Darklirah/One-of-a-Kind-Mars-Rover/Fertigung/README.md

# Fertigungsdaten

> [!CAUTION]
> ## Diese Daten sind **nicht voll funktionsfähig** — bitte nicht bestellen
>
> Die erste Platine ist gebaut und **enthält Fehler**. Am Muster gefunden:
>
> * der **Akkuanschluss J2 ist verpolt**
> * die Stiftleisten für **MPU-6050 (U6)** und **VL53L0X (U7)** sitzen
>   **180° verdreht**; bei U7 sind zusätzlich **SCK und SDA vertauscht**
> * **U2** und **U5** passen nicht zur Pinbelegung der tatsächlich
>   gekauften Module
> * der Schalter **S1** braucht ein anderes Footprint
>
> Die vollständige Liste steht im
> [Projekt-Log](../00_Projekt-Log.md#nächste-platinenrevision--befundliste-nutzer-21102026).
>
> **Diese Fehler sind in den Gerbern dieses Ordners noch enthalten.**
> Sie werden in einer neuen, nummerierten Revision behoben; bis dahin
> taugen die Daten zum Ansehen und Nachvollziehen, nicht zum Fertigen.
>
> Dass das DRC sauber durchläuft, heißt nur, dass das Layout **in sich**
> stimmig ist — nicht, dass die Anschlüsse zu den Modulen passen. Genau
> deshalb steht in der Befundliste: Layout 1:1 ausdrucken und mit den
> echten Modulen gegenprüfen.
>
> **Die Firmware ist davon nicht betroffen** und läuft auf einem nackten
> ESP32-DevKit.

**Alles in diesem Ordner ist erzeugt.** Die Quelle ist `pcb/MarsRover.kicad_pcb`.
Nach jeder Änderung an der Platine neu erzeugen:

```bash
bash Fertigung/erzeuge_fertigungsdaten.sh
```

Sonst liegen hier Gerber, die nicht mehr zur Platine passen — das ist der
klassische Weg, eine falsche Platine zu bestellen.

**Stand: 21.10.2026 — in Bearbeitung.** Das Layout läuft mit 0 DRC-Fehlern
und 0 unverbundenen Elementen durch, hat aber die oben genannten
Anschlussfehler. Eine korrigierte Revision ist in Arbeit.

---

## 1 · Was wohin gehört

| Datei | Wofür |
|---|---|
| `MarsRover-gerber.zip` | **Das lädst du beim Leiterplattenhersteller hoch.** Enthält alle Gerber, beide Bohrdateien und die Bohrpläne |
| `MarsRover-pastenschablone.zip` | Für den Schablonenhersteller: `F_Paste` + `Edge_Cuts` als Gerber, dazu DXF und SVG |
| `MarsRover-stueckliste.csv` | Einkaufsliste, nach Wert und Bauform gruppiert |
| `MarsRover-bestueckung.csv` | Bestückungsdaten (Referenz, Wert, Bauform, X, Y, Drehung, Seite) — nur nötig, wenn du maschinell bestücken lässt |
| `MarsRover-platine.step` | 3D-Modell der **nackten** Platine für den Entwurf des Basismoduls |
| `gerber/`, `pastenschablone/` | derselbe Inhalt unverpackt, zum Nachsehen |

Das vollständige 3D-Modell **mit** Bauteilen liegt unter
`local_Step Files/MarsRover-komplett.step` und bleibt lokal: es enthält
Fremdmodelle aus den KiCad- und Espressif-Bibliotheken, die nicht unsere zum
Weitergeben sind.

---

## 2 · Bestellparameter

| | |
|---|---|
| Lagen | **2** |
| Maße | **70 × 52 mm** |
| Dicke | **1,0 mm** — nicht 1,6 mm, das spart gut 4 g, und Masse ist auf diesem Gerät das Hauptproblem |
| Kupfer | 35 µm (1 oz) |
| Dünnste Leiterbahn | **0,40 mm** |
| Kleinster Abstand | **0,20 mm** |
| Durchkontaktierungen | 91 Stück: 0,8/0,4 mm (88×), 0,7/0,4 (2×), 0,6/0,4 (1×) |
| Kleinste Bohrung | **0,40 mm** (Durchkontaktierungen), 0,75 mm bei Bauteilen |
| Nicht durchkontaktierte Löcher | 6 (Mechanik von OS1/OS2 und S1) |
| Oberfläche | **noch nicht entschieden** — siehe unten |
| Lötstopp / Siebdruck | freie Wahl, elektrisch egal |
| Masseanbindung | **Wärmefallen**, Spalt 0,4 mm, vier Stege à 0,5 mm |

Diese Werte liegen alle im **Standardprozess** der günstigen Fertiger; nichts
davon löst einen Aufpreis aus.

> **Eine Entscheidung steht noch aus: die Oberfläche.** HASL ist am billigsten,
> ENIG kostet wenige Euro mehr und hat eine ebene Oberfläche. Auf dieser
> Platine sitzen 21 SMD-Bauteile, die über eine Pastenschablone bestückt
> werden — dafür ist eine ebene Fläche besser, weil HASL eine unregelmäßig
> dicke Lotbeule auf jedem Pad hinterlässt und die Schablone darauf kippelt.
> Bei 0805 und SOT-23 geht beides; bei ENIG geht es sicherer.

---

## 3 · Pastenschablone

Nur für die **Oberseite**. Auf der Unterseite sitzen nur die beiden TCRT5000
und der Akkustecker, und die sind bedrahtet — `B_Paste` ist deshalb leer.

- **44 Öffnungen**, verteilt auf 21 Bauteile: 9 Kondensatoren und 10
  Widerstände in 0805, 2 MOSFET in SOT-23.
- Rahmenlos bestellen (Framework/Frameless), Dicke **0,12 mm**. Das ist für
  0805 und SOT-23 der übliche Wert; dünner braucht man erst ab 0,5-mm-Raster.

---

## 3a · Wärmefallen an der Massefläche

Die Massefläche auf B.Cu hängt **nicht fest** an den Pads, sondern über
Wärmefallen: sie hält 0,4 mm Abstand zum Pad und greift mit vier Stegen von
0,5 mm Breite darauf zu.

**Warum:** eine 70 × 52 mm große Kupferfläche zieht beim Handlöten die Wärme
schneller ab, als ein Lötkolben sie nachliefert. Das Ergebnis sind kalte
Lötstellen, die beim Messen oft noch leitend wirken und erst bei Vibration
ausfallen — auf diesem Gerät also garantiert.

**Elektrisch kostet das nichts:** vier Stege à 0,5 mm auf 35 µm tragen
zusammen rund 6 A. Der größte Verbraucher auf dieser Masse ist der Step-Up
mit knapp 0,8 A Eingangsstrom, und der hat zwei Pads. Faktor fünfzehn Reserve.

Betroffen sind die **20 bedrahteten** Masse-Pads, die die Fläche direkt
berühren: C1, C11, C12, J2, LED1–LED4, OS1, OS2, U1 (Pins 14/32/38),
U2 (3×), U5 (2×), U6, U7.

Die **16 SMD-Masse-Pads** auf der Oberseite (C2–C10, Q1, Q2, R3, R4, R7, R8,
R17) berühren die Fläche gar nicht — sie hängen über eine kurze Leitung und
eine Durchkontaktierung daran. Dort gibt es nichts zu entlasten, und die
dünne Via-Hülse leitet ohnehin kaum Wärme ab.

---

## 4 · Nullpunkt

Gerber, Bohrdaten und Bestückungsliste benutzen **denselben, absoluten
Nullpunkt** (die Blattkoordinaten von KiCad). Das ist die Bedingung dafür,
dass der Fertiger die drei übereinanderlegen kann. Wenn ein Hersteller einen
Hilfsnullpunkt in einer Platinenecke verlangt, muss er für **alle drei**
Ausgaben umgestellt werden, nicht nur für eine.

---

## 5 · Was das DRC noch meldet, und warum es so bleibt

| Meldung | Anzahl | Warum das in Ordnung ist |
|---|---|---|
| `courtyards_overlap` | 21 | Alle unter U1. Das DevKit steckt auf Buchsenleisten gut 8,5 mm über der Platine; darunter liegt absichtlich alles Flache |
| `pth_inside_courtyard` | 4 | Die Pads von D1/D2, gleicher Grund |
| `lib_footprint_mismatch` | 4 | **Gewollte Abweichungen:** U1 trägt ein 3D-Modell, das die Bibliothek nicht hat, M1/M2 ein Feld „Hinweis" mit der Lötaugen-Begründung. Ohne Auswirkung auf die Fertigung — die Gerber kommen aus der Platinendatei, nicht aus der Bibliothek |

---

## 6 · Vor dem Bestellen prüfen

- [ ] **Reihenabstand des DevKits mit dem Messschieber nachmessen.** Soll:
      **25,4 mm**. Die 30-polige Version hat ein anderes Rastermaß, dann passt
      die Platine nicht. Siehe [Doku/09](../Doku/09_Boardwahl-DevKitC-V4.md)
- [ ] Oberfläche entscheiden (Abschnitt 2)
- [ ] Gerber in einem Betrachter gegenlesen — der Fertiger prüft nicht mit
- [ ] **MT3608 umbauen, bevor er eingelötet wird:** Poti raus, 110 kΩ / 15 kΩ
      rein. Siehe [Doku/07 Schritt 1a](../Doku/07_Inbetriebnahme-und-Tuning.md)
