Darklirah/One-of-a-Kind-Mars-Rover/Doku/Ich_baue_meinen_Marsrover.md

# Ich baue meinen Marsrover

Eine Anleitung Schritt für Schritt: erst die Platine löten, dann das Gehäuse
zusammensetzen, zum Schluss alles verkabeln.

> **Bitte vorher lesen:** Diese Anleitung ist am 3D-Modell entstanden. Der
> Rover ist in dieser Form **noch nicht real gebaut worden** — es kann also
> sein, dass an einer Stelle etwas klemmt oder nachgearbeitet werden muss.
> Die Bilder kommen direkt aus dem Modell. **Orange** ist immer das, was in
> diesem Schritt neu dazukommt.

> [!CAUTION]
> **Die Leiterplatte der Revision 1 ist nicht voll funktionsfähig.** Am
> gebauten Muster sind Anschlussfehler aufgefallen: der Akkuanschluss ist
> verpolt, zwei Stiftleisten sitzen 180° verdreht, bei einer sind zusätzlich
> SCK und SDA vertauscht, und die Leisten für Lademodul und DC/DC-Wandler
> passen nicht zu den gekauften Modulen. **Nach dieser Platine bitte noch
> nichts bestellen und nichts verlöten** — eine korrigierte Revision ist in
> Arbeit. Befundliste:
> [Projekt-Log](../00_Projekt-Log.md#nächste-platinenrevision--befundliste-nutzer-21102026),
> Einzelheiten in [`pcb/README.md`](../pcb/README.md).

---

## Was du brauchst

**Werkzeug**

- Lötkolben mit feiner Spitze, Lötzinn
- Seitenschneider, kleine Zange, Pinzette
- Multimeter
- doppelseitiges Schaumklebeband, ein Tropfen Sekundenkleber

**Teile**

- die Platine — die kleinen SMD-Bauteile sind schon drauf
- die bedrahteten Bauteile aus der [Stückliste](03_Stueckliste-BOM.md)
- ESP32 DevKitC V4, die Module MPU-6050, VL53L0X, TP4056 und MT3608
- 2 Vibrationsmotoren, 2 Zahnbürstenköpfe, Akku 503035
- Holz-Schaschlikspieß Ø 3 mm, auf 70 mm abgelängt
- 4 dünne Litzen, je etwa 9 cm (für den Sensor im Mast)
- die Druckteile aus [Gehaeuse_CAD](../Gehaeuse_CAD/README.md): 1 Bodenschale,
  2 Bürstenträger, 1 Mastkopf, 4 Tüllen aus TPU

**Drei Regeln fürs Löten**

1. **Erst die flachen Teile, dann die hohen.** Sonst liegt die Platine beim
   Löten nicht mehr flach.
2. **Auf die Richtung achten.** Dioden, LEDs und Elkos funktionieren nur
   richtig herum. Der Aufdruck auf der Platine zeigt, wie.
3. **Drähte nach dem Löten kurz abschneiden** — höchstens 2 mm stehen lassen.

---

# Teil 1 · Die Platine bestücken

## Schritt 1 — Die Platine ansehen

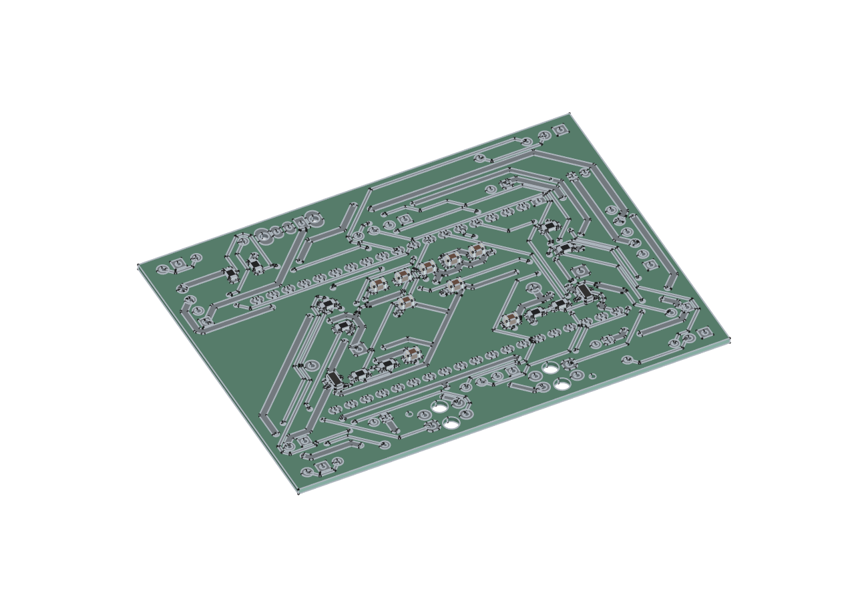
[picture p8: Doku/bilder/bauanleitung/pcb_01_start.png]
Platine nur mit SMD-Bauteilen


So sieht die Platine am Anfang aus. Die winzigen Bauteile sind schon
aufgelötet. Lege dir die Platine so hin, dass du den Aufdruck lesen kannst,
und suche die Namen der Bauteile: `R9`, `D1`, `LED1` und so weiter.

## Schritt 2 — Widerstände und Dioden

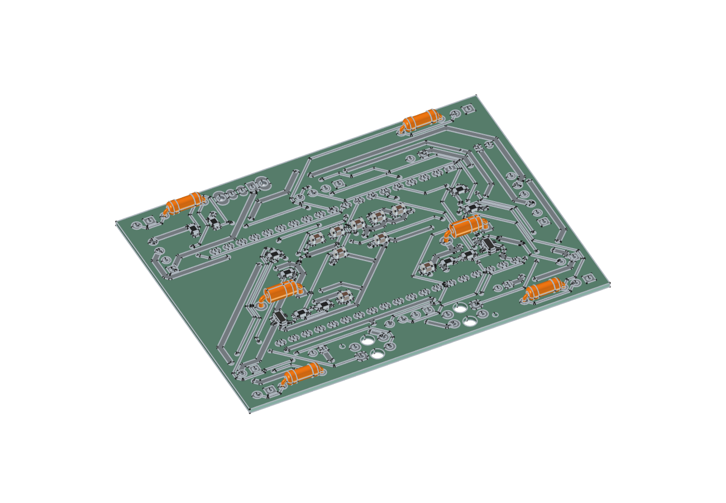
[picture p9: Doku/bilder/bauanleitung/pcb_02_widerstaende_dioden.png]
Vier Widerstände und zwei Dioden


| Bauteil | Platz | Achte auf |
|---|---|---|
| 4 Widerstände 220 Ω | `R9`, `R10`, `R11`, `R12` | Richtung ist egal |
| 2 Dioden 1N5819 | `D1`, `D2` | **Der Ring auf der Diode muss zum Strich im Aufdruck zeigen** |

Beine umbiegen, durchstecken, Platine umdrehen, löten, Drähte abschneiden.

## Schritt 3 — Die Unterseite: Liniensensoren und Akkustecker

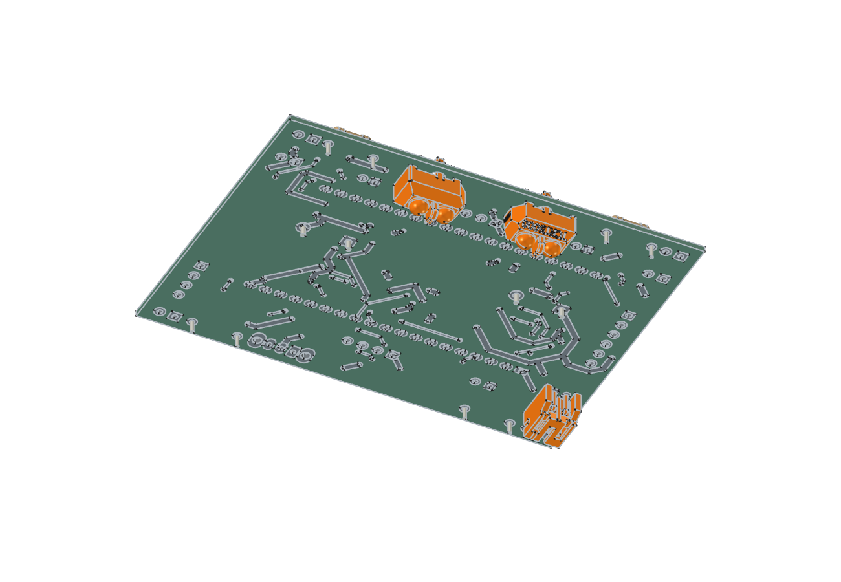
[picture p10: Doku/bilder/bauanleitung/pcb_03_unterseite.png]
Unterseite mit zwei Sensoren und Stecker


Jetzt die Platine **umdrehen**. Diese drei Teile sitzen auf der Unterseite
und werden von der Oberseite her gelötet.

| Bauteil | Platz | Achte auf |
|---|---|---|
| 2 Liniensensoren TCRT5000 | `OS1`, `OS2` | Die abgeschrägte Ecke gehört dorthin, wo sie der Aufdruck zeigt. **Die beiden Sensoren sitzen gegeneinander verdreht** |
| 1 Akkustecker JST-PH, liegend | `J2` | So herum, wie der Aufdruck es zeigt |

Die Sensoren müssen ganz flach aufliegen und beide gleich hoch sein. Sonst
sieht der eine die Linie besser als der andere.

## Schritt 4 — Stiftleisten und Buchsenleisten

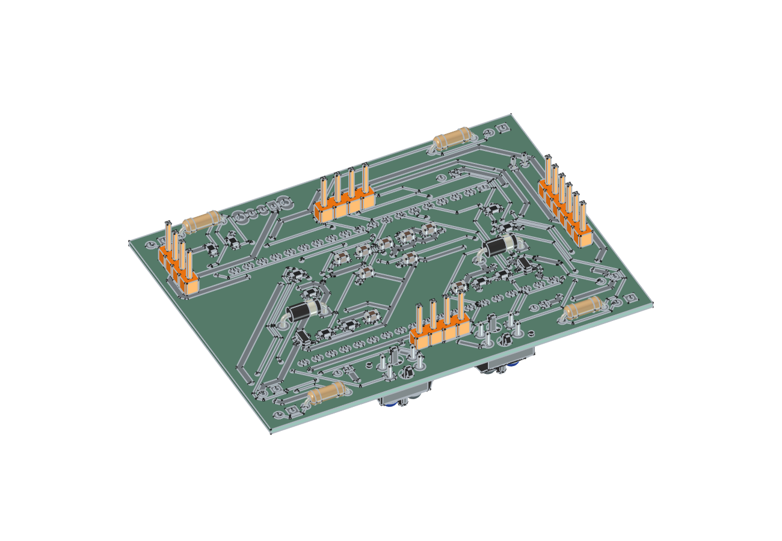
[picture p11: Doku/bilder/bauanleitung/pcb_04_stiftleisten.png]
Vier Stiftleisten


| Bauteil | Platz | Wofür |
|---|---|---|
| Stiftleiste 6-polig | `U2` | Laderegler |
| Stiftleiste 4-polig | `U5` | Step-Up-Wandler |
| Stiftleiste 4-polig | `U6` | Lagesensor |
| Stiftleiste 4-polig | `U7` | Kabel zum Sensor im Mast |
| 2 Buchsenleisten 19-polig | `U1` | Hier wird später der ESP32 eingesteckt |

**Tipp für gerade Leisten:** erst nur einen Stift anlöten, prüfen, ob die
Leiste senkrecht steht, dann den Rest.

Die beiden Plätze `M1` und `M2` bleiben frei. Dort kommen später die Litzen
der Motoren hinein.

## Schritt 5 — Schalter und LEDs

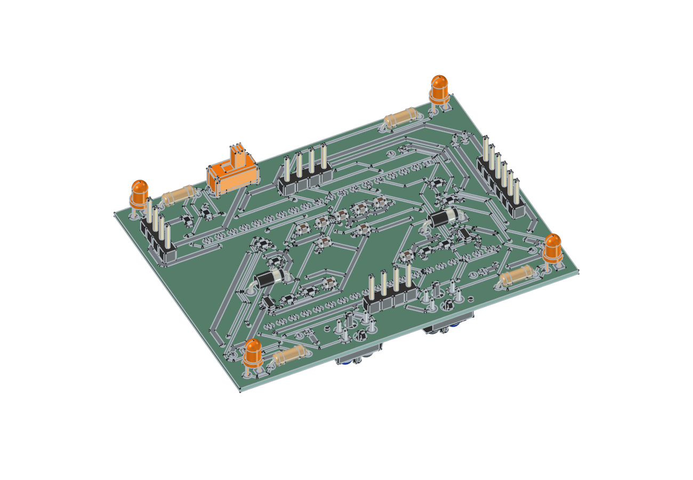
[picture p12: Doku/bilder/bauanleitung/pcb_05_schalter_leds.png]
Schalter und vier LEDs


| Bauteil | Platz | Achte auf |
|---|---|---|
| Schiebeschalter | `S1` | Richtung ist egal |
| 2 LEDs gelb | `LED1`, `LED2` (vorn) | **Das lange Bein ist Plus.** Die flache Seite am Gehäuse der LED zeigt zur flachen Seite im Aufdruck |
| 2 LEDs rot | `LED3`, `LED4` (hinten) | wie oben |

## Schritt 6 — Die Elkos

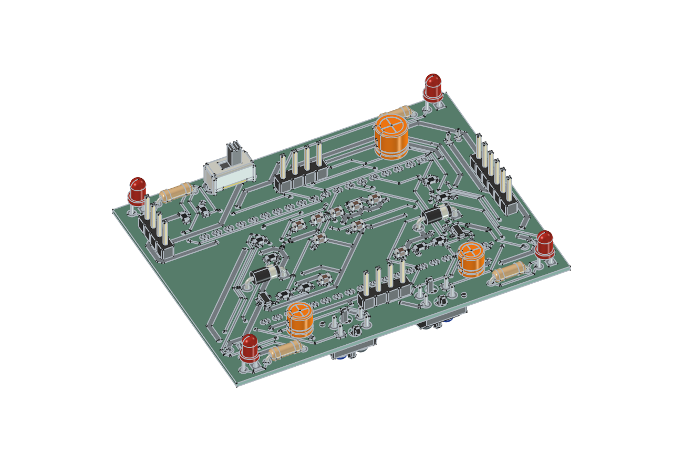
[picture p13: Doku/bilder/bauanleitung/pcb_06_elkos.png]
Drei Elkos


| Bauteil | Platz | Achte auf |
|---|---|---|
| 2 Elkos 47 µF | `C11`, `C12` | **Der helle Streifen auf dem Elko ist Minus.** Plus ist im Aufdruck mit `+` markiert |
| 1 Elko 100 µF | `C1` | wie oben |

Ein falsch herum eingelöteter Elko geht kaputt, sobald Strom fließt. Lieber
zweimal hinsehen.

## Schritt 7 — Die Module vorbereiten

Bevor die Module auf die Platine kommen, müssen zwei von ihnen umgebaut
werden. Das geht nur, solange sie noch lose auf dem Tisch liegen.

- **MT3608 (Step-Up-Wandler):** Das kleine Drehpoti auslöten und durch zwei
  feste Widerstände ersetzen (110 kΩ und 15 kΩ). Danach im Leerlauf
  nachmessen: am Ausgang müssen **5,0 V** anliegen. Die genaue Beschreibung
  steht in [Inbetriebnahme, Schritt 1a](07_Inbetriebnahme-und-Tuning.md).
- **TP4056 (Laderegler):** Den Widerstand für den Ladestrom gegen 4,7 kΩ
  tauschen, sonst wird der kleine Akku zu schnell geladen.

> **Achtung beim Laderegler:** Es gibt ihn mit und ohne Schutzschaltung. Die
> Platine ist für ein Modul **mit** Schutzschaltung und sechs Anschlüssen
> gedacht. Hat dein Modul nur vier Anschlüsse (`IN+`, `IN−`, `BAT+`,
> `BAT−`), dann gilt:
>
> - `BAT+` kommt an Pin 3 von `U2`, `BAT−` an Pin 4.
> - **Pin 3 und Pin 5 von `U2` mit einem Drahtstück verbinden.** Ohne diese
>   Brücke bekommt der Rover keinen Strom.
> - Der Akku muss dann eine **eigene Schutzplatine** haben (meist unter dem
>   gelben Klebeband am Kabelende). Sonst kann er tiefentladen werden.
>
> Die ganze Belegung steht in der
> [Pinbelegung](05_Pinbelegung.md#modulanschlüsse-auf-der-platine).

## Schritt 8 — ESP32 einstecken

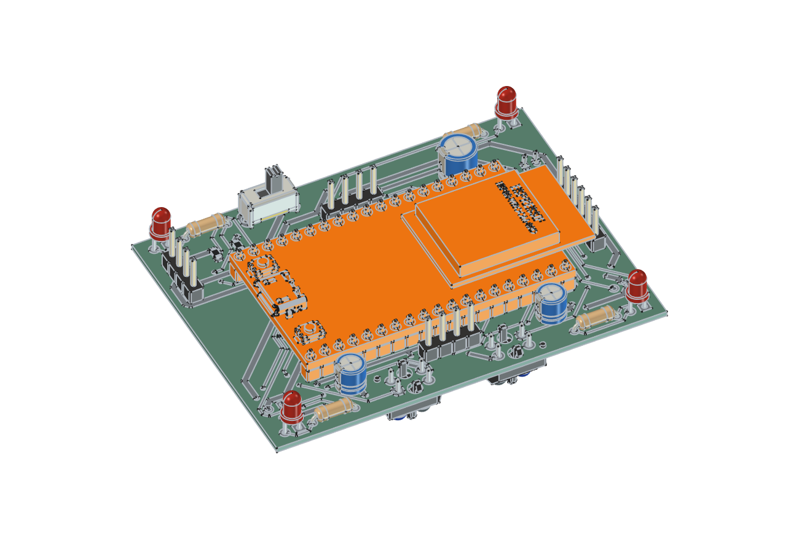
[picture p14: Doku/bilder/bauanleitung/pcb_07_devkit.png]
ESP32 DevKit auf der Platine


Den ESP32 in die beiden Buchsenleisten stecken. Die Antenne (das Ende mit
dem Metalldeckel) zeigt zu der Seite, an der `U2` sitzt, der USB-Anschluss
zur anderen. Gleichmäßig drücken, nicht verkanten.

## Schritt 9 — Die Module aufsetzen

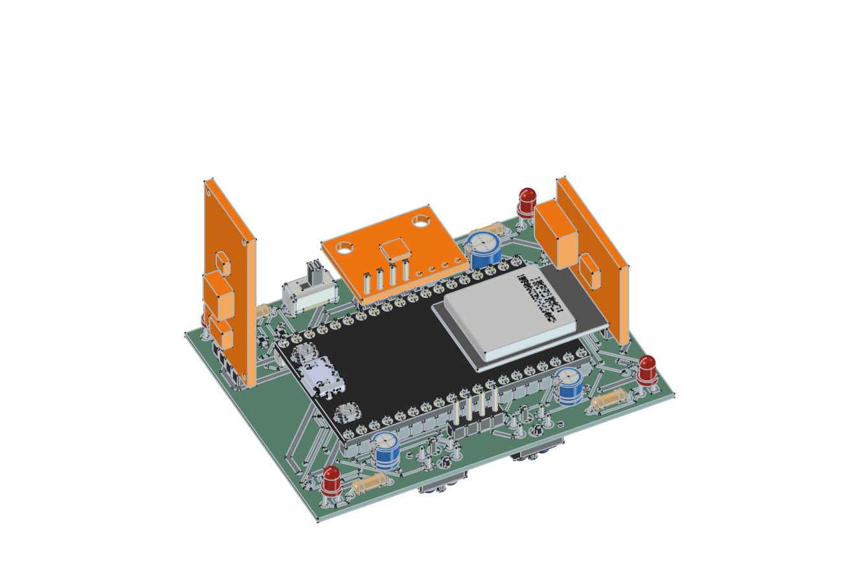
[picture p15: Doku/bilder/bauanleitung/pcb_08_module.png]
Laderegler, Step-Up-Wandler und Lagesensor


| Modul | Platz | So sitzt es |
|---|---|---|
| TP4056 | `U2` | steht senkrecht am Rand |
| MT3608 | `U5` | steht senkrecht am Rand, **darf den USB-Anschluss des ESP32 nicht verdecken**. Seine vier Lötaugen sitzen an den Ecken — zwei davon mit kurzen Drahtstücken zur Leiste führen |
| MPU-6050 | `U6` | liegt flach, ragt nach hinten über den Platinenrand |

Die Module werden auf die Stiftleisten gesetzt und verlötet. Der Lagesensor
soll fest sitzen und nicht wackeln — genau dieses Wackeln würde er sonst
messen.

**Die Platine ist jetzt fertig.** Bevor sie ins Gehäuse kommt: einmal mit dem
Multimeter prüfen, ob zwischen Plus und Minus kein Kurzschluss ist.

---

# Teil 2 · Das Gehäuse zusammensetzen

## Schritt 10 — Die Bodenschale

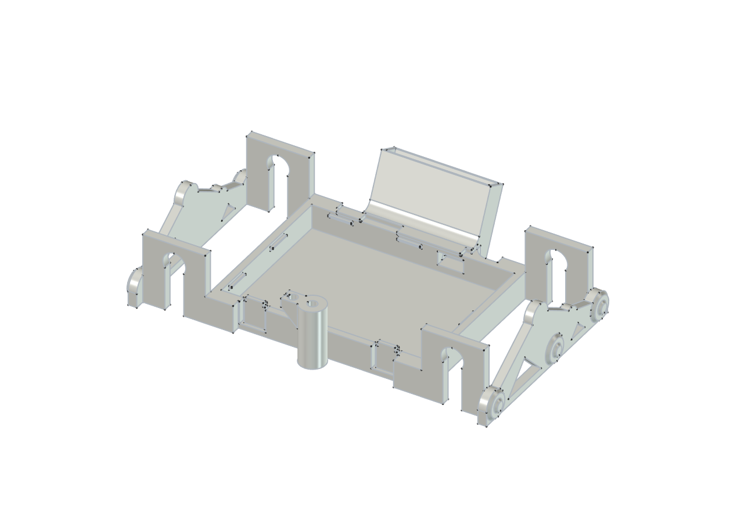
[picture p16: Doku/bilder/bauanleitung/geh_01_bodenschale.png]
Die Bodenschale


Das ist das Hauptteil. Sieh dir an, was wo ist:

- **vorn** der runde Mastfuß mit der kleinen Kabelöse daneben
- **hinten** die schräge Tasche mit den Rippen — dort kommt der Akku hinein
- **links und rechts** das Fahrwerk mit je zwei Gabeln, die nach unten offen sind
- **innen vorn** zwei Rasthaken, **innen hinten** eine Nut

Reste vom Druck entfernen. Die beiden Rasthaken vorsichtig mit dem Finger
nach außen drücken: sie müssen federn.

## Schritt 11 — Zwei Antriebe bauen

Bürstenträger mit Motor, Bürste und Tüllen

Das machst du zweimal, einmal für links und einmal für rechts.

1. **Bürstenkopf ankleben.** Ein Stück Schaumklebeband auf die glatte Seite
   des Bürstenkopfs, dann mittig unter den Bürstenträger drücken. Die Borsten
   zeigen nach unten.
2. **Motor einklipsen.** Den Motor von oben in die beiden Schellen drücken.
   Das kleine Gewicht an der Welle (die Unwucht) zeigt nach **vorn** und
   sitzt genau über der Mitte der Bürste. Es muss sich frei drehen können.
3. **Tüllen aufstecken.** Auf jeden der beiden Zapfen eine schwarze Tülle
   schieben, bis sie hinter dem Kopf des Zapfens sitzt.

**Wichtig:** Beide Motoren gleich herum einsetzen — bei beiden zeigt die
Unwucht nach vorn.

## Schritt 12 — Die Antriebe einklipsen

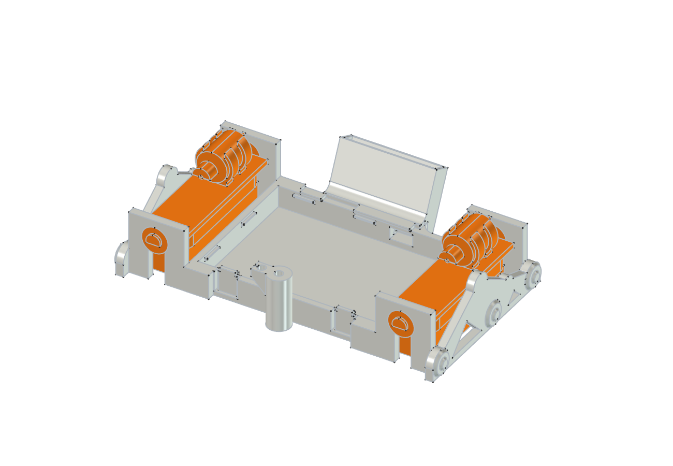
[picture p17: Doku/bilder/bauanleitung/geh_03_antrieb_einbau.png]
Beide Antriebe in der Bodenschale


Die Bodenschale umdrehen. Einen Antrieb von unten so ansetzen, dass beide
Tüllen vor den Gabeln liegen, und dann hineindrücken, bis die Tüllen
einrasten. Dasselbe auf der anderen Seite.

Probe: Der Antrieb darf das Gehäuse nirgends berühren. Er hängt nur in den
beiden weichen Tüllen und lässt sich leicht hin und her bewegen.

---

# Teil 3 · Einbauen und verkabeln

## Schritt 13 — Motoren anlöten

Solange die Platine noch draußen ist, die Litzen der beiden Motoren in die
Löcher bei `M1` (links) und `M2` (rechts) löten. Die Litzen so lang lassen,
dass sie in einem lockeren Bogen zum Motor laufen — ein straffes Kabel würde
die Vibration aufs Gehäuse übertragen.

**Bei einem der beiden Motoren die zwei Litzen vertauschen.** Dann drehen
die Motoren gegenläufig, und der Rover läuft geradeaus statt zur Seite.

## Schritt 14 — Die Platine lose einlegen

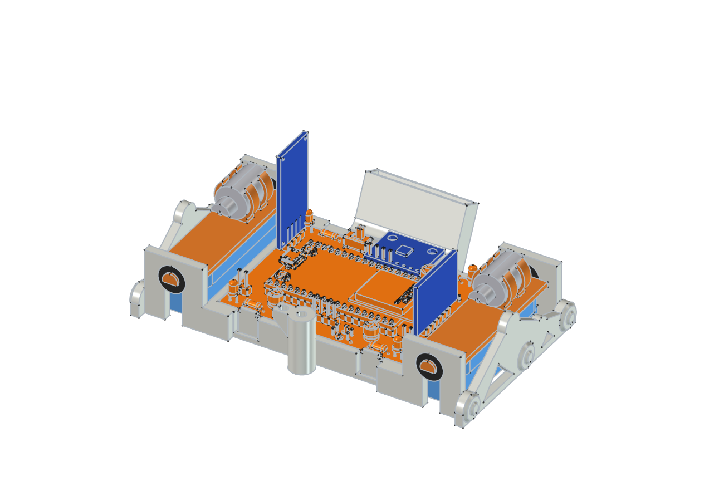
[picture p18: Doku/bilder/bauanleitung/geh_04_platine.png]
Platine in der Bodenschale


Die Platine schräg halten und mit der **hinteren** langen Kante unter die
Nut schieben. Vorn nur auflegen, **noch nicht einrasten** — sie muss gleich
noch einmal angehoben werden.

Der Akku ist noch nicht angeschlossen. Das bleibt so, bis alles gelötet ist.

## Schritt 15 — Mast und Abstandssensor

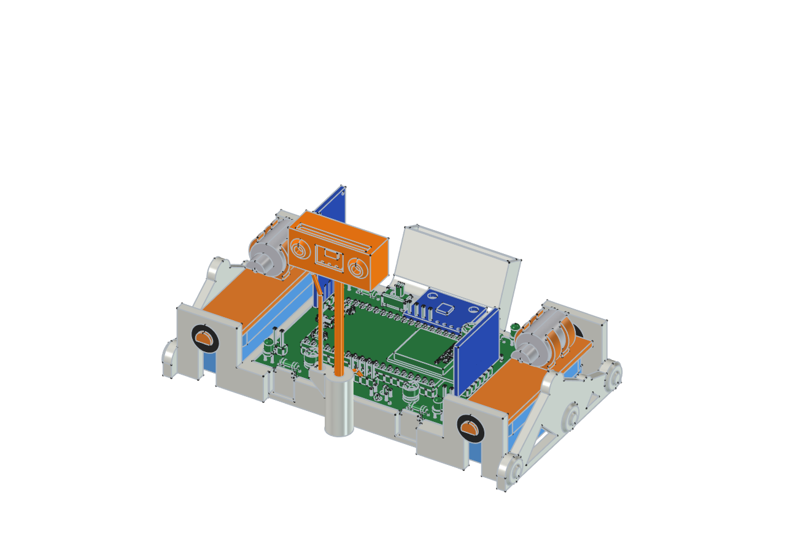
[picture p19: Doku/bilder/bauanleitung/geh_05_mast.png]
Mast mit Kopf, Sensor und Kabel


Der Sensor VL53L0X braucht vier Leitungen: `VIN`, `GND`, `SCL` und `SDA`.

1. **Litzen an den Sensor löten.** Vier Litzen von etwa 9 cm in die Lötaugen
   `VIN`, `GND`, `SCL` und `SDA` des Moduls löten. Am besten vier
   verschiedene Farben nehmen und aufschreiben, welche wohin gehört. Die
   Lötaugen `XSHUT` und `GPIO1` bleiben frei.
2. **Sensor in den Mastkopf.** Das Modul von oben in den Schlitz schieben —
   die Lötaugen nach unten, der kleine schwarze Sensor schaut nach vorn
   durch das Fenster. Die Litzen kommen unten aus dem Kabelauslass.
3. **Mast einstecken.** Den Holzspieß mit einem Tropfen Kleber in den Mastfuß
   stecken, dann den Mastkopf oben aufsetzen. Der Kopf schaut geradeaus nach
   vorn, **nicht nach unten** — sonst misst er die Tischplatte.
4. **Kabel führen.** Die vier Litzen leicht verdrillen und am Mast entlang
   nach unten führen. Unten seitlich in die geschlitzte **Kabelöse** drücken.
5. **Schlaufe lassen.** Zwischen Öse und Platine einen kleinen Bogen lassen.
   Der Mast schwingt beim Fahren; ohne Schlaufe bricht das Kabel an der
   Lötstelle.
6. **An `U7` anschließen.** Die vier Litzen an die Stiftleiste `U7` löten.
   Pin 1 ist das **eckige** Lötauge:

   | Pin an `U7` | Litze vom Sensor |
   |---|---|
   | 1 | `VIN` |
   | 2 | `GND` |
   | 3 | `SCL` |
   | 4 | `SDA` |

## Schritt 16 — Akku einsetzen, anstecken, Platine einrasten

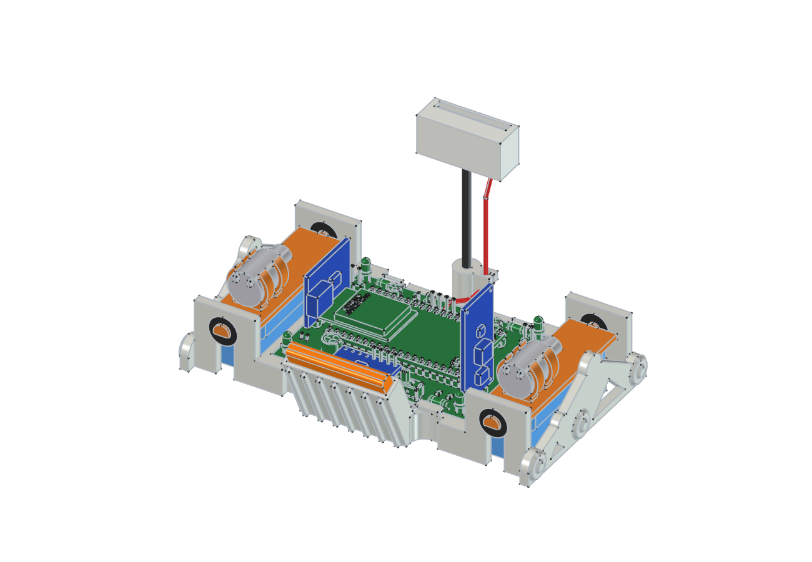
[picture p20: Doku/bilder/bauanleitung/geh_06_akku.png]
Akku in der Tasche am Heck


Ab jetzt wird nicht mehr gelötet. Den Schalter `S1` auf **Aus** stellen.

> **Die Reihenfolge ist wichtig.** Der Akkustecker sitzt **unter** der
> Platine. Ist die Platine erst eingerastet, kommst du nicht mehr heran.
> Also: erst der Akku in die Tasche, dann das Kabel nach innen, dann
> anstecken — und **ganz zum Schluss** die Platine einrasten.

1. **Akku in die Tasche schieben.** Den Akku von oben in die schräge Tasche
   am Heck schieben, das Kabel nach unten. Er steht etwa 5 mm über — daran
   kannst du ihn wieder herausziehen.
2. **Kabel nach innen fädeln.** Den Stecker durch das kleine Fenster unten
   links an der Akkutasche in die Bodenschale führen. Geht es mit
   eingeschobenem Akku zu eng, den Akku ein Stück anheben, den Stecker
   durchfädeln und den Akku wieder ganz hineinschieben.
3. **Polung prüfen.** Plus am Akkustecker muss zu Plus im Aufdruck bei `J2`
   passen. Die Stecker sind nicht genormt. **Falsch herum geht der
   Laderegler sofort kaputt.**
4. **An die Platine stecken.** Die Platine vorn anheben und den Stecker in
   `J2` auf der Unterseite stecken.
5. **Erst jetzt einrasten.** Die vordere Kante der Platine nach unten
   drücken, bis beide Haken hörbar einrasten.

Die Platine liegt jetzt ringsum auf kleinen Auflagen. Kein Kabel darf
darunter eingeklemmt sein.

Sitzt der Akku zu locker, ein kleines Stück Schaumklebeband in die Tasche
kleben.

**Wieder herausnehmen:** beide Haken vorn leicht nach außen drücken, die
Platine vorn anheben und den Akkustecker abziehen. Erst danach lässt sich
der Akku ganz herausnehmen.

## Fertig!

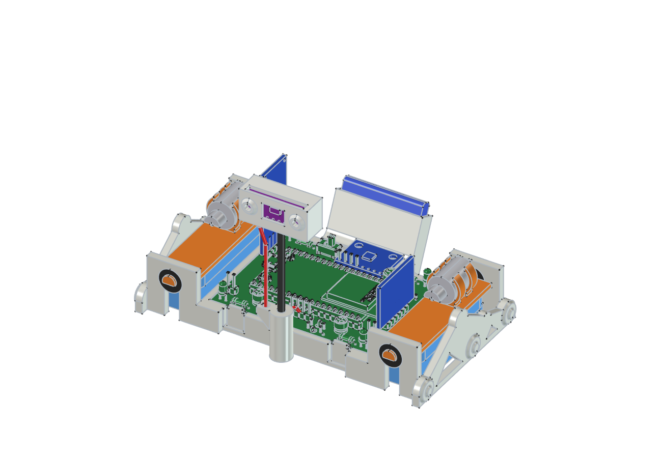
[picture p21: Doku/bilder/bauanleitung/geh_07_fertig.png]
Der fertige Rover


Zum Schluss noch einmal prüfen:

- [ ] Beide Antriebe hängen frei und berühren das Gehäuse nicht
- [ ] Die beiden Unwuchten können sich frei drehen
- [ ] Die Liniensensoren unten sind frei und sauber
- [ ] Kein Kabel liegt auf einer Unwucht oder unter der Platine
- [ ] Der Mastkopf schaut waagerecht nach vorn

Jetzt den Schalter `S1` einschalten. Wie es weitergeht — Firmware
aufspielen, mit dem Handy verbinden, Sensoren einstellen — steht in
[Inbetriebnahme und Tuning](07_Inbetriebnahme-und-Tuning.md).
