Darklirah/One-of-a-Kind-Mars-Rover/Doku/03_Stueckliste-BOM.md

# Stückliste (BOM)

Für **Variante A**: ESP32 DevKitC V4 (38-Pin) gesteckt, 2× TCRT5000,
WLAN-Fernsteuerung. Preise sind Richtwerte in Euro für Einzelstück,
europäische Distributoren, Stand Oktober 2026, ohne Versand.

> Stand 11.10.2026 (gekaufte Teile nachgetragen). Maßgeblich ist der Schaltplan `pcb/MarsRover.kicad_sch`;
> im Zweifel gilt dessen Netzliste, nicht diese Tabelle.

> [!CAUTION]
> **Leiterplatte Revision 1 ist nicht voll funktionsfähig und wird
> überarbeitet.** Am gebauten Muster sind Anschlussfehler aufgefallen —
> verpolter Akkuanschluss, zwei verdrehte Stiftleisten, vertauschte
> I²C-Leitungen, nicht passende Modulanschlüsse. Nichts davon bestellen
> oder nachbauen, bis die korrigierte Revision vorliegt. Befundliste:
> [Projekt-Log](../00_Projekt-Log.md#nächste-platinenrevision--befundliste-nutzer-21102026).
> Die **Firmware ist nicht betroffen.**

Bauteilkürzel (`U1`, `R5` …) entsprechen der
[Netzliste](../Hardware/Netzliste.md) und der [Pinbelegung](05_Pinbelegung.md).

---

## 1 · Rechenkern

| Pos | Bauteil | Menge | Bauform | € | Bemerkung |
|---|---|---|---|---|---|
| U1 | **ESP32 DevKitC V4, 38-Pin** (AZ-Delivery) | 1 | THT, gesteckt | 5,50 | Reihenabstand **25,4 mm**, Platinenlänge 54,4 mm. Begründung in [09](09_Boardwahl-DevKitC-V4.md) |
| — | Buchsenleiste 19-pol, RM 2,54, gerade | 2 | THT | 0,80 | U1 steckbar halten, nicht einlöten |

> Das DevKit bringt USB-Buchse, CP2102/CH340 und den 3,3-V-Regler AMS1117 selbst
> mit. Deshalb fehlen in dieser Stückliste USB-UART-Brücke und Boot-Taster.

---

## 2 · Laden und Spannungsversorgung

### 2a · Variante „diskret auf eigenem PCB"

| Pos | Bauteil | Menge | Bauform | € | Bemerkung |
|---|---|---|---|---|---|
| U2 | TP4056 Lade-IC | 1 | SOP-8 | 0,45 | 1-zelliger LiPo-Lader, 4,2 V |
| U3 | DW01A Schutz-IC | 1 | SOT-23-6 | 0,35 | Tiefentladung, Überladung, Kurzschluss |
| U4 | FS8205A Doppel-MOSFET | 1 | SOT-23-6 | 0,45 | **Schaltelement für U3 — ohne das schützt U3 nichts** |
| J1 | USB-C-Buchse, 16-pol, nur Power | 1 | SMD | 0,45 | Mit Durchsteck-Haltelaschen wählen |
| R13, R14 | 5,1 kΩ, 1 % | 2 | 0805 | 0,02 | **Je einer von CC1 und CC2 nach GND. Pflicht, sonst keine 5 V** |
| R15 | **4,7 kΩ** (R_prog) | 1 | 0805 | 0,01 | Setzt 255 mA Ladestrom für eine 500-mAh-Zelle. Tabelle: [Review B9](01_Schaltplan-Review.md) |
| — | 10 µF + 100 nF an U2 | je 1 | 0805 | 0,05 | Ein- und Ausgangsentkopplung des Laders |
| — | LED 0805 rot + grün, je 1 kΩ | 2 | 0805 | 0,10 | Ladezustandsanzeige CHRG / STDBY, optional |

### 2b · Variante „Fertigmodul" — empfohlen für den Erstaufbau

| Pos | Bauteil | Menge | € | Bemerkung |
|---|---|---|---|---|
| U2–U4 | **TP4056-Ladeplatine mit USB-C und Schutzschaltung** | 1 | 1,50 | Enthält TP4056, DW01A, FS8205A, USB-C-Buchse und die CC-Widerstände |

> ### Tatsächlich gekauft: TP4056 mit Mini-USB, **ohne** Schutzschaltung
>
> Das beschaffte Modul (roboter-bausatz.de, RBS10084) hat nur **vier**
> Anschlüsse — `IN+`, `IN−`, `BAT+`, `BAT−` — und laut Händler keine
> Schutzfunktionen. Die Platine erwartet an `U2` sechs Anschlüsse, darunter
> einen eigenen Schutzausgang `OUT+`.
>
> **So passt es trotzdem:** `BAT+` des Moduls an Pin 3 von `U2`, `BAT−` an
> Masse (Pin 4), und **Pin 3 mit Pin 5 brücken** — sonst bekommt der
> Schalter keinen Strom. Die vollständige Belegung steht in der
> [Pinbelegung](05_Pinbelegung.md#modulanschlüsse-auf-der-platine).
>
> **Was dann fehlt:** der Schutz gegen Tiefentladung, Überstrom und
> Kurzschluss. Das ist nur vertretbar, wenn der **Akku selbst** eine
> Schutzplatine hat (bei Zellen mit angelötetem Kabel meist unter dem gelben
> Klebeband am Kabelende — nachsehen). Hat er keine, ein Modul **mit**
> Schutzschaltung und sechs Anschlüssen nehmen.

> Beim Fertigmodul musst du trotzdem **R_prog tauschen**: die Module laden mit
> 1 A (1,2 kΩ, oft als `R3` bedruckt). Den 1,2-kΩ-Widerstand ablöten und 4,7 kΩ
> einsetzen. Sonst lädst du eine 500-mAh-Zelle mit 2 C.

### 2c · Schiene und Schalter

| Pos | Bauteil | Menge | Bauform | € | Bemerkung |
|---|---|---|---|---|---|
| U5 | **MT3608 Step-Up-Modul**, einstellbar, 36 × 17 × 14 mm | 1 | THT-Modul | 1,20 | Gekauft: roboter-bausatz.de „MT3608 DC-DC Step-Up 2A". Vier Lötaugen an den Ecken (`VIN+`, `VIN−`, `VOUT+`, `VOUT−`). **Wird umgebaut:** Poti raus, Festteiler rein — siehe Zeile darunter und [Inbetriebnahme Schritt 1a](07_Inbetriebnahme-und-Tuning.md) |
| — | Metallschicht **110 kΩ** und **15 kΩ**, 1 % | je 1 | 0805 oder 0207 | 0,04 | **Modulumbau U5.** Ersetzen das Trimmpoti: 110 kΩ von VOUT nach FB, 15 kΩ von FB nach GND → $0{,}6 \times (1+110/15) = 5{,}00$ V. Gehören aufs Modul, nicht auf die Platine — deshalb ohne Referenz |
| S1 | Schiebeschalter SPDT, THT | 1 | THT | 0,45 | Zwischen Akku-Schutzausgang und Eingang von U5 — nicht direkt an die Zelle |
| C1 | 100 µF / **10 V** Elektrolyt | 1 | THT, Ø 6,3 mm | 0,18 | Am Ausgang von U5. 10 V reichen bei 5 V Schiene, zweifache Reserve ist bei Alu-Elkos üblich |
| C2 | 10 µF Keramik / **25 V** | 1 | 0805 | 0,12 | **Nicht 10 V nehmen.** Ein X5R/X7R verliert unter Gleichspannung Kapazität; bei 5 V bleibt von einem 10-V-Typ oft nur die Hälfte übrig |
| C5 | 100 nF Keramik | 1 | 0805 | 0,02 | Parallel zu C1/C2. Der Alu-Elko ist oberhalb ~100 kHz wirkungslos, U5 taktet mit 1,2 MHz |
| D3 | Zenerdiode BZX55C5V6 | 1 | THT | 0,08 | *Optional, aber empfohlen:* Notbremse gegen einen falsch eingestellten U5 |
| BT1 | LiPo 3,7 V, **500 mAh**, JST-PH 2.0 | 1 | — | 7,50 | Bauform 503035. 150 mAh ist zu klein, siehe [Review B8](01_Schaltplan-Review.md) |
| J2 | JST-PH-2.0-Buchse, 2-pol, THT | 1 | THT | 0,25 | Polung zweimal prüfen — die Zellen sind nicht genormt belegt |

---

## 3 · Motortreiber

| Pos | Bauteil | Menge | Bauform | € | Bemerkung |
|---|---|---|---|---|---|
| M1, M2 | **Vibrationsmotor Zylinder, Ø 12 × 22,5 mm**, 1,5–3 V (sourcing map) | 2 | **abgesetzt** | — | Gekauft im 5er-Pack. Nennstrom laut Händler **140 mA** — bei welcher Spannung, ist nicht angegeben; am Motor nachmessen. Unwucht Ø 7 × 5 mm. Ersetzt den ursprünglich geplanten Münzmotor Ø 10 mm (≈ 80 mA): kräftiger, aber schwerer. **Masse nicht gewogen**, im Gehäuseentwurf mit 6 g je Stück angesetzt |
| — | **Lötaugen für M1/M2** | 2× 2 | THT, Ø 1,0 mm | — | Fußabdruck `PinHeader_1x02_P2.54mm_Vertical`. Die Motoren sitzen **nicht** auf der Platine; Litze direkt in die durchkontaktierten Löcher löten |
| Q1, Q2 | **AO3400A** Logik-MOSFET | 2 | SOT-23 | 0,20 | Low-Side-Schalter, 28 mΩ bei 4,5 V Gate, 5,7 A. **Muss ein Logic-Level-Typ sein** — 2N7000, BS170 und IRF540 sind bei 3,3 V Gate praktisch zu |
| R1, R2 | 100 Ω | 2 | 0805 | 0,02 | Gate-Widerstand, dämpft die Schaltflanke |
| R3, R4 | **100 kΩ** | 2 | 0805 | 0,02 | **Gate-Pulldown nach GND — verhindert Motorzucken beim Booten** |
| D1, D2 | **1N5819** Schottky | 2 | THT DO-41 | 0,16 | Freilauf, antiparallel zum Motor. 1N4148 wäre zulässig, aber schlechter |
| C3, C4 | 100 nF Keramik | 2 | 0805 | 0,04 | Direkt am Drain jedes MOSFETs nach GND. Das ist die Funkentstörung an der Motorklemme |
| C11, C12 | **47 µF / 10 V Elektrolyt** | 2 | THT, Ø 5 mm | 0,24 | Je Motorstufe, **von +5 V nach GND** — siehe Kasten unten |

> ### Warum die 47 µF nicht über die Motorklemmen gehören
>
> Über den Klemmen läge der Elko parallel zum MOSFET. Bei jedem Einschalten
> entlädt er sich über den FET, begrenzt nur durch ESR und Bahnwiderstand —
> das sind Ampere, und zwar **20 000-mal je Sekunde** bei 20 kHz PWM. Ein
> 47-µF-Radialelko verträgt etwa 100–200 mA Rippelstrom; er wäre in Wochen
> trocken, und der AO3400A bekäme die Stöße umsonst ab.
>
> Von **+5 V nach Masse**, direkt an der Stufe, erfüllt er denselben Zweck:
> Er liefert den Stromimpuls der Motoren örtlich und hält ihn aus dem Rest
> der Platine heraus, wo das ADC-Frontend der Liniensensoren sitzt.

---

## 4 · Liniensensorik

| Pos | Bauteil | Menge | Bauform | € | Bemerkung |
|---|---|---|---|---|---|
| OS1, OS2 | **TCRT5000** Reflexkoppler | 2 | THT, 4-pol | 0,90 | **Nackter Sensor, nicht das Modul mit LM393.** Der Regler braucht den Analogwert |
| R5, R6 | **150 Ω** | 2 | THT 1/4 W | 0,04 | Vorwiderstand der IR-LED: (3,3 − 1,25) / 150 = 13,7 mA |
| R7, R8 | 10 kΩ | 2 | THT 1/4 W | 0,04 | Emitter-Pulldown des Fototransistors. **Pflicht** — GPIO 34/35 haben keine internen Pull-Widerstände |

> **Arbeitspunkt einstellen:** Steht der Messwert über hellem Untergrund dauernd
> bei ~4095 (gesättigt), R7/R8 auf 4,7 kΩ verkleinern. Bleibt der Hub zwischen
> Linie und Untergrund unter ~150 Zählern, auf 22 kΩ vergrößern. Der Istwert ist
> in der Web-App als Balken live sichtbar.

---

## 5 · Signal-LEDs

| Pos | Bauteil | Menge | Bauform | € | Bemerkung |
|---|---|---|---|---|---|
| LED1, LED2 | LED gelb, 3 mm | 2 | THT | 0,20 | Vorne links/rechts, zeigen die Lenkbewegung. **3 mm statt 5 mm spart 0,8 g** |
| LED3, LED4 | LED rot, 3 mm | 2 | THT | 0,20 | Rücklichter, im Fahrbetrieb dauerhaft an |
| R9–R12 | 220 Ω | 4 | THT 1/4 W | 0,08 | ≈ 5 mA pro LED |

> **Kein MOSFET nötig.** ESP32-WROOM-32-Datenblatt v3.8, Tabelle 14: I_OH
> typisch **40 mA** je Pin in der Domäne VDD3P3_RTC, bei mehreren gleichzeitig
> treibenden Pins laut Fußnote 2 noch rund **29 mA**. Alle vier LED-Pins —
> GPIO 14, 25, 26, 27 — liegen in dieser Domäne. Die 40 mA gelten allerdings
> nur bei maximaler Treiberstärke; die Voreinstellung von Arduino und ESP-IDF
> ist Stufe 2 mit etwa 20 mA. Auch das reicht hier um ein Mehrfaches.

---

## 5a · Entkopplung der Spannungsversorgung

| Pos | Bauteil | Menge | Bauform | € | Bemerkung |
|---|---|---|---|---|---|
| C6 | 10 µF / 25 V Keramik | 1 | 0805 | 0,12 | Am ESP32, **VIN gegen GND**. Die Motoren hängen auf derselben 5-V-Schiene und ziehen Stromimpulse |
| C7 | 100 nF Keramik | 1 | 0805 | 0,02 | dito, HF-Anteil |
| C8 | 100 nF Keramik | 1 | 0805 | 0,02 | Am ESP32, **3V3 gegen GND**. Bulk bringt der AMS1117 des DevKits selbst mit, hier fehlt nur der schnelle Anteil |
| C9, C10 | 100 nF Keramik | 2 | 0805 | 0,04 | Je einer an OS1 und OS2 |

> **Was Kondensatoren hier nicht können:** Der dominierende Störpfad ist die
> **Masse**, nicht die Versorgung — Motorrückstrom durch die Masse, auf die
> sich der ADC bezieht. Der ADC des ESP32 misst gegen eine interne
> 1,1-V-Bandgap-Referenz, nicht gegen 3,3 V; ein verschobenes Massepotential
> verschiebt den Messwert also direkt. Dagegen hilft nur der **Sternpunkt**
> aus [04 §2](04_PCB-Layout-Empfehlung.md).
>
> Bewusst **weggelassen**: 1 µF an den Sensoren (die TCRT5000 schalten nichts,
> sie ziehen 8 mA Gleichstrom) und 10 µF an 3,3 V (doppelt gemoppelt).

---

## 6 · Platine und Mechanik

| Pos | Bauteil | Menge | € | Bemerkung |
|---|---|---|---|---|
| PCB1 | Leiterplatte 2-lagig, **70 × 52 mm**, **1,0 mm FR4** | 1 | 1,40 | JLCPCB 5er-Charge ≈ 7 € gesamt. 1,0 mm statt 1,6 mm spart 2,2 g bei gleichem Preis |
| — | Zahnbürstenkopf, **50 × 15 × 18 mm** (gemessen) | 2 | 3,00 | **Zwei getrennte Felder.** Sitzen im Gehäuseentwurf **seitlich neben** der Platine, weil 18 mm nicht darunter passen — siehe [11](11_Gehaeuse-und-Fahrwerk.md). Begründung für zwei Felder in [02 §4](02_SMD-vs-THT-Wirtschaftlichkeit.md) |
| — | **Druckteile Gehäuse**: Bodenschale, 2 Bürstenträger, Mastkopf (PETG), 4 Tüllen (TPU) | 1 Satz | — | Daten und Druckeinstellungen in [Gehaeuse_CAD](../Gehaeuse_CAD/README.md). Massiv gerechnet bis 46 g |
| — | Doppelseitiges Schaumklebeband | 1 | 0,50 | Bürstenköpfe unter die Bürstenträger kleben, Akku in der Tasche gegen Klappern sichern |

---

## 7 · Optionale Erweiterungen

| Pos | Bauteil | Menge | € | Aktivierung |
|---|---|---|---|---|
| R16, R17 | 100 kΩ, 1 % | 2 | 0,02 | Spannungsteiler VBAT → GPIO 39. `FEATURE_BATTERY_MONITOR 1` in `Config.h` |
| — | Zusätzlich 100 nF an GPIO 39 nach GND | 1 | 0,02 | Glättet den Teiler gegen Motorstörungen |
| SW2 | Taster, THT | 1 | 0,15 | Betriebsart-Umschalter an GPIO 4. `FEATURE_MODE_BUTTON 1` |

---

## Kostenübersicht

| | Einzelstück |
|---|---|
| Rechenkern | 6,30 € |
| Versorgung mit **Fertigmodul** (2b) + Schiene | 11,10 € |
| Motortreiber (inkl. C11/C12) | 3,16 € |
| Sensorik | 0,98 € |
| LEDs | 0,48 € |
| Entkopplung (5a) | 0,20 € |
| PCB + Mechanik | 4,90 € |
| **Summe** | **≈ 27,10 €** |
| davon Akku | 7,50 € |

Mit der I²C-Sensorik aus §8 kommen 7,10 € dazu: **≈ 34,20 €**.

Mit der diskreten Ladeschaltung (2a) statt des Fertigmoduls wird es etwa 0,40 €
teurer, dafür flacher und 1 g leichter — aber es kommen vier SMD-Bauteile
und eine USB-C-Buchse dazu, die gelötet werden müssen.

Bei 10 Stück liegt der Materialpreis bei etwa **21 € pro Einheit**, bei 100 Stück
bei etwa **17 €** — in beiden Fällen dominiert der Akku den Preis.

---

## Einkaufsfallen, kurz zusammengefasst

1. **TCRT5000 nackt kaufen**, nicht als Modul mit Komparator.
2. **ESP32 DevKitC V4 mit 38 Pins.** Die 30-Pin-Version hat ein anderes
   Rastermaß und eine andere Pinreihenfolge — der Schaltplan passt dann nicht.
   Vor der Platinenbestellung den Reihenabstand mit dem Messschieber
   nachmessen: Soll ist **25,4 mm**.
3. **MT3608 umbauen**, bevor er eingebaut wird: Poti auslöten, 110 kΩ / 15 kΩ
   als Festteiler einsetzen, dann im Leerlauf 5,0 V nachmessen. Ein Poti auf
   einem Vibrationsfahrzeug verstellt sich, und zwar irgendwann nach oben.
4. **R_prog am TP4056 tauschen** — Werkszustand 1 A ist für diese Zelle zu viel.
5. **USB-C braucht 2× 5,1 kΩ** an CC1 und CC2 nach GND.
6. **JST-PH-Polung prüfen.** LiPo-Konfektionierungen sind nicht genormt; falsch
   gesteckt zerstört es den Lader sofort.

---

## 8 · Sensorik am I²C-Bus (Nachtrag)

Beide Sensoren hängen am selben Bus (GPIO 21/22), die Adressen kollidieren
nicht: MPU-6050 auf `0x68`, VL53L0X auf `0x29`.

| Pos | Bauteil | Menge | € | Bemerkung |
|---|---|---|---|---|
| U6 | **GY-521** (MPU-6050) Breakout | 1 | 2,50 | Lagesensor. Pull-ups sind auf dem Modul. **Flach aufs Chassis**, nahe der Drehachse, möglichst weit weg von den Motoren |
| U7 | **VL53L0X-Modul**, 25 × 10,67 mm, Lochabstand 19,3 mm | 1 | 3,50 | Gekauft: roboter-bausatz.de RBS17700. Abstandssensor, Laufzeitmessung. Kommt in den Mastkopf |
| — | Mast: **Holz-Schaschlikspieß Ø 3 mm**, auf **70 mm** abgelängt | 1 | 0,05 | 60 mm über der Platine plus 10 mm im Mastfuß. Aus der Küche, eine Packung kostet gut einen Euro. Weicher als der früher vorgesehene CFK-Stab — für den Abstandssensor unkritisch (siehe [04](04_PCB-Layout-Empfehlung.md)), dafür leichter und nicht leitend |
| — | Litze **AWG 28–30** (0,05–0,08 mm², Silikon), 4 Stück je ca. 90 mm | 1 | 0,30 | Dünner als ursprünglich geplant, damit sie am schwingenden Mast nicht bricht und in die Kabelöse passt. Zum Sensor hinauf. **Verdrillt** und mit Schlaufe am Fuß, siehe unten |
| — | Schaumklebeband für U6 | 1 | — | aus dem Restbestand der Akkubefestigung |

**Zusammen ≈ 6,35 €**, Materialpreis steigt damit von 26,50 € auf **≈ 32,85 €**.

### Massezuwachs

| Position | Masse |
|---|---|
| GY-521 (Stiftleisten abgeknipst, flach verlötet) | 1,8 g |
| GY-530 auf dem Mast | 1,3 g |
| Mast Holzspieß Ø 3 mm × 60 mm | 0,3 g |
| Litze und Klebstoff | 0,8 g |
| **Summe** | **≈ 4,2 g** |

Damit steigt die Gesamtmasse von ~40 g auf **~44 g** — und davon sitzen gut
1,5 g oben auf dem Mast. Das verschärft das in
[02 §4](02_SMD-vs-THT-Wirtschaftlichkeit.md) beschriebene Hauptrisiko.
Gegenrechnung: die dort genannte Abspeckliste (1,0-mm-PCB, 3-mm-LEDs,
300-mAh-Zelle) holt ~6,5 g zurück.

### Einkaufsfallen

1. **GY-521 mit abgeknipsten Stiftleisten verbauen.** Gesteckt wackelt das
   Modul im Vibrationsbetrieb, und genau dieses Wackeln misst der Sensor dann.
2. **VL53L0X, nicht VL53L1X.** Der L1X hat eine andere Bibliothek und eine
   andere Registerkarte. Module werden oft verwechselt.
3. **Beide Module vertragen 3,3 V.** Die üblichen Breakouts haben einen
   eigenen Regler und laufen auch an 5 V — am 3V3-Pin des DevKits sind sie
   aber sparsamer und störungsärmer.
