Darklirah/One-of-a-Kind-Mars-Rover/pcb/MarsRover.csv

Reference | Qty | Value | DNP | Exclude from BOM | Exclude from Board | Footprint | Datasheet
BT1 | 1 | LiPo 3,7V 500mAh |  |  | Von Platine ausgeschlossen
C1 | 1 | 100u/10V |  |  |  | Capacitor_THT:CP_Radial_D6.3mm_P2.50mm
C2,C6 | 2 | 10u/25V |  |  |  | Capacitor_SMD:C_0805_2012Metric
C3,C4,C5,C7,C8,C9,C10 | 7 | 100n |  |  |  | Capacitor_SMD:C_0805_2012Metric
C11,C12 | 2 | 47u/10V |  |  |  | Capacitor_THT:CP_Radial_D5.0mm_P2.00mm
D1,D2 | 2 | 1N5819 |  |  |  | Diode_THT:D_DO-41_SOD81_P7.62mm_Horizontal
J2 | 1 | JST-PH 2,0 |  |  |  | Connector_JST:JST_PH_S2B-PH-K_1x02_P2.00mm_Horizontal
LED1 | 1 | gelb - vorne links |  |  |  | LED_THT:LED_D3.0mm
LED2 | 1 | gelb - vorne rechts |  |  |  | LED_THT:LED_D3.0mm
LED3 | 1 | rot - hinten links |  |  |  | LED_THT:LED_D3.0mm
LED4 | 1 | rot - hinten rechts |  |  |  | LED_THT:LED_D3.0mm
M1 | 1 | Vibrationsmotor links |  |  |  | Connector_PinHeader_2.54mm:PinHeader_1x02_P2.54mm_Vertical
M2 | 1 | Vibrationsmotor rechts |  |  |  | Connector_PinHeader_2.54mm:PinHeader_1x02_P2.54mm_Vertical
OS1 | 1 | TCRT5000 links |  |  |  | OptoDevice:Vishay_TCRT5000
OS2 | 1 | TCRT5000 rechts |  |  |  | OptoDevice:Vishay_TCRT5000
Q1,Q2 | 2 | AO3400A |  |  |  | Package_TO_SOT_SMD:SOT-23
R1,R2 | 2 | 100R |  |  |  | Resistor_SMD:R_0805_2012Metric_Pad1.20x1.40mm_HandSolder
R3,R4,R16,R17 | 4 | 100k |  |  |  | Resistor_SMD:R_0805_2012Metric_Pad1.20x1.40mm_HandSolder
R5,R6 | 2 | 150R |  |  |  | Resistor_SMD:R_0805_2012Metric_Pad1.20x1.40mm_HandSolder
R7,R8 | 2 | 10k |  |  |  | Resistor_SMD:R_0805_2012Metric_Pad1.20x1.40mm_HandSolder
R9,R10,R11,R12 | 4 | 220R |  |  |  | Resistor_THT:R_Axial_DIN0207_L6.3mm_D2.5mm_P7.62mm_Horizontal
S1 | 1 | Schiebeschalter |  |  |  | Button_Switch_THT:SW_Slide_SPDT_Straight_CK_OS102011MS2Q
U1 | 1 | ESP32-DevKitC V4 |  |  |  | PCM_Espressif:ESP32-DevKitC
U2 | 1 | TP4056-Modul |  |  |  | Connector_PinHeader_2.54mm:PinHeader_1x06_P2.54mm_Vertical
U5 | 1 | MT3608 auf 5,00V |  |  |  | Connector_PinHeader_2.54mm:PinHeader_1x04_P2.54mm_Vertical
U6 | 1 | GY-521 MPU-6050 |  |  |  | Connector_PinHeader_2.54mm:PinHeader_1x04_P2.54mm_Vertical
U7 | 1 | GY-530 VL53L0X |  |  |  | Connector_PinHeader_2.54mm:PinHeader_1x04_P2.54mm_Vertical
