Darklirah/One-of-a-Kind-Mars-Rover/Fertigung/MarsRover-platine.step

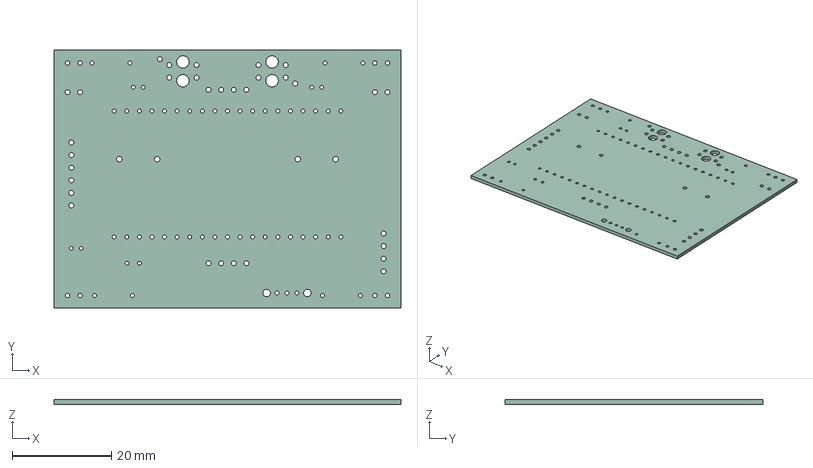
[picture p29: CAD file, 2026-10-21]
Fertigung/MarsRover-platine.step
70.0 x 52.0 x 0.91 mm
