Darklirah/One-of-a-Kind-Mars-Rover/Gehaeuse_CAD/Bauteile/LiPo_503035.step

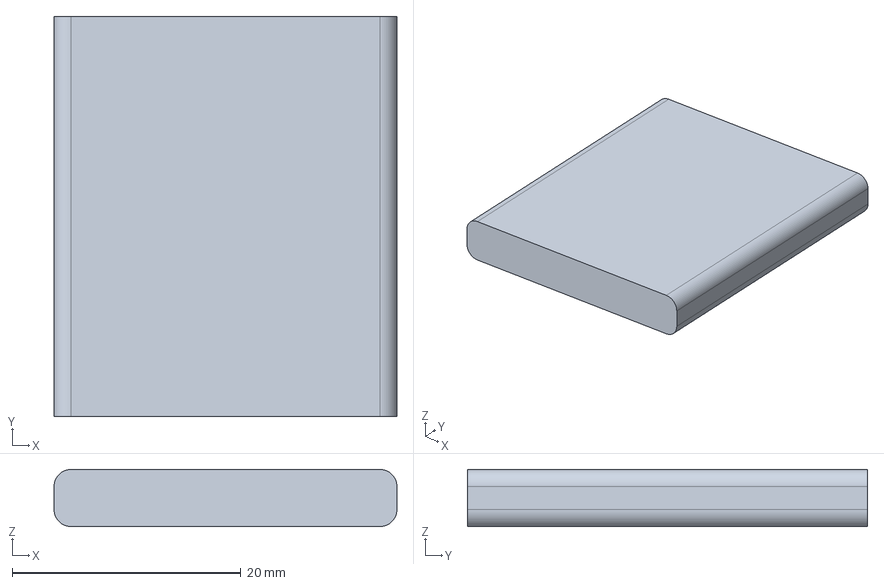
[picture p30: CAD file, 2026-10-25]
Gehaeuse_CAD/Bauteile/LiPo_503035.step
30.0 x 35.0 x 5.00 mm
