Darklirah/One-of-a-Kind-Mars-Rover/Gehaeuse_CAD/Druckteile/Biegelehre_Borsten.step

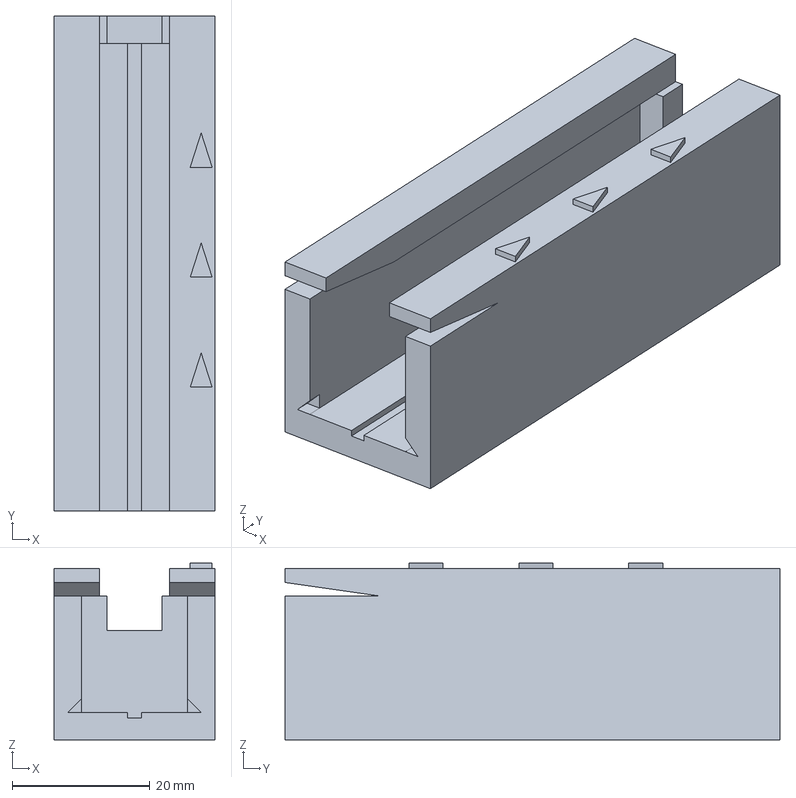
[picture p31: CAD file, 2026-10-31]
Gehaeuse_CAD/Druckteile/Biegelehre_Borsten.step
23.4 x 72.0 x 25.7 mm
