Darklirah/One-of-a-Kind-Mars-Rover/Gehaeuse_CAD/MarsRover_Biegelehre.FCStd

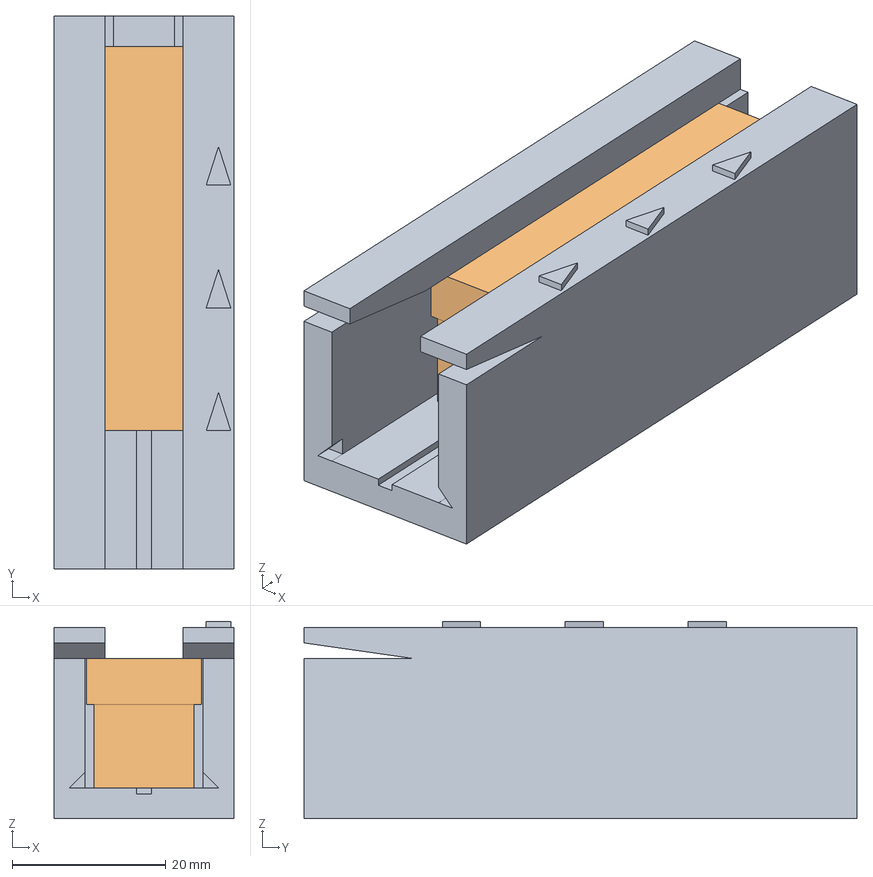
[picture p32: CAD file, 2026-10-31]
Gehaeuse_CAD/MarsRover_Biegelehre.FCStd
23.4 x 72.0 x 25.7 mm
Biegelehre
Buerstenkopf_Ref
