Darklirah/One-of-a-Kind-Mars-Rover/Gehaeuse_CAD/V1/Druckteile/Buerstentraeger_R.step

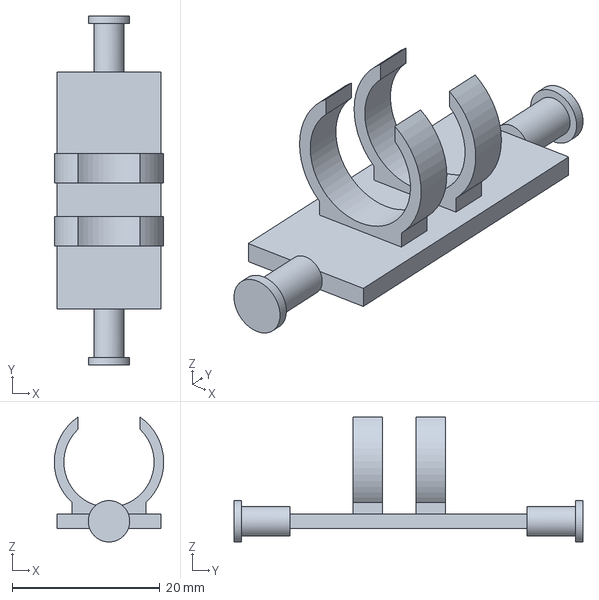
[picture p33: CAD file, 2026-10-11]
Gehaeuse_CAD/V1/Druckteile/Buerstentraeger_R.step
14.8 x 47.2 x 16.9 mm
