Darklirah/One-of-a-Kind-Mars-Rover/Gehaeuse_CAD/Bauteile/MPU-6050_GY-521.step

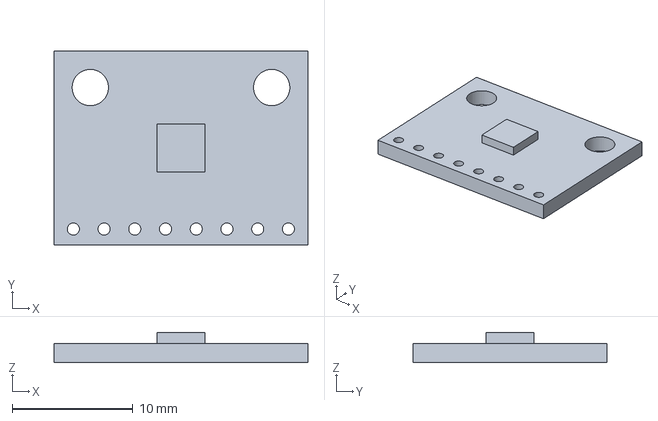
[picture p34: CAD file, 2026-10-25]
Gehaeuse_CAD/Bauteile/MPU-6050_GY-521.step
21.0 x 16.0 x 2.50 mm
