Darklirah/One-of-a-Kind-Mars-Rover/Gehaeuse_CAD/Druckteile/Bodenschale.step

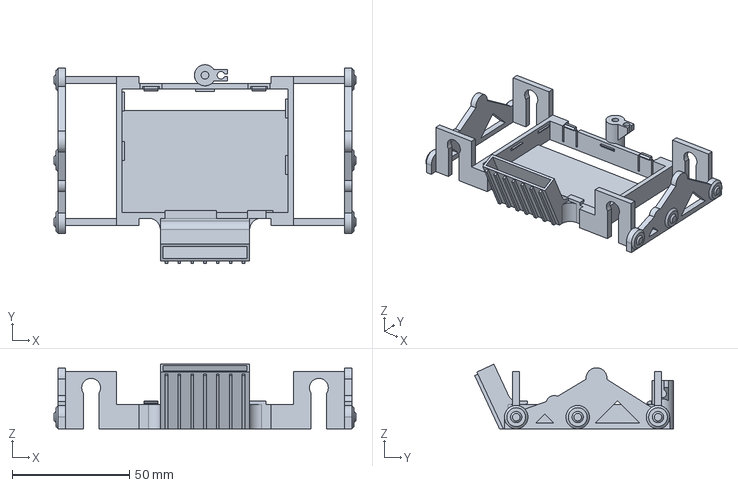
[picture p35: CAD file, 2026-10-25]
Gehaeuse_CAD/Druckteile/Bodenschale.step
128.6 x 84.6 x 27.6 mm
