Darklirah/One-of-a-Kind-Mars-Rover/Gehaeuse_CAD/MarsRover_Gehaeuse_V2_ohne_Bauteile.FCStd

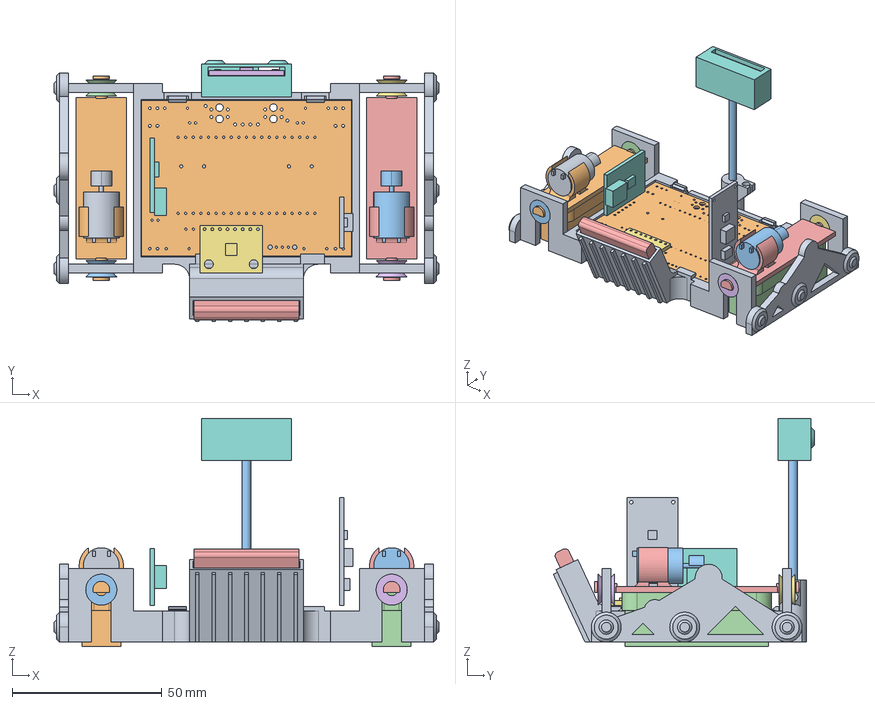
[picture p36: CAD file, 2026-10-25]
Gehaeuse_CAD/MarsRover_Gehaeuse_V2_ohne_Bauteile.FCStd
128.6 x 87.3 x 76.2 mm
Bodenschale
Buerstentraeger_L
Tuelle_TPU_L1
Tuelle_TPU_L2
Buerstentraeger_R
Tuelle_TPU_R1
Tuelle_TPU_R2
Mastkopf
Motor_L
Buerstenkopf_L
Motor_R
Buerstenkopf_R
Akku_503035
VL53L0X
MPU6050
TP4056
MT3608
Leiterplatte_nackt
Mast_Holz
