Darklirah/One-of-a-Kind-Mars-Rover/Gehaeuse_CAD/V1/Druckteile/Bodenschale.step

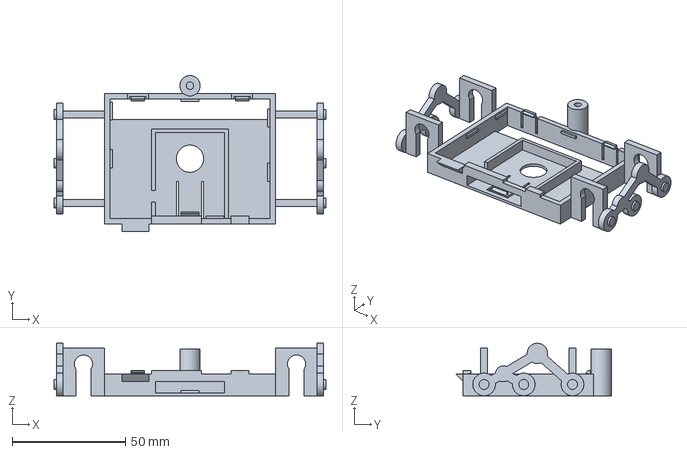
[picture p37: CAD file, 2026-10-11]
Gehaeuse_CAD/V1/Druckteile/Bodenschale.step
120.0 x 68.8 x 23.2 mm
