Darklirah/One-of-a-Kind-Mars-Rover/Gehaeuse_CAD/Bauteile/Zahnbuerstenkopf.step

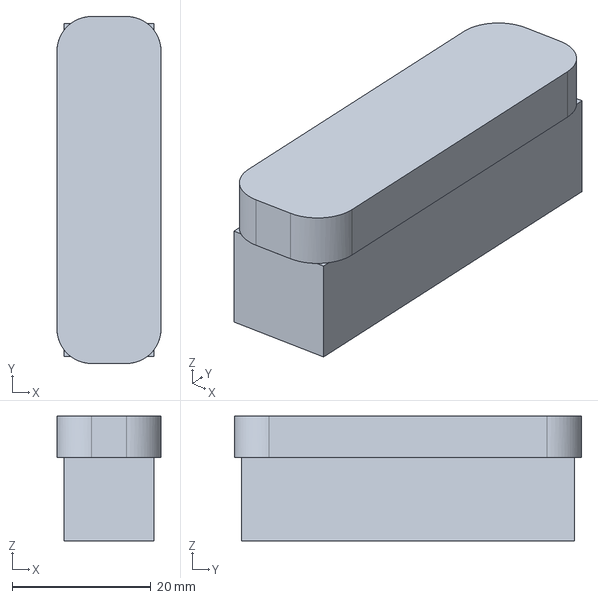
[picture p38: CAD file, 2026-10-25]
Gehaeuse_CAD/Bauteile/Zahnbuerstenkopf.step
15.0 x 50.0 x 18.0 mm
