Darklirah/One-of-a-Kind-Mars-Rover/Gehaeuse_CAD/Druckteile/Buerstentraeger_L.step

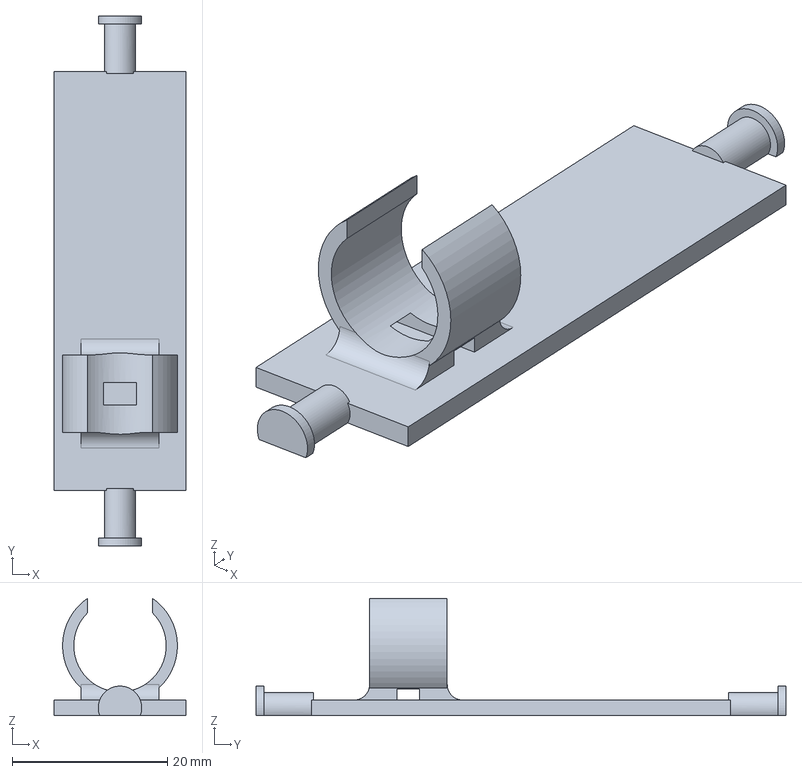
[picture p39: CAD file, 2026-10-25]
Gehaeuse_CAD/Druckteile/Buerstentraeger_L.step
17.0 x 68.2 x 15.1 mm
