Darklirah/One-of-a-Kind-Mars-Rover/Gehaeuse_CAD/V1/Druckteile/RTG_Deko.step

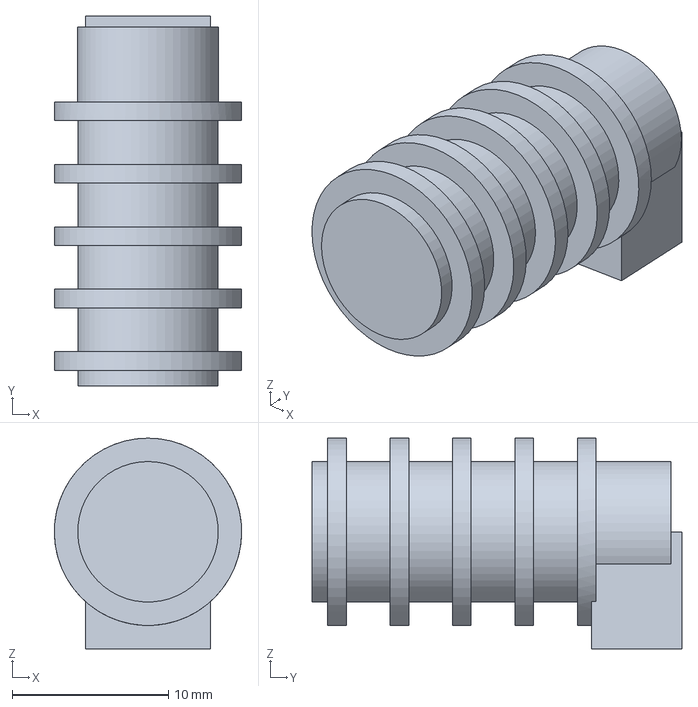
[picture p40: CAD file, 2026-10-11]
Gehaeuse_CAD/V1/Druckteile/RTG_Deko.step
12.0 x 23.7 x 13.5 mm
