Darklirah/One-of-a-Kind-Mars-Rover/Gehaeuse_CAD/Bauteile/VL53L0X_Modul.step

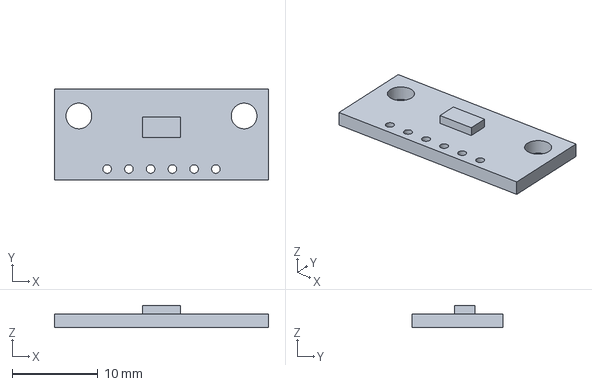
[picture p41: CAD file, 2026-10-25]
Gehaeuse_CAD/Bauteile/VL53L0X_Modul.step
25.0 x 10.7 x 2.60 mm
