Darklirah/One-of-a-Kind-Mars-Rover/Gehaeuse_CAD/V1/Druckteile/Mastkopf.step

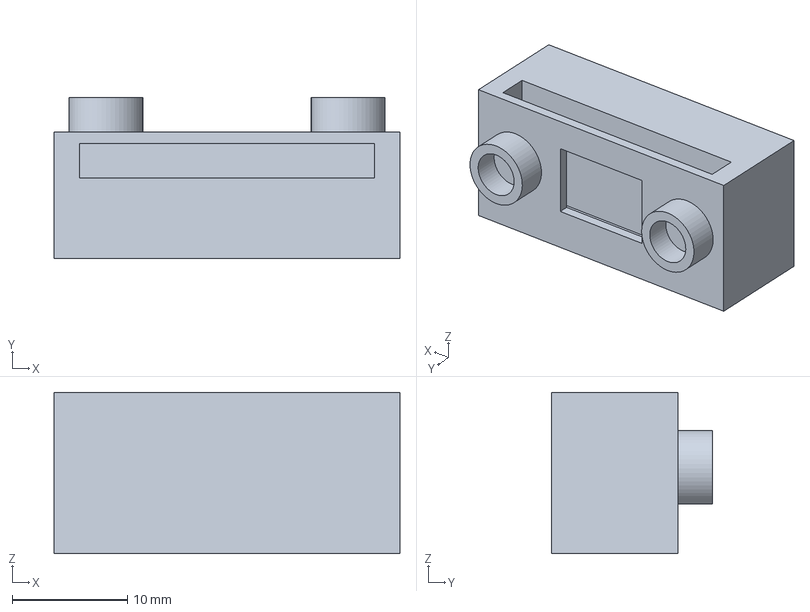
[picture p42: CAD file, 2026-10-11]
Gehaeuse_CAD/V1/Druckteile/Mastkopf.step
30.0 x 14.0 x 14.0 mm
