Darklirah/One-of-a-Kind-Mars-Rover/Gehaeuse_CAD/Bauteile/TP4056_MiniUSB.step

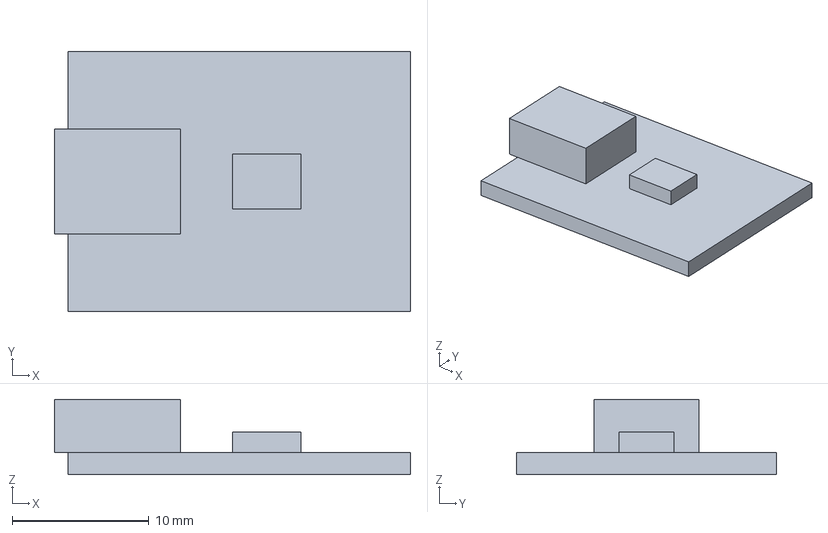
[picture p43: CAD file, 2026-10-25]
Gehaeuse_CAD/Bauteile/TP4056_MiniUSB.step
26.0 x 19.0 x 5.50 mm
