Darklirah/One-of-a-Kind-Mars-Rover/Gehaeuse_CAD/Druckteile/Mastkopf.step

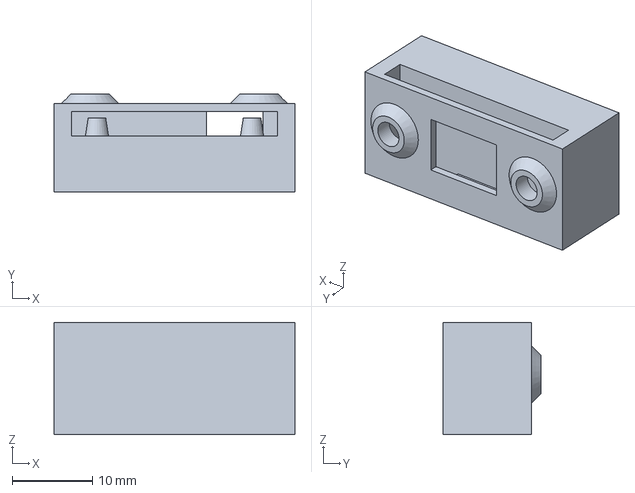
[picture p44: CAD file, 2026-10-25]
Gehaeuse_CAD/Druckteile/Mastkopf.step
30.0 x 12.2 x 14.0 mm
