Darklirah/One-of-a-Kind-Mars-Rover/Gehaeuse_CAD/Bauteile/MT3608_StepUp.step

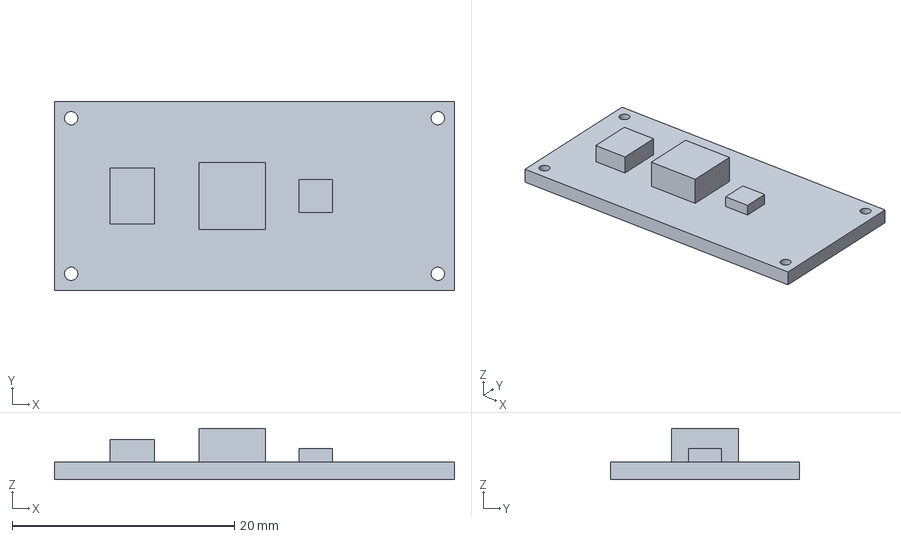
[picture p45: CAD file, 2026-10-25]
Gehaeuse_CAD/Bauteile/MT3608_StepUp.step
36.0 x 17.0 x 4.60 mm
