Darklirah/One-of-a-Kind-Mars-Rover/Gehaeuse_CAD/Druckteile/Platte1_PETG.3mf

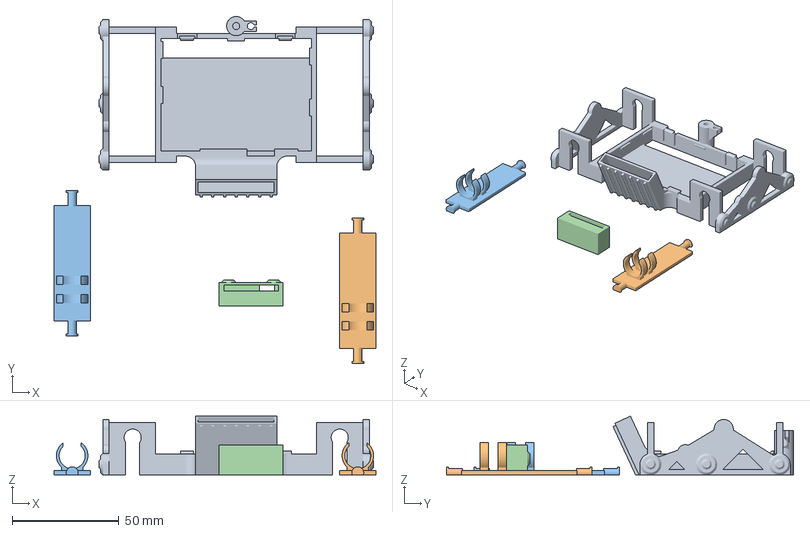
[picture p46: CAD file, 2026-10-21]
Gehaeuse_CAD/Druckteile/Platte1_PETG.3mf
150.8 x 162.6 x 27.6 mm
Bodenschale.stl
Buerstentraeger_L.stl
Buerstentraeger_R.stl
Mastkopf.stl
