Darklirah/One-of-a-Kind-Mars-Rover/Gehaeuse_CAD/V1/Druckteile/Tuelle_TPU_L1.step

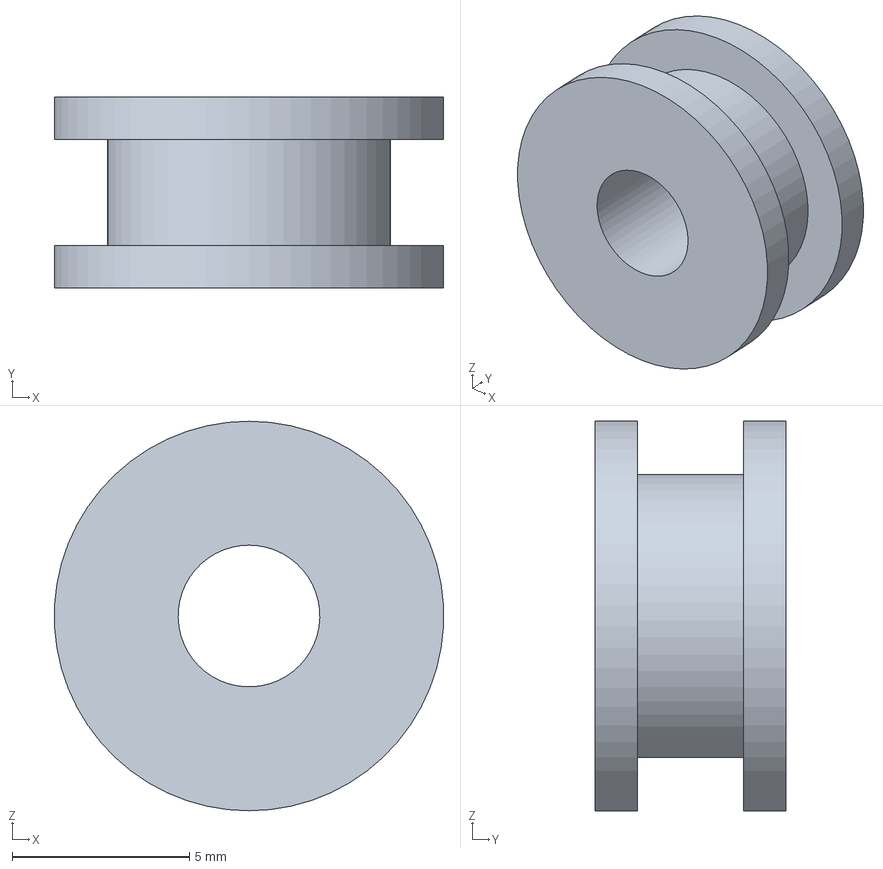
[picture p47: CAD file, 2026-10-11]
Gehaeuse_CAD/V1/Druckteile/Tuelle_TPU_L1.step
11.0 x 5.40 x 11.0 mm
