Darklirah/One-of-a-Kind-Mars-Rover/Gehaeuse_CAD/Bauteile/Holzspiess_3x70.step

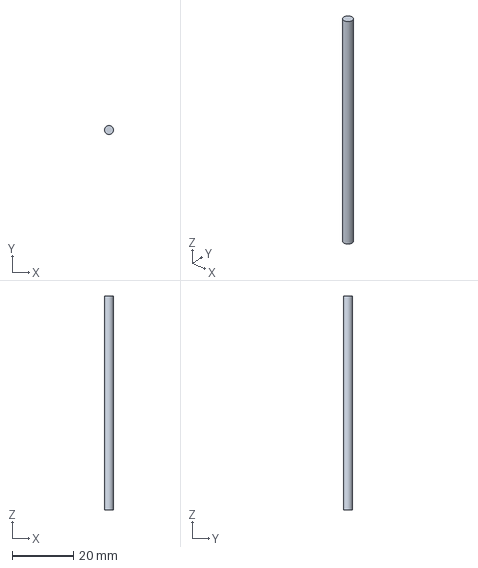
[picture p48: CAD file, 2026-10-25]
Gehaeuse_CAD/Bauteile/Holzspiess_3x70.step
3.00 x 3.00 x 70.0 mm
