Darklirah/One-of-a-Kind-Mars-Rover/Gehaeuse_CAD/Druckteile/Platte1_TPU.3mf

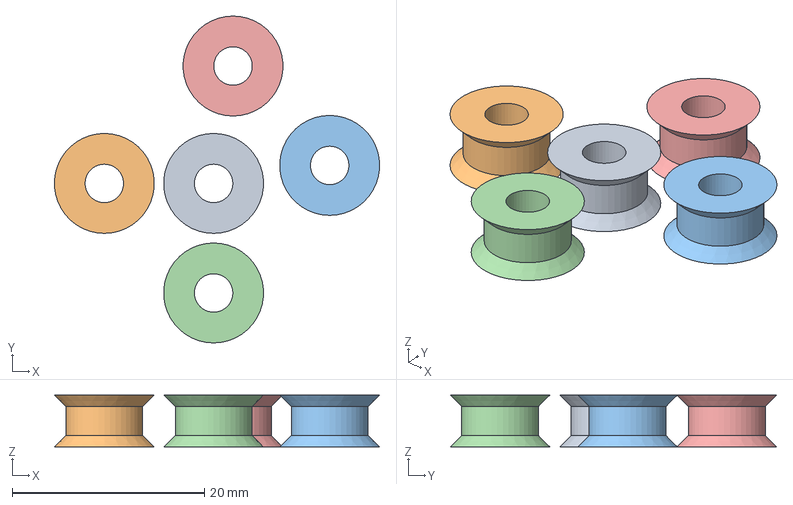
[picture p49: CAD file, 2026-10-21]
Gehaeuse_CAD/Druckteile/Platte1_TPU.3mf
33.8 x 34.0 x 5.40 mm
Tuelle_TPU_L1.stl x 5
