Darklirah/One-of-a-Kind-Mars-Rover/Gehaeuse_CAD/Bauteile/Vibrationsmotor_12x22.5.step

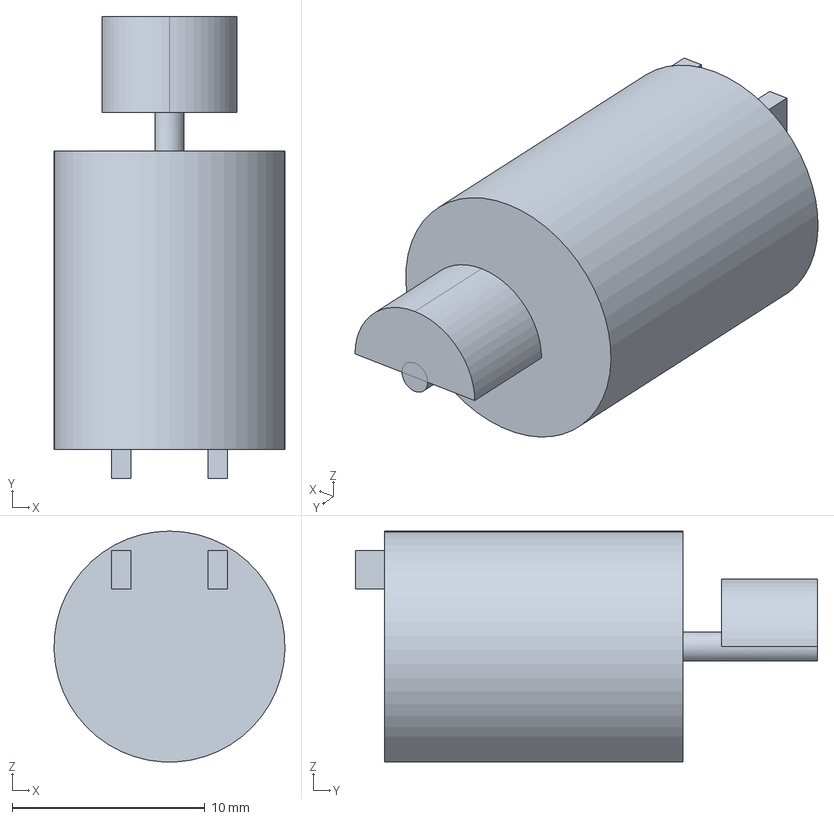
[picture p50: CAD file, 2026-10-25]
Gehaeuse_CAD/Bauteile/Vibrationsmotor_12x22.5.step
12.0 x 24.0 x 12.0 mm
