Darklirah/One-of-a-Kind-Mars-Rover/Gehaeuse_CAD/Druckteile/Tuelle_TPU_L1.step

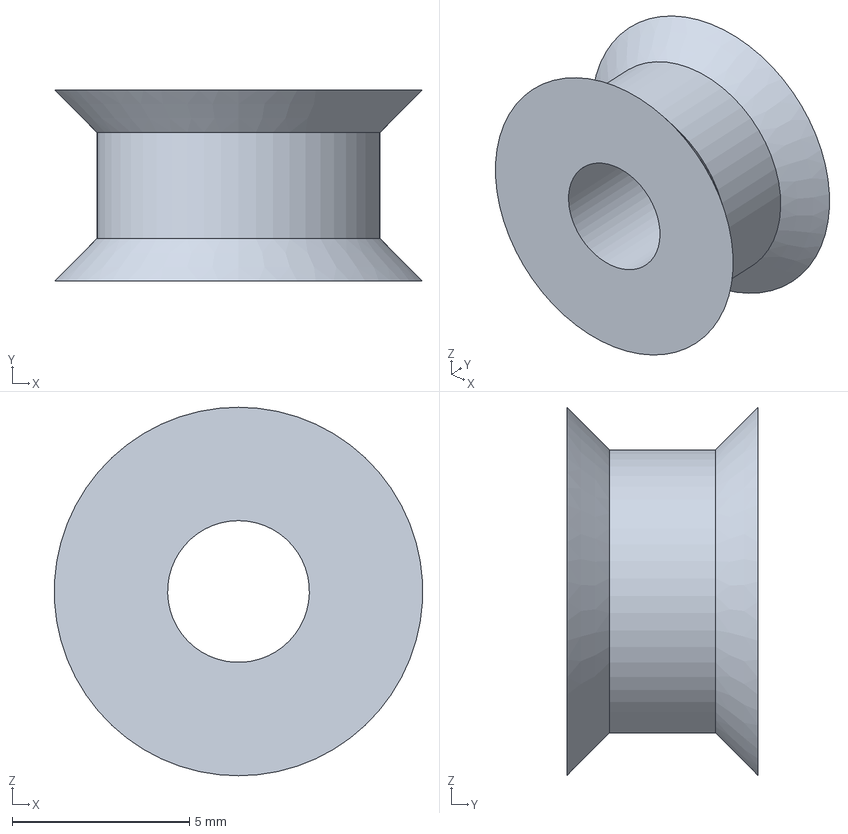
[picture p51: CAD file, 2026-10-11]
Gehaeuse_CAD/Druckteile/Tuelle_TPU_L1.step
10.4 x 5.40 x 10.4 mm
