Darklirah/One-of-a-Kind-Mars-Rover/(list of files, cad)

Other CAD files:
Gehaeuse_CAD/Druckteile/Buerstentraeger_R.step
Gehaeuse_CAD/V1/Druckteile/Buerstentraeger_L.step
Gehaeuse_CAD/Bauteile/CFK_Stab_3x70.step
Gehaeuse_CAD/Druckteile/Biegelehre_Borsten.stl
Gehaeuse_CAD/Druckteile/Bodenschale.stl
Gehaeuse_CAD/Druckteile/Buerstentraeger_L.stl
Gehaeuse_CAD/Druckteile/Buerstentraeger_R.stl
Gehaeuse_CAD/Druckteile/Mastkopf.stl
Gehaeuse_CAD/Druckteile/Tuelle_TPU_L1.stl
Gehaeuse_CAD/V1/Druckteile/Bodenschale.stl
Gehaeuse_CAD/V1/Druckteile/Buerstentraeger_L.stl
Gehaeuse_CAD/V1/Druckteile/Buerstentraeger_R.stl
Gehaeuse_CAD/V1/Druckteile/Mastkopf.stl
Gehaeuse_CAD/V1/Druckteile/RTG_Deko.stl
Gehaeuse_CAD/V1/Druckteile/Tuelle_TPU_L1.stl
