Darklirah/One-of-a-Kind-Mars-Rover/Doku/Bestückungsplan.pdf

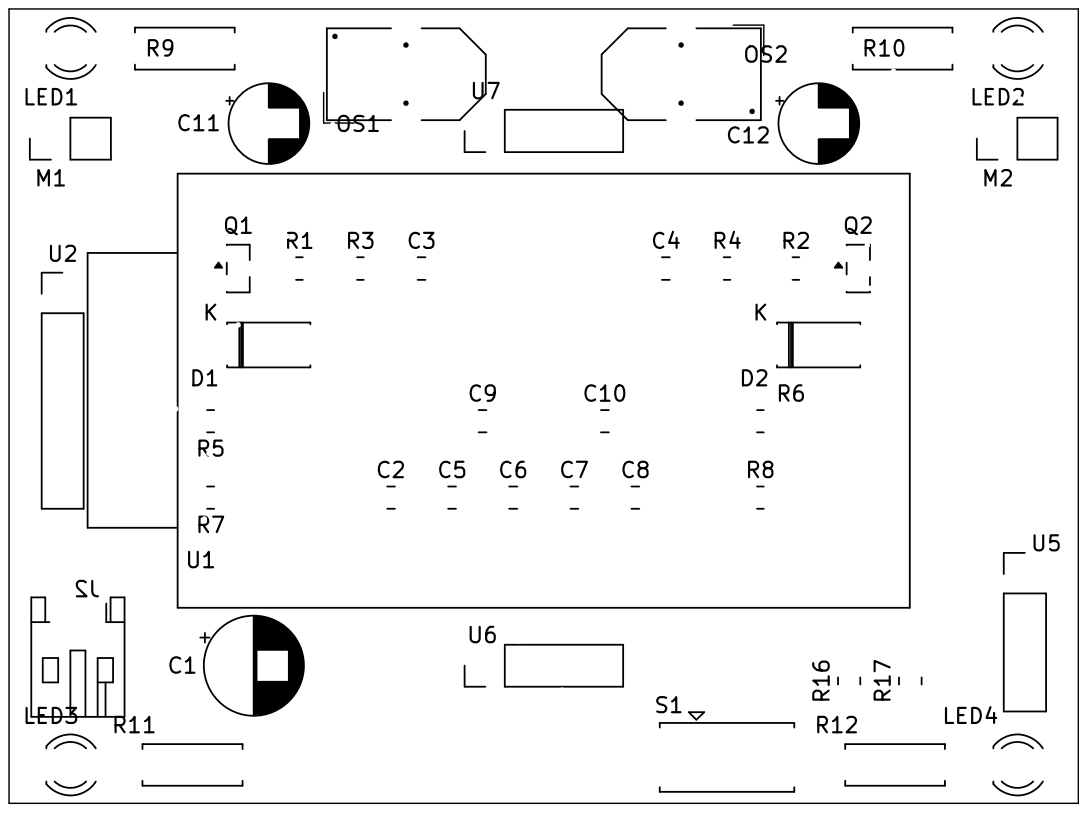
[picture p52: page 1]
