Darklirah/One-of-a-Kind-Mars-Rover/Doku/Bestückungsplan_bot.pdf

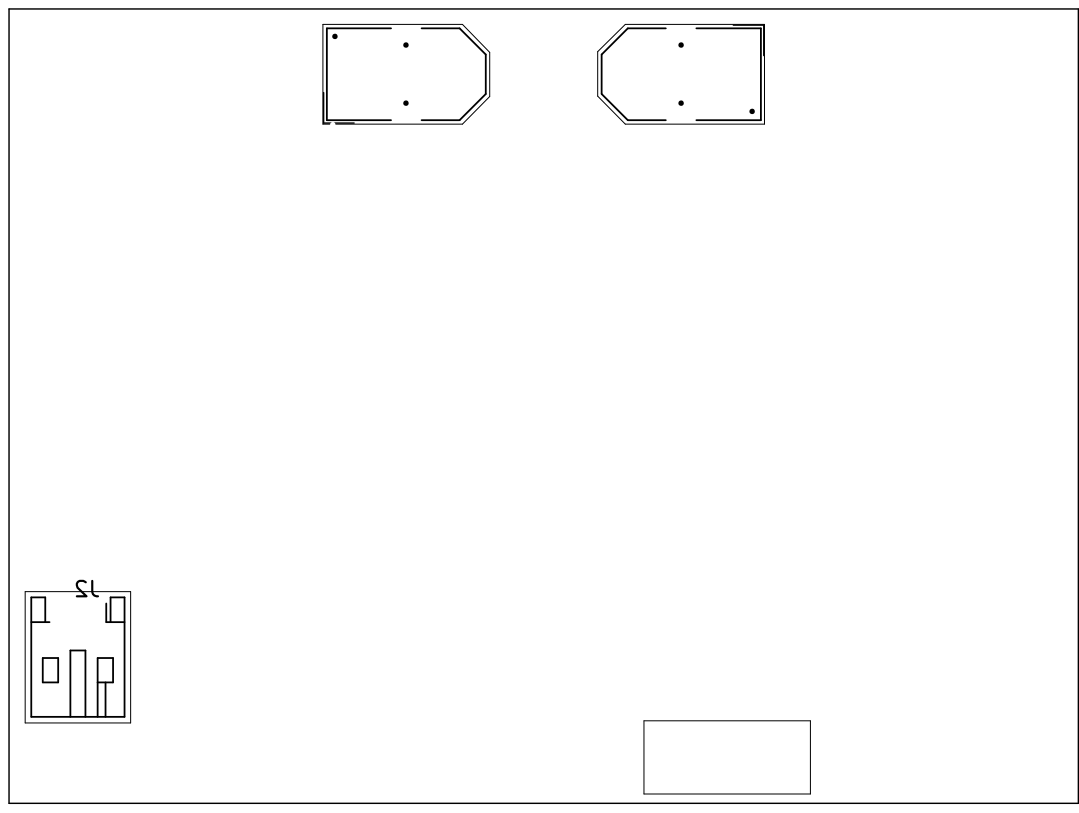
[picture p53: page 1]
