Darklirah/One-of-a-Kind-Mars-Rover/Doku/Bestückungsplan_gross.pdf

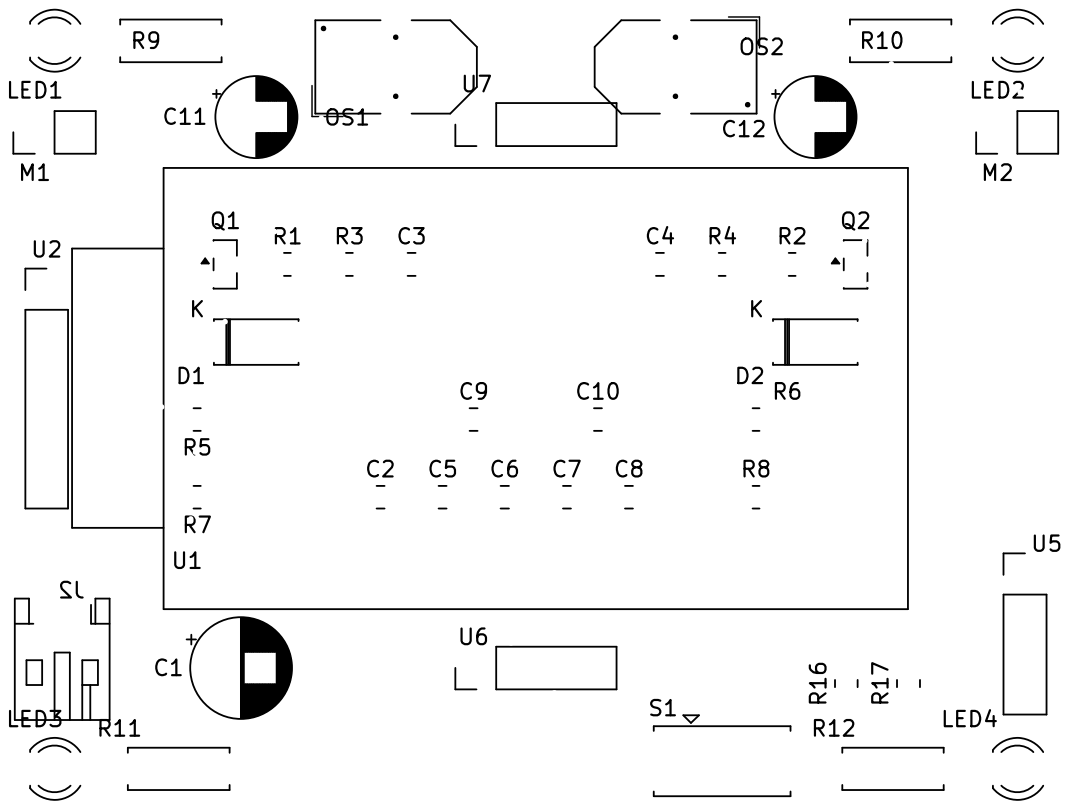
[picture p54: page 1]
