Darklirah/One-of-a-Kind-Mars-Rover/Doku/Bestückungsplan_top.pdf

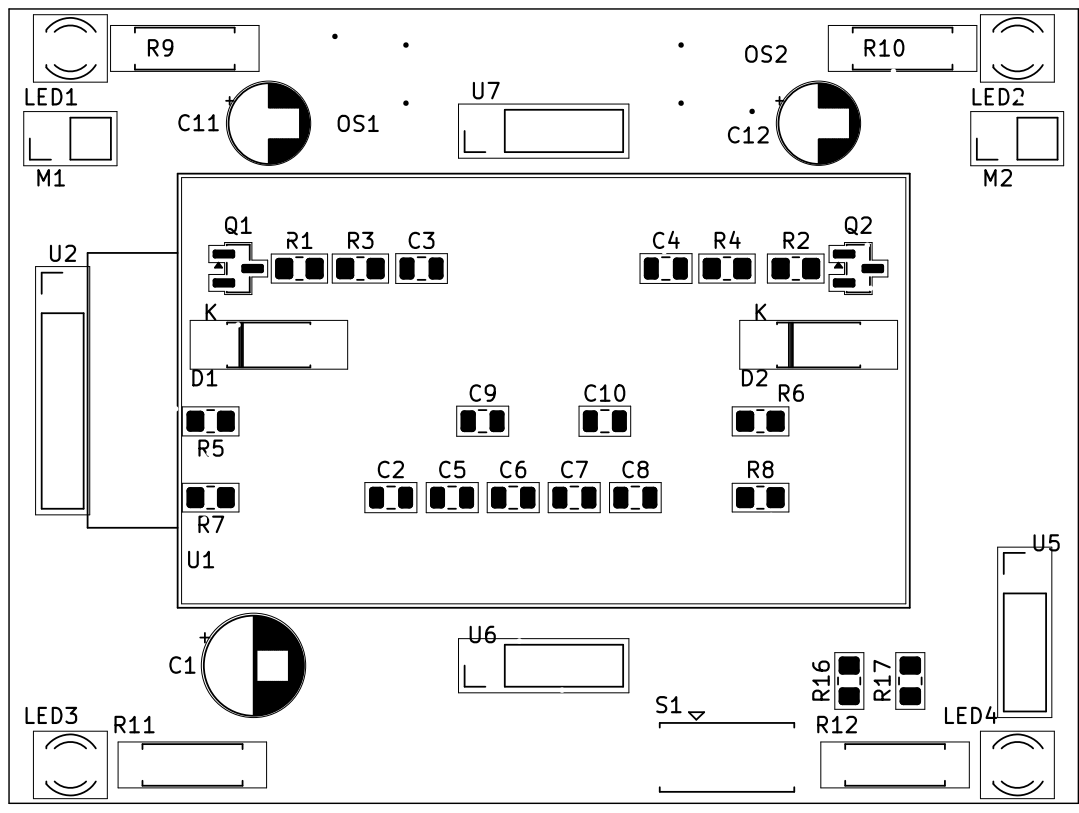
[picture p55: page 1]
