Darklirah/One-of-a-Kind-Mars-Rover/Firmware/MarsRover/MarsRover.ino

// =====================================================================
//  O N E - O F - A - K I N D   M A R S   R O V E R
//  Linienfolgender Zahnbuersten-Roboter auf ESP32.
//  Fortbewegung wie bei einem Bristlebot -- Vibration auf schraegen
//  Borsten -- aber mit zwei Antrieben, Liniensensorik und WLAN.
//
//  Drei Betriebsarten, umschaltbar in der Web-App:
//    manuell   Joystick
//    autonom   Linienfolger mit PD-Regler
//    Programm  gespeicherter Ablauf aus einem von vier Flash-Plaetzen
//
//  Diese Datei macht nur die Orchestrierung: Zustandsmaschine, Regler,
//  Telemetrie. Alles Hardwarenahe steckt in den Modulen:
//
//    Config.h        Pins, Kennwerte, Feature-Flags  -- hier tunen
//    RobotState.h    Betriebsart, Phase, LED-Zustaende, Tuningstruktur
//    Motors.*        PWM, Kennlinienspreizung, Kickstart
//    LineSensor.*    2x TCRT5000, Median-Filter, Kalibrierung in NVS
//    Leds.*          Blinkmuster, im Programmbetrieb direkt steuerbar
//    Program.*       Fahrprogramme: Parser, vier Flash-Slots, Interpreter
//    SelfTest.*      eingebauter Funktionstest fuer die Inbetriebnahme
//    Imu.*           MPU-6050: Kurswinkel und Kippschutz (optional)
//    Distance.*      VL53L0X am Mast: Abstand nach vorn (optional)
//    RemoteControl.* Access Point, Webserver, WebSocket, Protokoll
//    WebUI.h         die Bedienoberflaeche (iPhone + Android, Browser)
//
//  Benoetigte Bibliothek (Library Manager):
//    WebSockets  von Markus Sattler ("arduinoWebSockets") >= 2.4.1
//  Alles andere ist Teil des ESP32-Arduino-Cores.
//
//  Board: "ESP32 Dev Module", Flash 4 MB, Partition "Default 4MB with spiffs"
// =====================================================================
#include "Config.h"
#include "RobotState.h"
#include "Motors.h"
#include "LineSensor.h"
#include "Leds.h"
#include "Program.h"
#include "SelfTest.h"
#include "Imu.h"
#include "Distance.h"
#include "RemoteControl.h"

// ---------------------------------------------------------------------
//  Module
// ---------------------------------------------------------------------
static Motors        motors;
static LineSensor    line;
static Leds          leds;
static Program       prog;
static SelfTest      selftest;
#if FEATURE_IMU
static Imu           imu;
#else
// Platzhalter mit derselben Schnittstelle, damit der uebrige Code
// unveraendert bleibt, wenn der Lagesensor abgewaehlt ist.
struct ImuStub {
  bool begin() { return false; }
  void update() {}
  bool present() const { return false; }
  float heading() const { return 0.0f; }
  float rate() const { return 0.0f; }
  void zeroHeading() {}
  void startCalibration() {}
  bool calibrating() const { return false; }
  bool calibrated() const { return false; }
  bool tipped() const { return false; }
  bool lifted() const { return false; }
};
static ImuStub       imu;
#endif

#if FEATURE_DISTANCE
static Distance      dist;
#else
struct DistStub {
  bool begin() { return false; }
  void update() {}
  bool present() const { return false; }
  bool valid() const { return false; }
  uint16_t mm() const { return 0; }
  bool closerThan(uint16_t) const { return false; }
};
static DistStub      dist;
#endif
static RemoteControl rc;

// ---------------------------------------------------------------------
//  Laufzeitzustand
// ---------------------------------------------------------------------
static Mode   g_mode   = Mode::Manual;
static Phase  g_phase  = Phase::Disarmed;
static bool     g_wasMoving    = false;   // lief im letzten Durchlauf ein Motor?
static uint32_t g_stillSinceMs = 0;       // seit wann steht er still
static bool   g_armed  = false;         // nach dem Einschalten immer gesperrt
static Tuning g_tune;

static float    g_lastError   = 0.0f;
static float    g_lastSteer   = 0.0f;
static int8_t   g_lastErrSign = 0;      // Richtung, in der die Linie zuletzt lag
static uint32_t g_lastCtrlMs  = 0;
static uint32_t g_lostSinceMs = 0;

static uint32_t g_tuneDirtyMs = 0;      // NVS-Schreiben entprellen
static uint32_t g_nextTeleMs  = 0;
static uint32_t g_loopCount   = 0;
static uint16_t g_loopHz      = 0;
static uint32_t g_hzWindowMs  = 0;

#if FEATURE_BATTERY_MONITOR
static float    g_vbat = 0.0f;
#endif
#if FEATURE_MODE_BUTTON
static uint32_t g_btnDebounceMs = 0;
static bool     g_btnLast = true;
#endif

// =====================================================================
//  Tuningwerte in NVS
// =====================================================================
static void loadTuning() {
  Preferences p;
  p.begin(NVS_NAMESPACE, true);
  g_tune.kp       = p.getFloat("kp",   CTRL_KP_DEFAULT);
  g_tune.kd       = p.getFloat("kd",   CTRL_KD_DEFAULT);
  g_tune.base     = p.getFloat("base", CTRL_BASE_DEFAULT);
  g_tune.minLevel = p.getFloat("minl", MOTOR_MIN_LEVEL_DEFAULT);
  p.end();
  motors.setMinLevel(g_tune.minLevel);
}

static void saveTuning() {
  Preferences p;
  p.begin(NVS_NAMESPACE, false);
  p.putFloat("kp",   g_tune.kp);
  p.putFloat("kd",   g_tune.kd);
  p.putFloat("base", g_tune.base);
  p.putFloat("minl", g_tune.minLevel);
  p.end();
}

// =====================================================================
//  Fahrbefehle
// =====================================================================
static inline float clamp01(float v) { return v < 0.0f ? 0.0f : (v > 1.0f ? 1.0f : v); }

// steer > 0 = nach rechts lenken. Rechtskurve heisst: linker Motor
// vibriert kraeftiger -- genau wie beim Differentialantrieb.
static void drive(float base, float steer) {
  g_lastSteer = constrain(steer, -1.0f, 1.0f);
  motors.set(clamp01(base + g_lastSteer), clamp01(base - g_lastSteer));
  leds.setSteer(g_lastSteer);
}

static void halt() {
  motors.stop();
  g_lastSteer = 0.0f;
  leds.setSteer(0.0f);
}

// ---------------------------------------------------------------------
//  Handbetrieb: Joystick mischen
// ---------------------------------------------------------------------
static void runManual() {
  const RemoteInput& in = rc.input();

  // Totmannschalter: ohne frisches Paket wird gestoppt. Verhindert, dass
  // der Roboter weiterlaeuft, wenn das Handy weggeht oder der Browser
  // in den Hintergrund wechselt.
  if (!in.connected || (millis() - in.lastPacketMs) > RC_TIMEOUT_MS) {
    halt();
    g_phase = Phase::Idle;
    return;
  }

  const float speed = in.y > 0.0f ? in.y : 0.0f;   // rueckwaerts gibt es nicht
  const float x     = in.x;

  if (speed < 0.05f) {
    if (fabsf(x) > 0.5f) {
      // Drehen auf der Stelle: nur die aeussere Seite vibriert
      if (x > 0) motors.set(PIVOT_LEVEL, 0.0f);
      else       motors.set(0.0f, PIVOT_LEVEL);
      g_lastSteer = x;
      leds.setSteer(x);
      g_phase = Phase::Running;
    } else {
      halt();
      g_phase = Phase::Idle;
    }
    return;
  }
  g_phase = Phase::Running;

  const float l = speed * (1.0f + x * MANUAL_STEER_AUTHORITY);
  const float r = speed * (1.0f - x * MANUAL_STEER_AUTHORITY);
  motors.set(clamp01(l), clamp01(r));
  g_lastSteer = x;
  leds.setSteer(x);
}

// ---------------------------------------------------------------------
//  Autonomer Linienfolger: PD-Regler auf die Sensordifferenz
// ---------------------------------------------------------------------
static void runAuto() {
  const uint32_t now = millis();

  if (!line.calibrated()) {      // ohne Kalibrierung keine Fahrt
    halt();
    g_phase = Phase::Lost;
    return;
  }

  if (line.lineVisible()) {
    g_lostSinceMs = 0;
    g_phase = Phase::Running;

    const float err = line.error();
    float dt = (now - g_lastCtrlMs) * 0.001f;
    if (dt < 0.001f) dt = 0.001f;         // Division durch Null vermeiden
    const float dErr = (err - g_lastError) / dt;
    g_lastError  = err;
    g_lastCtrlMs = now;
    if (fabsf(err) > 0.05f) g_lastErrSign = (err > 0) ? 1 : -1;

    drive(g_tune.base, g_tune.kp * err + g_tune.kd * dErr);
    return;
  }

  // Linie weg: erst pendelnd suchen, dann aufgeben
  if (g_lostSinceMs == 0) g_lostSinceMs = now;
  const uint32_t lost = now - g_lostSinceMs;

  if (lost > LINE_LOST_GIVEUP_MS) {
    halt();
    g_phase = Phase::Lost;
    return;
  }

  g_phase = Phase::Searching;
  // Zuerst in die Richtung drehen, in der die Linie zuletzt lag,
  // danach im Wechsel mit immer der anderen Seite.
  const bool flip    = ((lost / LINE_LOST_SEARCH_MS) & 1) != 0;
  const bool toRight = (g_lastErrSign >= 0) != flip;
  if (toRight) { motors.set(PIVOT_LEVEL, 0.0f); leds.setSteer(1.0f);  }
  else         { motors.set(0.0f, PIVOT_LEVEL); leds.setSteer(-1.0f); }
}

// ---------------------------------------------------------------------
//  Fahrprogramm abspielen
//
//  Der Interpreter rechnet nur aus, was er haben will -- Motoren und
//  LEDs werden hier gesetzt. So bleibt Program.* frei von Hardware.
// ---------------------------------------------------------------------
// Laufender Sensorbefehl (drehen, fahren bis Hindernis, warten bis frei)
static uint32_t g_awaitStartMs = 0;
static bool     g_awaitActive  = false;
static float    g_turnFrom     = 0.0f;
// Hindernis-Stopp als Schutzfunktion, in der Oberflaeche abschaltbar
static bool     g_obsGuard    = true;
static uint16_t g_obsGuardMm  = OBSTACLE_STOP_MM_DEFAULT;
// Kurs halten bei "geradeaus"
static uint8_t  g_holdSeq     = 255;
static float    g_holdRef     = 0.0f;

static void runProgram() {
  prog.update();

  if (!prog.running()) {
    halt();
    leds.setOverride(false);
    g_awaitActive = false;
    g_holdSeq     = 255;
    g_phase = prog.finished() ? Phase::ProgramDone : Phase::Idle;
    return;
  }

  g_phase = Phase::Running;

  // Lichter: im Programmbetrieb bestimmt der Ablauf jede LED einzeln
  leds.setOverride(true);
  for (uint8_t i = 0; i < LED_COUNT; i++) leds.setLed(i, prog.led(i));
  leds.setBlinkLevel(prog.blinkLevel());

  // ---------------- Befehle, die auf einen Sensor warten ----------------
  const Program::Await aw = prog.awaiting();
  if (aw != Program::Await::None) {

    if (!g_awaitActive) {            // erster Durchlauf dieses Befehls
      g_awaitActive  = true;
      g_awaitStartMs = millis();
      g_turnFrom     = imu.heading();
      if (aw == Program::Await::Turn && imu.present()) {
        imu.zeroHeading();           // Drift je Drehung neu nullen
        g_turnFrom = 0.0f;
      }
      g_holdSeq = 255;               // Kursregelung neu aufsetzen
    }

    const uint32_t elapsed = millis() - g_awaitStartMs;
    const float    level   = prog.awaitSpeed();
    bool done = false;

    switch (aw) {

      case Program::Await::Turn: {
        const int16_t want = prog.turnDegrees();       // + = rechts
        // Auf der Stelle drehen: nur die aeussere Seite vibriert
        if (want > 0) motors.set(level, 0.0f);
        else          motors.set(0.0f, level);
        leds.setSteer(want > 0 ? 1.0f : -1.0f);

        if (imu.present() && imu.calibrated()) {
          done = fabsf(imu.heading() - g_turnFrom) >= (fabsf((float)want) - TURN_TOLERANCE_DEG);
        } else {
          // Ohne Lagesensor bleibt nur eine Zeitschaetzung. Das ist keine
          // Winkelregelung, sondern eine Annahme -- die App sagt das auch.
          done = elapsed >= (uint32_t)(fabsf((float)want) / TURN_RATE_FALLBACK_DPS * 1000.0f);
        }
        if (elapsed > TURN_TIMEOUT_MS) done = true;
        break;
      }

      case Program::Await::Obstacle: {
        // Geradeaus, nach Moeglichkeit auf Kurs gehalten
        float s = 0.0f;
        if (imu.present() && imu.calibrated()) {
          if (g_holdSeq == 255) { g_holdSeq = prog.motionSeq(); g_holdRef = imu.heading(); }
          s = constrain(-HOLD_KP * (imu.heading() - g_holdRef), -HOLD_MAX, HOLD_MAX);
        }
        motors.set(clamp01(level + s), clamp01(level - s));
        g_lastSteer = s;

        done = dist.closerThan(prog.awaitMm())
            || elapsed > OBSTACLE_TIMEOUT_MS
            || !dist.present();        // ohne Sensor nicht erfuellbar
        break;
      }

      case Program::Await::TurnClear: {
        const int8_t dir = prog.awaitDir();
        if (dir > 0) motors.set(level, 0.0f);
        else         motors.set(0.0f, level);
        leds.setSteer(dir > 0 ? 1.0f : -1.0f);

        // "frei" heisst: nichts naeher als der Schwellwert
        done = !dist.closerThan(prog.awaitMm())
            || elapsed > OBSTACLE_TIMEOUT_MS
            || !dist.present();
        break;
      }

      case Program::Await::WaitClear:
        motors.stop();
        g_lastSteer = 0.0f;
        leds.setSteer(0.0f);
        done = !dist.closerThan(prog.awaitMm()) || !dist.present();
        break;

      default:
        done = true;
        break;
    }

    if (done) {
      g_awaitActive = false;
      motors.stop();
      prog.reportAwaitDone();
    }
    return;
  }
  g_awaitActive = false;

  // ---------------- Fahren ----------------
  if (!prog.moving()) {
    motors.stop();
    g_lastSteer = 0.0f;
    g_holdSeq   = 255;
    return;
  }

  float s = prog.steer();

  // Kurs halten, aber nur bei "geradeaus". In einer Kurve ist die
  // Drehbewegung ja genau das Gewollte.
  if (imu.present() && imu.calibrated() && fabsf(s) < 0.001f) {
    if (g_holdSeq != prog.motionSeq()) {     // neuer Geradeaus-Befehl
      g_holdSeq = prog.motionSeq();
      g_holdRef = imu.heading();
    }
    float corr = -HOLD_KP * (imu.heading() - g_holdRef);
    s = constrain(corr, -HOLD_MAX, HOLD_MAX);
  } else {
    g_holdSeq = 255;
  }

  motors.set(clamp01(prog.speed() + s), clamp01(prog.speed() - s));
  g_lastSteer = s;
}

// ---------------------------------------------------------------------
//  Funktionstest
//
//  Hat Vorrang vor allen Betriebsarten -- es ist ein Diagnosewerkzeug,
//  kein Fahrmodus. Die Freigabe braucht er trotzdem, weil Motoren laufen.
// ---------------------------------------------------------------------
static void runSelfTest() {
  selftest.update(imu.heading(), imu.present() && imu.calibrated(),
                  dist.valid() ? dist.mm() : 0, dist.present());
  g_phase = Phase::SelfTest;

  leds.setOverride(true);
  for (uint8_t i = 0; i < LED_COUNT; i++) leds.setLed(i, selftest.led(i));
  leds.setBlinkLevel(selftest.blinkLevel());

  motors.set(selftest.motorL(), selftest.motorR());
  g_lastSteer = 0.0f;
}

// =====================================================================
//  Anfragen der Web-App
// =====================================================================
static void leaveProgramMode() {
  prog.stop();
  selftest.stop();
  leds.setOverride(false);
}

static void applyRequests() {
  RcRequests q = rc.takeRequests();

  if (q.estop) {
    g_armed = false;
    leaveProgramMode();
    halt();
  }
  if (q.haveArm) {
    g_armed = q.arm;
    if (!g_armed) { leaveProgramMode(); halt(); }
  }
  if (q.haveMode && q.mode != g_mode) {
    g_mode = q.mode;
    leaveProgramMode();             // Betriebsart wechselt nie "fliegend"
    halt();
    g_lastError   = 0.0f;
    g_lostSinceMs = 0;
  }
  if (q.calibrate) {
    halt();
    line.startCalibration();
  }
  if (q.resetCal) {
    line.resetCalibration();
  }
  if (q.haveGuard) {
    g_obsGuard   = q.guard;
    g_obsGuardMm = q.guardMm;
  }
  if (q.zeroGyro) {
    halt();
    imu.startCalibration();       // Roboter muss dabei ruhig stehen
  }
  if (q.haveTuning) {
    g_tune = q.tuning;
    motors.setMinLevel(g_tune.minLevel);
    rc.publishTuning(g_tune);
    g_tuneDirtyMs = millis();       // NVS-Schreiben verzoegert, s. loop()
  }
  if (q.haveRun) {
    if (q.run) {
      // Ohne Freigabe laeuft kein Motor -- das Programm trotzdem starten
      // zu lassen waere irrefuehrend.
      selftest.stop();
      if (g_armed) prog.start();
    } else {
      leaveProgramMode();
      halt();
    }
  }
  if (q.haveTest) {
    if (q.test) {
      prog.stop();                 // Test und Fahrprogramm schliessen sich aus
      if (g_armed) selftest.start();
    } else {
      selftest.stop();
      leds.setOverride(false);
      halt();
    }
  }
}

// =====================================================================
//  Telemetrie
// =====================================================================
static void sendTelemetry() {
  char buf[640];   // 32 Felder, mit Reserve
  int n = snprintf(buf, sizeof(buf),
    "{\"p\":%u,\"m\":%u,\"a\":%u,\"sL\":%.3f,\"sR\":%.3f,\"e\":%.3f,"
    "\"dL\":%u,\"dR\":%u,\"dMax\":%u,\"calOk\":%u,\"hz\":%u,"
    "\"pr\":%u,\"pc\":%u,\"pn\":%u,\"pass\":%u,\"slot\":%u,"
    "\"ts\":%u,\"tp\":%u,\"tv\":%u,\"ti\":%d,\"tg\":%u,\"td\":%u,"
    "\"imu\":%u,\"hd\":%.1f,\"ic\":%u,\"az\":%.2f,\"mg\":%.2f,\"hoch\":%u,\"gcl\":%.1f,\"gpk\":%.0f,"
    "\"dsp\":%u,\"ds\":%u,\"og\":%u,\"om\":%u",
    (unsigned)g_phase, (unsigned)g_mode, g_armed ? 1u : 0u,
    line.linenessL(), line.linenessR(), line.error(),
    motors.dutyL(), motors.dutyR(), Motors::dutyMax(),
    line.calibrated() ? 1u : 0u, g_loopHz,
    prog.running() ? 1u : 0u, prog.pc(), prog.count(), prog.pass(), prog.activeSlot(),
    selftest.running() ? 1u : 0u, selftest.step(), selftest.percent(),
    selftest.info(), selftest.gyroVerdict(), selftest.distVerdict(),
    imu.present() ? 1u : 0u, imu.heading(), imu.calibrated() ? 1u : 0u,
    imu.accelZ(), imu.magnitude(), (imu.tipped() || imu.lifted()) ? 1u : 0u,
    imu.clipPct(), imu.peakDps(),
    dist.present() ? 1u : 0u, dist.valid() ? dist.mm() : 0u,
    g_obsGuard ? 1u : 0u, g_obsGuardMm);
#if FEATURE_BATTERY_MONITOR
  n += snprintf(buf + n, sizeof(buf) - n, ",\"vb\":%.2f", g_vbat);
#endif
  snprintf(buf + n, sizeof(buf) - n, "}");

  rc.sendTelemetry(buf);

#if FEATURE_SERIAL_DEBUG
  Serial.println(buf);
#endif
}

// =====================================================================
//  setup / loop
// =====================================================================
void setup() {
#if FEATURE_SERIAL_DEBUG
  Serial.begin(115200);
  delay(150);
  Serial.println();
  Serial.println(F("One-of-a-Kind Mars Rover startet"));
#endif

  // Reihenfolge ist Absicht: erst die Motoren auf Null, dann der Rest.
  motors.begin();
  leds.begin();
  leds.setPhase(Phase::Disarmed);
  line.begin();
  loadTuning();
  prog.begin();

  // Lagesensor ist optional: fehlt er, laeuft alles weiter, nur die
  // Drehbefehle fallen auf eine Zeitschaetzung zurueck.
  const bool imuOk  = imu.begin();
  const bool distOk = dist.begin();

#if FEATURE_MODE_BUTTON
  pinMode(PIN_MODE_BTN, INPUT_PULLUP);
#endif

  rc.publishTuning(g_tune);
  rc.attachProgram(&prog);
  rc.begin();

#if FEATURE_SERIAL_DEBUG
  Serial.printf("AP   : %s / %s\n", rc.ssid(), AP_PASSWORD);
  Serial.printf("URL  : http://%s/  oder  http://%s.local/\n",
                WiFi.softAPIP().toString().c_str(), rc.host());
  Serial.printf("Duty : max %u von %u (%.1f V Motor an %.1f V Schiene)\n",
                Motors::dutyMax(), PWM_FULL, MOTOR_RATED_V, MOTOR_SUPPLY_V);
  Serial.printf("Kal. : %s\n", line.calibrated() ? "geladen" : "FEHLT");
  Serial.printf("Prog : Platz %u \"%s\", %u Schritte\n",
                prog.activeSlot() + 1, prog.slotName(prog.activeSlot()), prog.count());
  Serial.printf("IMU  : %s%s\n", imuOk ? "MPU-6050 gefunden" : "nicht gefunden",
                (imuOk && !imu.calibrated()) ? " -- Nullpunkt fehlt, bitte nullen" : "");
  Serial.printf("Dist : %s\n", distOk ? "VL53L0X gefunden" : "nicht gefunden");
#else
  (void)imuOk; (void)distOk;
#endif

  g_lastCtrlMs = millis();
  g_hzWindowMs = millis();
  g_nextTeleMs = millis() + TELEMETRY_MS;
}

void loop() {
  const uint32_t now = millis();
  g_loopCount++;

  rc.loop();
  line.update();
  applyRequests();

#if FEATURE_MODE_BUTTON
  // Kurzer Druck schaltet die Betriebsart weiter
  const bool btn = digitalRead(PIN_MODE_BTN);
  if (btn != g_btnLast && (now - g_btnDebounceMs) > 40) {
    g_btnDebounceMs = now;
    g_btnLast = btn;
    if (btn == LOW) {
      g_mode = (g_mode == Mode::Manual) ? Mode::Auto
             : (g_mode == Mode::Auto)   ? Mode::Program
                                        : Mode::Manual;
      leaveProgramMode();
      halt();
    }
  }
#endif

#if FEATURE_BATTERY_MONITOR
  // Gleitender Mittelwert, der ADC ist durch die Motoren verrauscht
  const float v = analogReadMilliVolts(PIN_VBAT) * 0.001f * VBAT_DIVIDER;
  g_vbat = (g_vbat == 0.0f) ? v : (g_vbat * 0.99f + v * 0.01f);
#endif

  imu.update();
  dist.update();

  // Kurs selbsttaetig nullen, sobald der Rover aus dem Stand losfaehrt.
  // Vorher musste man dafuer von Hand auf den Knopf -- und ohne Nullen zeigt
  // die Rose den aufgelaufenen Drift der letzten Minuten statt der Drehung,
  // die man gerade machen will. Jedes Manoever faengt jetzt bei 0 Grad an.
  // Die Drehbefehle im Programm nullen zusaetzlich selbst, das stoert nicht.
  {
    const bool faehrt = (motors.dutyL() || motors.dutyR());
    if (faehrt) {
      if (!g_wasMoving && (millis() - g_stillSinceMs) > HEADING_ZERO_STILL_MS) {
        imu.zeroHeading();
      }
      g_wasMoving = true;
    } else {
      if (g_wasMoving) g_stillSinceMs = millis();
      g_wasMoving = false;
    }
  }


  // ---------------- Zustandsmaschine ----------------
  if (line.calibrating()) {
    halt();
    g_phase = Phase::Calibrating;
  }
  // Der Kippschutz greift NICHT mehr in die Steuerung ein. Auf einem
  // Ruettelantrieb ist das Beschleunigungssignal waehrend der Fahrt nicht
  // belastbar genug, um daraufhin die Freigabe wegzunehmen -- er hat genau
  // das getan, mitten in der Fahrt. Erkannt und gemeldet wird weiter: die
  // Oberflaeche blendet oben ein blinkendes Feld ein. Die Schwellen in
  // Config.h sind geschaetzt; bevor der Schutz zurueckkehrt, werden sie an
  // az und mg aus der Telemetrie gemessen.
#if FEATURE_BATTERY_MONITOR
  else if (g_vbat > 1.0f && g_vbat < VBAT_CUTOFF_V) {
    halt();
    g_armed = false;
    leaveProgramMode();
    g_phase = Phase::LowBattery;
  }
#endif
  else if (!g_armed) {
    halt();
    leaveProgramMode();             // Sperren beendet Test und Programm
    g_phase = Phase::Disarmed;
  }
  else if (selftest.running()) {
    runSelfTest();                  // Diagnose geht vor Betriebsart
  }
  // Hindernis-Stopp. Ausgenommen ist "fahre bis Hindernis" -- dieser
  // Befehl will ja gerade heranfahren.
  else if (g_obsGuard && dist.closerThan(g_obsGuardMm) &&
           prog.awaiting() == Program::Await::None) {
    halt();
    g_phase = Phase::Obstacle;
  }
  else if (g_mode == Mode::Manual) {
    runManual();                // setzt g_phase selbst (Running / Idle)
  }
  else if (g_mode == Mode::Auto) {
    runAuto();
  }
  else {
    runProgram();
  }

  leds.setPhase(g_phase);
  motors.update();
  leds.update();

  // Tuningwerte erst 1,5 s nach der letzten Aenderung sichern --
  // ein Schieberegler feuert sonst dutzende NVS-Schreibvorgaenge.
  if (g_tuneDirtyMs && (now - g_tuneDirtyMs) > 1500) {
    g_tuneDirtyMs = 0;
    saveTuning();
  }

  // Schleifenfrequenz messen (steht in der App, guter Gesundheitswert)
  if (now - g_hzWindowMs >= 1000) {
    g_loopHz = (uint16_t)g_loopCount;
    g_loopCount = 0;
    g_hzWindowMs = now;
  }

  if ((int32_t)(now - g_nextTeleMs) >= 0) {
    g_nextTeleMs = now + TELEMETRY_MS;
    sendTelemetry();
  }
}
