Darklirah/One-of-a-Kind-Mars-Rover/Firmware/MarsRover/RemoteControl.cpp

#include "RemoteControl.h"
#include "WebUI.h"
#include <ESPmDNS.h>

// Empfangspuffer. Statisch, weil ein komplettes Fahrprogramm hineinpasst
// und das auf dem Stack der WebSocket-Rueckrufe zu viel waere. Die
// Rueckrufe laufen alle im Kontext von loop(), also einfaedig -- ein
// gemeinsamer Puffer ist hier ungefaehrlich.
static char s_line[RC_LINE_MAX + 1];
static char s_out[PROG_MAX_CHARS + 128];

// Netznamen zusammensetzen. Eigener Name aus dem NVS, sonst die letzten
// vier Stellen der MAC -- so hat jedes Geraet ab Werk einen eigenen Namen,
// und mehrere Rover stoeren sich nicht gegenseitig.
void RemoteControl::buildSsid() {
  Preferences p;
  p.begin(NVS_NAMESPACE, true);
  String own = p.getString("apname", "");
  p.end();

  if (own.length() > 0) {
    snprintf(_ssid, sizeof(_ssid), "%s_%s", AP_PREFIX, own.c_str());
    snprintf(_apName, sizeof(_apName), "%s", own.c_str());
  } else {
    uint8_t mac[6] = {0};
    WiFi.softAPmacAddress(mac);
    snprintf(_ssid, sizeof(_ssid), "%s_%02X%02X", AP_PREFIX, mac[4], mac[5]);
    _apName[0] = '\0';                 // leer = automatische Kennung
  }
  buildHost();
}

// Der mDNS-Name wird aus dem Netznamen abgeleitet: klein geschrieben und
// mit Bindestrich statt Unterstrich, weil in einem Rechnernamen kein
// Unterstrich stehen darf.
//
//   WLAN  MarsRover_Petra  ->  http://marsrover-petra.local
//   WLAN  MarsRover_A3F2   ->  http://marsrover-a3f2.local
//
// Dadurch ist der Name immer aus dem WLAN ableitbar, in das man gerade
// gegangen ist, und zwei Rover stossen nicht zusammen.
void RemoteControl::buildHost() {
  uint8_t o = 0;
  for (const char* p = _ssid; *p && o < sizeof(_host) - 1; p++) {
    const char c = *p;
    if (c == '_' || c == ' ') _host[o++] = '-';
    else if (isalnum((unsigned char)c)) _host[o++] = (char)tolower((unsigned char)c);
    else if (c == '-') _host[o++] = '-';
  }
  _host[o] = '\0';
}

// Gilt die Anfrage uns selbst -- oder ist es eine der Pruefadressen, mit
// denen das Handy testet, ob das Netz ins Internet kommt?
bool RemoteControl::eigenerHost() {
  String h = _http.hostHeader();
  const int k = h.indexOf(':');            // Portangabe abschneiden
  if (k >= 0) h = h.substring(0, k);
  if (h.length() == 0) return true;        // kein Host-Kopf: uns gemeint
  if (h == WiFi.softAPIP().toString()) return true;
  if (h.equalsIgnoreCase(_host)) return true;
  if (h.equalsIgnoreCase(String(_host) + ".local")) return true;
  return false;
}

void RemoteControl::sendApp() {
  _http.sendHeader("Cache-Control", "no-store");
  _http.send_P(200, "text/html; charset=utf-8", WEBUI_HTML);
}

// Die Weiche fuers Anmeldefenster.
//
// Frueher lieferte der Roboter auch hier die volle Bedienoberflaeche aus.
// Das sah gut aus und war trotzdem falsch: iOS oeffnet dafuer eine
// eingeschraenkte WebView, in der **WebSockets oft nicht funktionieren**.
// Die Seite erschien, der Joystick tat nichts, und es sah nach einem
// Fehler aus. Jetzt kommt dort eine kleine Seite mit einem Knopf, die
// auch in der eingeschraenkten Ansicht zuverlaessig laeuft.
void RemoteControl::sendPortal() {
  const String ip = WiFi.softAPIP().toString();
  // 977 Byte bei kurzem Netznamen, rund 1030 bei einem ausgereizten.
  // 1400 lassen Luft, falls der Text noch waechst -- snprintf wuerde sonst
  // stillschweigend abschneiden und eine halbe Seite ausliefern.
  static char buf[1400];
  snprintf(buf, sizeof(buf),
    "<!DOCTYPE html><html lang=\"de\"><head><meta charset=\"utf-8\">"
    "<meta name=\"viewport\" content=\"width=device-width,initial-scale=1\">"
    "<title>%s</title><style>"
    "body{margin:0;background:#11141a;color:#e8edf5;"
    "font:16px/1.5 system-ui,-apple-system,sans-serif;padding:26px 20px}"
    "h1{font-size:19px;margin:0 0 6px}p{color:#8c97a8;margin:0 0 18px}"
    "a.b{display:block;text-align:center;background:#39d98a;color:#06121f;"
    "text-decoration:none;font-weight:700;font-size:17px;padding:16px;"
    "border-radius:13px}code{background:#232a35;padding:2px 6px;border-radius:5px}"
    "</style></head><body>"
    "<h1>%s ist verbunden</h1>"
    "<p>Zum Fahren die Bedienung &ouml;ffnen.</p>"
    "<a class=\"b\" href=\"http://%s/\">Bedienung &ouml;ffnen</a>"
    "<p style=\"margin-top:18px\">Reagiert der Joystick hier nicht, "
    "dieses Fenster schlie&szlig;en und im Browser "
    "<code>%s.local</code> oder <code>%s</code> aufrufen &mdash; "
    "dieses Anmeldefenster kann keine Dauerverbindung.</p>"
    "</body></html>",
    _ssid, _ssid, ip.c_str(), _host, ip.c_str());
  _http.sendHeader("Cache-Control", "no-store");
  _http.send(200, "text/html; charset=utf-8", buf);
}

bool RemoteControl::setApName(const char* name) {
  char clean[AP_NAME_MAX + 1];
  uint8_t o = 0;
  // Nur das, was in einem Netznamen nicht stoert. Leerzeichen und
  // Bindestriche werden zu Unterstrichen, alles Uebrige faellt weg.
  //
  // Umlaute werden vorher umgeschrieben (ae, oe, ue, ss). Ohne das wuerde
  // aus "Juergen" zwar "Juergen", aus "Jürgen" aber "Jrgen" -- die zwei
  // UTF-8-Bytes eines Umlauts sind einzeln kein isalnum() und fielen
  // stillschweigend weg. Fuer deutsche Namen ist das der Normalfall, nicht
  // die Ausnahme.
  for (const char* p = name; *p && o < AP_NAME_MAX; p++) {
    const unsigned char c = (unsigned char)*p;

    // UTF-8: die Umlaute liegen alle in C3 xx.
    if (c == 0xC3 && *(p + 1)) {
      const unsigned char d = (unsigned char)*(p + 1);
      const char* ers = nullptr;
      switch (d) {
        case 0xA4: case 0x84: ers = "ae"; break;   // ä Ä
        case 0xB6: case 0x96: ers = "oe"; break;   // ö Ö
        case 0xBC: case 0x9C: ers = "ue"; break;   // ü Ü
        case 0x9F:            ers = "ss"; break;   // ß
      }
      p++;                                  // das zweite Byte ist verbraucht
      if (!ers) continue;                   // anderes C3-Zeichen: weglassen
      // Grossbuchstabe bleibt gross: Ä -> Ae, nicht AE.
      const bool gross = (d == 0x84 || d == 0x96 || d == 0x9C);
      if (o < AP_NAME_MAX) clean[o++] = gross ? (char)toupper(ers[0]) : ers[0];
      if (o < AP_NAME_MAX) clean[o++] = ers[1];
      continue;
    }

    if (isalnum(c))                            clean[o++] = (char)c;
    else if (c == ' ' || c == '-' || c == '_') clean[o++] = '_';
  }
  clean[o] = '\0';

  Preferences p;
  p.begin(NVS_NAMESPACE, false);
  if (o > 0) p.putString("apname", clean);
  else       p.remove("apname");
  p.end();
  return true;
}

void RemoteControl::begin() {
  buildSsid();

  WiFi.mode(WIFI_AP);
  // Sendeleistung bewusst reduziert: spart Strom und die Reichweite im
  // Zimmer ist ohnehin mehr als ausreichend.
  WiFi.softAP(_ssid, AP_PASSWORD, AP_CHANNEL, 0 /*nicht versteckt*/, 4 /*max 4 Clients*/);
  WiFi.setTxPower(WIFI_POWER_11dBm);

  const IPAddress ip = WiFi.softAPIP();

  // Jeden DNS-Namen auf uns selbst zeigen lassen -> Captive Portal
  _dns.setErrorReplyCode(DNSReplyCode::NoError);
  _dns.start(53, "*", ip);

  // Unter einem Namen erreichbar machen: http://marsrover-petra.local
  // Das erspart das Abtippen der IP. iPhone und Mac koennen das von Haus
  // aus, Android ab Version 12 meistens.
  if (MDNS.begin(_host)) MDNS.addService("http", "tcp", 80);

  // Zwei verschiedene Antworten, je nachdem wer fragt:
  //
  //   Anfrage an uns (192.168.4.1 oder <name>.local)  -> die Bedienung
  //   Anfrage an irgendeinen fremden Namen            -> die Weiche
  //
  // Die fremden Namen sind die Pruefadressen, mit denen Android, iOS und
  // Windows testen, ob ein Netz ins Internet kommt. Sie am Host zu
  // erkennen ist zuverlaessiger, als ihre URLs einzeln aufzulisten -- die
  // aendern sich je nach Hersteller und Version.
  _http.on("/", HTTP_GET, [this]() {
    if (eigenerHost()) sendApp(); else sendPortal();
  });
  _http.onNotFound([this]() {
    if (eigenerHost()) sendApp(); else sendPortal();
  });
  _http.begin();

  _ws.begin();
  _ws.onEvent([this](uint8_t num, WStype_t type, uint8_t* payload, size_t len) {
    switch (type) {
      case WStype_CONNECTED:
        _clients++;
        _in.connected = true;
        _in.lastPacketMs = millis();
        // Der frischen Verbindung sofort sagen, wie der Roboter steht:
        // Tuningwerte und Belegung der Speicherplaetze.
        sendCfg(num);
        sendSlots(num);
        break;

      case WStype_DISCONNECTED:
        if (_clients) _clients--;
        if (_clients == 0) {
          _in.connected = false;
          // Verbindung weg: Joystick auf Null, der Totmannschalter
          // in der Hauptschleife haelt die Motoren an.
          _in.x = 0.0f;
          _in.y = 0.0f;
        }
        break;

      case WStype_TEXT:
        if (len == 0 || len > RC_LINE_MAX) break;
        memcpy(s_line, payload, len);
        s_line[len] = '\0';
        _in.lastPacketMs = millis();
        handleText(num, s_line);
        break;

      default:
        break;
    }
  });
}

// =====================================================================
//  Antworten an die App
// =====================================================================

// Nur was JSON zwingend braucht. UTF-8-Bytes ab 0x80 gehen unveraendert
// durch, das ist gueltiges JSON. Steuerzeichen fliegen raus.
void RemoteControl::jsonEscape(const char* in, char* out, size_t outLen) {
  size_t o = 0;
  for (const char* p = in; *p && o + 2 < outLen; p++) {
    const unsigned char c = (unsigned char)*p;
    if (c == '"' || c == '\\') { out[o++] = '\\'; out[o++] = (char)c; }
    else if (c >= 0x20)        { out[o++] = (char)c; }
  }
  out[o] = '\0';
}

void RemoteControl::sendCfg(uint8_t num) {
  char buf[256];
  char esc[AP_NAME_MAX * 2 + 2];
  jsonEscape(_apName, esc, sizeof(esc));
  snprintf(buf, sizeof(buf),
           "{\"t\":\"cfg\",\"kp\":%.3f,\"kd\":%.3f,\"base\":%.3f,\"min\":%.3f,"
           "\"ssid\":\"%s\",\"apname\":\"%s\"}",
           _lastTuning.kp, _lastTuning.kd, _lastTuning.base, _lastTuning.minLevel,
           _ssid, esc);
  _ws.sendTXT(num, buf);
}

// Namen und Belegung aller Speicherplaetze. Daraus baut die App die
// Slot-Auswahl samt "x von 48 Schritten".
void RemoteControl::sendSlots(int16_t num) {
  if (!_prog) return;
  size_t n = snprintf(s_out, sizeof(s_out),
                      "{\"t\":\"slots\",\"a\":%u,\"max\":%u,\"n\":[",
                      _prog->activeSlot(), Program::maxSteps());
  char esc[PROG_NAME_MAX * 2 + 2];
  for (uint8_t i = 0; i < PROG_SLOTS; i++) {
    jsonEscape(_prog->slotName(i), esc, sizeof(esc));
    n += snprintf(s_out + n, sizeof(s_out) - n, "%s\"%s\"", i ? "," : "", esc);
  }
  n += snprintf(s_out + n, sizeof(s_out) - n, "],\"c\":[");
  for (uint8_t i = 0; i < PROG_SLOTS; i++)
    n += snprintf(s_out + n, sizeof(s_out) - n, "%s%u", i ? "," : "", _prog->slotSteps(i));
  snprintf(s_out + n, sizeof(s_out) - n, "]}");

  if (num < 0) _ws.broadcastTXT(s_out);
  else         _ws.sendTXT((uint8_t)num, s_out);
}

void RemoteControl::broadcastSlots() { sendSlots(-1); }

void RemoteControl::sendProg(uint8_t num, uint8_t slot) {
  if (!_prog) return;
  char text[PROG_MAX_CHARS + 1];
  _prog->serialize(text, sizeof(text));
  char esc[PROG_NAME_MAX * 2 + 2];
  jsonEscape(_prog->slotName(slot), esc, sizeof(esc));
  snprintf(s_out, sizeof(s_out),
           "{\"t\":\"prog\",\"slot\":%u,\"name\":\"%s\",\"p\":\"%s\"}", slot, esc, text);
  _ws.sendTXT(num, s_out);
}

void RemoteControl::sendResult(uint8_t num, bool ok, const char* msg) {
  char esc[160];
  jsonEscape(msg, esc, sizeof(esc));
  char buf[200];
  snprintf(buf, sizeof(buf), "{\"t\":\"%s\",\"m\":\"%s\"}", ok ? "ok" : "err", esc);
  _ws.sendTXT(num, buf);
}

// =====================================================================
//  Befehle der App
// =====================================================================
void RemoteControl::handleText(uint8_t num, const char* line) {
  float a = 0, b = 0, c = 0, d = 0;

  switch (line[0]) {
    case 'J':
      if (sscanf(line + 1, ",%f,%f", &a, &b) == 2) {
        _in.x = constrain(a, -1.0f, 1.0f);
        _in.y = constrain(b, -1.0f, 1.0f);
      }
      break;

    case 'M':
      if (sscanf(line + 1, ",%f", &a) == 1) {
        const int m = (int)(a + 0.5f);
        _req.haveMode = true;
        _req.mode = (m == 2) ? Mode::Program : (m == 1) ? Mode::Auto : Mode::Manual;
      }
      break;

    case 'A':
      if (sscanf(line + 1, ",%f", &a) == 1) {
        _req.haveArm = true;
        _req.arm = (a >= 0.5f);
      }
      break;

    case 'X':
      _req.estop = true;
      _in.x = _in.y = 0.0f;
      break;

    case 'C': _req.calibrate = true; break;
    case 'G': _req.zeroGyro  = true; break;

    case 'O':
      if (sscanf(line + 1, ",%f,%f", &a, &b) == 2) {
        _req.haveGuard = true;
        _req.guard   = (a >= 0.5f);
        _req.guardMm = (uint16_t)constrain((int)b, (int)DIST_MIN_MM, (int)DIST_MAX_MM);
      }
      break;
    case 'R': _req.resetCal  = true; break;

    case 'T':
      if (sscanf(line + 1, ",%f,%f,%f,%f", &a, &b, &c, &d) == 4) {
        _req.haveTuning = true;
        _req.tuning.kp       = constrain(a, 0.0f, 3.0f);
        _req.tuning.kd       = constrain(b, 0.0f, 1.0f);
        _req.tuning.base     = constrain(c, 0.0f, 1.0f);
        _req.tuning.minLevel = constrain(d, 0.0f, 0.95f);
      }
      break;

    // ---- Fahrprogramm starten / stoppen ----
    case 'B':
      if (sscanf(line + 1, ",%f", &a) == 1) {
        _req.haveRun = true;
        _req.run = (a >= 0.5f);
        // Starten schaltet die Betriebsart gleich mit um -- der Startknopf
        // ist ohnehin nur in der Programmansicht sichtbar.
        if (_req.run) { _req.haveMode = true; _req.mode = Mode::Program; }
      }
      break;

    // ---- Speicherplatz laden ----
    case 'L':
      if (_prog && sscanf(line + 1, ",%f", &a) == 1) {
        const uint8_t slot = (uint8_t)constrain((int)a, 0, PROG_SLOTS - 1);
        if (_prog->loadSlot(slot)) sendProg(num, slot);
        else                       sendResult(num, false, _prog->lastError());
      }
      break;

    // ---- Speicherplatz schreiben:  W,<slot>|<name>|<text> ----
    case 'W': {
      if (!_prog) break;
      const char* p1 = strchr(line, '|');
      if (!p1) { sendResult(num, false, "Befehl unvollstaendig"); break; }
      const char* p2 = strchr(p1 + 1, '|');
      if (!p2) { sendResult(num, false, "Befehl unvollstaendig"); break; }

      const int slotNo = atoi(line + 2);
      if (slotNo < 0 || slotNo >= PROG_SLOTS) { sendResult(num, false, "Ungueltiger Speicherplatz"); break; }

      char name[PROG_NAME_MAX + 1];
      size_t nl = (size_t)(p2 - p1 - 1);
      if (nl > PROG_NAME_MAX) nl = PROG_NAME_MAX;
      memcpy(name, p1 + 1, nl);
      name[nl] = '\0';

      if (_prog->saveSlot((uint8_t)slotNo, name, p2 + 1)) {
        char msg[64];
        snprintf(msg, sizeof(msg), "Gespeichert: %u Schritte", _prog->count());
        sendResult(num, true, msg);
        broadcastSlots();
      } else {
        sendResult(num, false, _prog->lastError());
      }
      break;
    }

    // ---- Funktionstest starten / stoppen ----
    case 'S':
      if (sscanf(line + 1, ",%f", &a) == 1) {
        _req.haveTest = true;
        _req.test = (a >= 0.5f);
      }
      break;

    // ---- eigenen Netznamen setzen:  N|<name> ----
    case 'N': {
      const char* bar = strchr(line, '|');
      if (!bar) { sendResult(num, false, "Name fehlt"); break; }
      setApName(bar + 1);
      char msg[96];
      if (*(bar + 1)) snprintf(msg, sizeof(msg), "Netzname gespeichert -- nach dem Neustart aktiv");
      else            snprintf(msg, sizeof(msg), "Eigener Name geloescht -- wieder automatische Kennung");
      sendResult(num, true, msg);
      break;
    }

    // ---- Neustart ----
    case 'Z':
      sendResult(num, true, "Neustart...");
      delay(120);                 // der Meldung noch Zeit zum Rausgehen geben
      ESP.restart();
      break;

    case 'P':   // Ping -- lastPacketMs wurde oben schon aktualisiert
    default:
      break;
  }
}

RcRequests RemoteControl::takeRequests() {
  RcRequests out = _req;
  _req = RcRequests{};
  return out;
}

void RemoteControl::sendTelemetry(const char* json) {
  if (_clients) _ws.broadcastTXT(json);
}

void RemoteControl::loop() {
  _dns.processNextRequest();
  _http.handleClient();
  _ws.loop();
}
