Darklirah/One-of-a-Kind-Mars-Rover/Firmware/MarsRover/WebUI.h

// =====================================================================
//  MarsRover -- WebUI.h
//  Die komplette Bedienoberflaeche als eine Datei im Flash.
//
//  Gestaltungsvorgabe: einfach bedienbar, geeignet ab 14 Jahren.
//   * Klartext-Befehle, keine Kuerzel -- "warte 2,0 s", nicht "wa,2000"
//   * Baukasten statt Texteditor: Syntaxfehler sind nicht moeglich
//   * grosse Tippflaechen, Farbcodierung der Befehlsarten
//   * Reglerabstimmung (Kp/Kd) hinter einem zugeklappten Experten-Bereich
//   * jeder Speicherplatz zeigt belegte und freie Schritte an
//
//  Bewusst ohne jede externe Quelle (kein CDN, keine Webfonts): im
//  Access-Point-Betrieb gibt es keinen Internetzugang, alles was nicht
//  mitgeliefert wird, wuerde fehlen.
//
//  Abgestimmt auf die Eigenheiten von iOS Safari:
//   * Pointer Events statt Touch Events
//   * touch-action/overscroll gesperrt, damit das Wischen auf dem
//     Joystick nicht die Seite scrollt
//   * gesturestart abgefangen (kein Pinch-Zoom)
//   * maximum-scale=1, damit kein Doppeltipp-Zoom stoert
// =====================================================================
#pragma once
#include <Arduino.h>

static const char WEBUI_HTML[] PROGMEM = R"BBUI(<!DOCTYPE html>
<html lang="de">
<head>
<meta charset="utf-8">
<meta name="viewport" content="width=device-width,initial-scale=1,maximum-scale=1,user-scalable=no,viewport-fit=cover">
<meta name="theme-color" content="#11141a">
<meta name="apple-mobile-web-app-capable" content="yes">
<title>Mars Rover</title>
<style>
:root{
  --bg:#11141a; --panel:#1b2029; --panel2:#232a35; --panel3:#2b3340; --line:#2e3746;
  --fg:#e8edf5; --dim:#8c97a8;
  --accent:#4da3ff; --ok:#39d98a; --warn:#ffc24b; --bad:#ff5c6c; --purple:#b990ff;
  --pad:14px;
}
*{box-sizing:border-box;-webkit-tap-highlight-color:transparent}
html,body{margin:0;height:100%}
body{
  background:var(--bg); color:var(--fg);
  font:15px/1.4 -apple-system,BlinkMacSystemFont,"Segoe UI",Roboto,sans-serif;
  overscroll-behavior:none; user-select:none; -webkit-user-select:none;
  padding:env(safe-area-inset-top) env(safe-area-inset-right) env(safe-area-inset-bottom) env(safe-area-inset-left);
}
.wrap{max-width:560px;margin:0 auto;padding:var(--pad);display:flex;flex-direction:column;gap:var(--pad)}
header{display:flex;align-items:center;gap:10px}
h1{font-size:17px;margin:0;font-weight:600;letter-spacing:.2px;flex:1;
   overflow:hidden;text-overflow:ellipsis;white-space:nowrap}
/* Stiftknopf neben dem Namen -- das ist der Weg zum Umbenennen, und er
   soll immer sichtbar sein, nicht in den Experten vergraben. */
#bRename{flex:0 0 auto;background:var(--panel2);color:var(--dim);border:1px solid var(--line);
   font:inherit;font-size:15px;line-height:1;padding:7px 10px;border-radius:10px}
#bRename:active{background:var(--line);color:var(--fg)}

/* Dialog ueber der ganzen Seite: Erststart-Abfrage und Umbenennen teilen
   sich denselben. */
.ov{position:fixed;inset:0;background:#000b;display:flex;align-items:center;
    justify-content:center;padding:18px;z-index:50}
.ov[hidden]{display:none}
.dlg{background:var(--panel);border:1px solid var(--line);border-radius:16px;
     padding:18px;width:100%;max-width:420px;box-shadow:0 20px 60px #000a;
     max-height:86vh;overflow:auto}
.dlg h3{margin:0 0 8px;font-size:17px;font-weight:600}
.dlg input[type=text]{margin-bottom:6px}
.dlgrow{display:flex;gap:9px;margin-top:14px}
.dlgrow .btn{flex:0 0 auto}
.dlgrow .big{flex:1;margin:0;font-size:15px;padding:14px}
#dot{width:10px;height:10px;border-radius:50%;background:var(--bad);flex:0 0 auto;
     box-shadow:0 0 0 3px rgba(255,92,108,.15)}
#dot.on{background:var(--ok);box-shadow:0 0 0 3px rgba(57,217,138,.18)}
#conn{font-size:12px;color:var(--dim)}
.card{background:var(--panel);border:1px solid var(--line);border-radius:14px;padding:var(--pad)}
.card h2{font-size:13px;margin:0 0 10px;color:var(--dim);font-weight:600;
         text-transform:uppercase;letter-spacing:.06em}
.row{display:flex;gap:8px;align-items:center}

/* --- Fahrprogramm: die drei Arbeitsschritte farblich voneinander
       abgesetzt. Sonst scrollt man auf dem Handy durch eine einzige graue
       Flaeche und weiss nicht mehr, in welchem Teil man gerade ist.
       Die Farben sind dieselben, mit denen die Schrittliste ihre
       Befehlsarten markiert -- blau fahren, gelb Licht usw.          --- */
.sec{border:1px solid var(--line);border-left:5px solid var(--dim);
     border-radius:13px;padding:12px;margin:0 0 14px}
.card .sec h2{font-size:18px;font-weight:700;color:var(--fg);margin:0 0 4px;
     text-transform:none;letter-spacing:0}
.sec .sub{font-size:12px;color:var(--dim);margin:0 0 12px}
.sec.s1{background:#1a2432;border-left-color:var(--accent)}
.sec.s2{background:#16271f;border-left-color:var(--ok)}
.sec.s3{background:#2a2419;border-left-color:var(--warn)}

/* --- Betriebsart: drei grosse Flaechen --- */
/* Vier Flaechen statt drei: der Funktionstest ist jetzt eine Betriebsart
   wie die anderen und nicht mehr eine Karte weiter unten. Dafuer muss die
   Schrift etwas kleiner werden -- vier Spalten auf 390 px sind rund 86 px
   je Knopf. */
.modes{display:grid;grid-template-columns:repeat(4,1fr);gap:7px}
.modes button{border:1px solid var(--line);background:var(--panel2);color:var(--dim);
  font:inherit;font-weight:600;font-size:11.5px;padding:12px 2px;border-radius:12px;line-height:1.25}
.modes button.sel{background:var(--accent);border-color:var(--accent);color:#06121f}
.modes button i{display:block;font-style:normal;font-size:20px;margin-bottom:4px;line-height:1}

.big{width:100%;border:0;border-radius:13px;font:inherit;font-weight:700;font-size:16px;
     padding:16px;color:#06121f;background:var(--ok)}
.big.armed{background:var(--bad);color:#fff}

/* --- Freigabe und Nothalt in einer Zeile ---
   Der Nothalt bekommt etwas weniger Breite als die Freigabe: er ist der
   kuerzere Text, und so bleibt die Freigabe die Flaeche, die man im
   Normalbetrieb trifft. Umrandet statt gefuellt, damit er sich von der
   gefuellten roten Flaeche "Motoren sperren" unterscheidet -- sonst sind
   bei freigegebenen Motoren zwei gleich aussehende rote Knoepfe
   nebeneinander. */
/* Klebt am oberen Rand. Der Nothalt nuetzt nur, wenn er da ist, wenn man
   ihn braucht -- und das ist nie der Moment, in dem man erst scrollen
   will. Deckender Hintergrund, damit nichts durchscheint; die negativen
   Seitenraender ziehen die Leiste ueber die Polsterung von .wrap, sonst
   rutscht der Inhalt seitlich daran vorbei. */
/* --- Hochgehoben: blinkendes Feld ganz oben --- */
#hoch{display:none;grid-column:1/-1;background:var(--bad);color:#fff;
      font-weight:700;letter-spacing:.03em;text-align:center;
      padding:9px 10px;border-radius:10px;
      animation:hochBlink 1s steps(1,end) infinite}
#hoch.an{display:block}
@keyframes hochBlink{50%{background:transparent;color:var(--bad);
                         box-shadow:inset 0 0 0 2px var(--bad)}}
@media (prefers-reduced-motion:reduce){#hoch{animation:none}}
.toprow{display:grid;grid-template-columns:1.35fr 1fr;gap:9px;
        position:sticky;top:0;z-index:30;background:var(--bg);
        margin:0 calc(-1 * var(--pad));
        padding:var(--pad) var(--pad) 10px}
#bStop{background:transparent;color:var(--bad);
       box-shadow:inset 0 0 0 2px var(--bad);letter-spacing:.04em}
#bStop:active{background:var(--bad);color:#fff}
.btn{border:1px solid var(--line);background:var(--panel2);color:var(--fg);font:inherit;
     padding:12px 14px;border-radius:11px;font-weight:600}
.btn:active{background:var(--panel3)}
.btn.pri{background:var(--accent);border-color:var(--accent);color:#06121f}
.btn.sm{padding:9px 11px;font-size:13px}

#pad{position:relative;width:100%;aspect-ratio:1/1;max-height:62vh;margin:0 auto;
     background:var(--panel2);border:1px solid var(--line);border-radius:22px;
     touch-action:none;overflow:hidden}
#cross:before,#cross:after{content:"";position:absolute;background:var(--line)}
#cross:before{left:8%;right:8%;top:50%;height:1px}
#cross:after{top:8%;bottom:8%;left:50%;width:1px}
#knob{position:absolute;width:30%;height:30%;left:35%;top:35%;border-radius:50%;
      background:var(--accent);opacity:.92;box-shadow:0 6px 18px #0008;
      transition:transform .08s ease-out}
#padhint{position:absolute;left:0;right:0;bottom:9px;text-align:center;font-size:11px;color:var(--dim)}

/* --- Startleiste des Fahrprogramms ---
   Klebt am oberen Rand des Programmbereichs. Der Hintergrund muss deckend
   sein, sonst scheinen die Schritte beim Scrollen durch; der negative
   Rand gleicht die Polsterung der Karte aus, damit nichts seitlich
   darunter durchrutscht. */
/* Klebt direkt UNTER der oberen Leiste, nicht am Fensterrand -- sonst
   verschwindet der Startknopf dahinter. --topH wird beim Start gemessen
   und bei jeder Groessenaenderung nachgezogen. */
#runbar{position:sticky;top:var(--topH,86px);z-index:20;background:var(--panel);
        margin:calc(-1 * var(--pad)) calc(-1 * var(--pad)) 12px;
        padding:var(--pad) var(--pad) 10px;
        border-bottom:1px solid var(--line)}
#prun{font-size:12.5px;color:var(--dim);margin-top:6px;text-align:center}

/* --- Kompassrose im Funktionstest --- */
#rose{margin:14px 0 4px;text-align:center}
#rose svg{width:190px;max-width:62%;height:auto;display:block;margin:0 auto}
#rose .rg{fill:none;stroke:var(--line);stroke-width:1.5}
#rose .rt line{stroke:var(--line);stroke-width:1.5}
#rose .rt line.maj{stroke:var(--dim)}
#rose .rl{fill:var(--dim);font-size:11px;font-family:inherit}
#rose .rn{fill:var(--accent)}            /* Nase */
#rose .rs{fill:var(--panel3)}            /* Heck */
#rose .rc{fill:var(--fg)}
#roseNeedle{transition:transform .12s linear;transform-origin:0 0}
/* Rohwerte des Lagesensors -- damit sichtbar wird, was die Vibration
   aus den Beschleunigungswerten macht. Rot, sobald sie das Fenster des
   Kippwaechters verlassen. */
#lage{font-size:12px;color:var(--dim);margin:2px 0 4px;font-variant-numeric:tabular-nums}
#lage.raus{color:var(--bad);font-weight:700}
#lage .sp{opacity:.55;font-weight:400}
#roseTxt{font-size:15px;font-weight:700;color:var(--fg);
         font-variant-numeric:tabular-nums;margin-top:4px}

label{display:block;font-size:12px;color:var(--dim);margin:0 0 6px}
label b{color:var(--fg);font-variant-numeric:tabular-nums;font-weight:600}
input[type=range]{width:100%;margin:0 0 12px;accent-color:var(--accent);height:30px}
select,input[type=text]{width:100%;background:var(--panel2);color:var(--fg);font:inherit;
  border:1px solid var(--line);border-radius:10px;padding:11px;margin:0 0 10px}

/* --- Speicherplaetze --- */
.slots{display:grid;grid-template-columns:repeat(2,1fr);gap:8px;margin-bottom:12px}
.slots button{border:1px solid var(--line);background:var(--panel2);color:var(--fg);
  font:inherit;text-align:left;padding:10px 11px;border-radius:11px}
.slots button.sel{border-color:var(--accent);background:#1d2b3d}
.slots button span{display:block;font-weight:600;font-size:13.5px;
  overflow:hidden;text-overflow:ellipsis;white-space:nowrap}
.slots button em{display:block;font-style:normal;font-size:11px;color:var(--dim);margin-top:2px}
.slots button.sel em{color:var(--accent)}

/* --- Schrittliste --- */
#steps{list-style:none;margin:0 0 10px;padding:0;display:flex;flex-direction:column;gap:5px}
#steps li{display:flex;align-items:center;gap:8px;background:var(--panel2);
  border-radius:9px;padding:9px 8px 9px 0;border-left:4px solid var(--dim)}
#steps li.drive{border-left-color:var(--accent)}
#steps li.wait {border-left-color:var(--dim)}
#steps li.light{border-left-color:var(--warn)}
#steps li.loop {border-left-color:var(--purple)}
#steps li.now{background:#243a2e;box-shadow:inset 0 0 0 1px var(--ok)}
#steps li var{font-style:normal;color:var(--dim);font-size:11.5px;width:22px;
  text-align:right;font-variant-numeric:tabular-nums;flex:0 0 auto}
/* Der Schritttext ist antippbar (oeffnet den Befehlsdialog), sieht aber
   nicht wie ein Knopf aus -- er soll Text bleiben. Der Stift am Ende ist
   der einzige Hinweis darauf, dass sich da etwas aendern laesst. */
#steps li .stx{margin:0;flex:1;font-size:14px;text-align:left;
  background:none;border:0;color:var(--fg);font-family:inherit;padding:0}
#steps li .stx:after{content:" \270e";color:var(--dim);font-size:12px}
#steps li .stx:active{color:var(--accent)}
#steps li .acts{display:flex;gap:3px;flex:0 0 auto}
#steps li .acts button{border:0;background:var(--panel3);color:var(--dim);
  width:30px;height:30px;border-radius:8px;font-size:14px;font-weight:700;line-height:1;padding:0}
#steps li .acts button.del{color:var(--bad)}
#empty{color:var(--dim);font-size:13px;text-align:center;padding:14px 0 18px}

/* --- Schrittzaehler --- */
.gauge{margin:0 0 12px}
.gauge .t{display:flex;justify-content:space-between;font-size:12px;color:var(--dim);margin-bottom:5px}
.gauge .t b{color:var(--fg)}
.gauge .t b.full{color:var(--bad)}
.gauge .g{height:6px;background:var(--panel2);border-radius:3px;overflow:hidden}
.gauge .g i{display:block;height:100%;width:0;background:var(--accent);transition:width .15s}
.gauge .g i.full{background:var(--bad)}

/* --- Befehl hinzufuegen --- */
/* Eingabefelder im Befehlsbaukasten dunkler als der Blockhintergrund,
   sonst verschwimmen sie mit ihm. */
.sec.s3 select,.sec.s3 input[type=text]{background:var(--panel);margin-bottom:9px}
.sec .two{display:grid;grid-template-columns:1fr 1fr;gap:9px}

/* --- Befehlsliste ---
   Das native <select> bleibt als Datenspeicher stehen, wird aber
   ausgeblendet: die Gruppenueberschriften eines <select> zeichnet das
   Betriebssystem, und auf dem Handy ignoriert es jede Formatierung. Die
   sichtbare Liste darueber ist deshalb selbst gebaut. Sie wird aus eben
   diesem <select> erzeugt, damit die Befehle nur an einer Stelle stehen. */
#aOp{display:none}
#opList{display:flex;flex-direction:column;margin:0}
.opg{display:block;width:100%;text-align:left;background:none;border:0;
     font:inherit;font-size:15px;font-weight:700;color:#ffe08a;
     margin:13px 0 5px;padding:2px}
.opg:first-child{margin-top:0}
.opg .arr{display:inline-block;width:16px;color:var(--dim);font-weight:400}
.opgrp{display:flex;flex-direction:column;gap:4px}
.opgrp.zu{display:none}
.opb{border:1px solid var(--line);background:var(--panel);color:var(--fg);
     font:inherit;font-size:13.5px;text-align:left;padding:9px 12px;border-radius:10px}
.opb.sel{background:var(--accent);border-color:var(--accent);color:#06121f;font-weight:700}

.bars{display:grid;grid-template-columns:auto 1fr;gap:5px 9px;align-items:center;font-size:12px;color:var(--dim)}
.bar{height:9px;background:var(--panel2);border-radius:5px;overflow:hidden;position:relative}
.bar i{display:block;height:100%;width:0;background:var(--accent);transition:width .1s linear}
.bar.err i{position:absolute;left:50%;background:var(--warn)}
#status{font-size:13px;color:var(--dim);min-height:18px}
#status.bad{color:var(--bad)} #status.warn{color:var(--warn)} #status.ok{color:var(--ok)}
#toast{font-size:13px;min-height:17px;margin-top:4px}
#toast.ok{color:var(--ok)} #toast.bad{color:var(--bad)}
#prun{font-size:13px;color:var(--ok);font-variant-numeric:tabular-nums;min-height:17px;margin-top:8px}
#imuline{font-size:12px;color:var(--dim);margin-top:9px;font-variant-numeric:tabular-nums}
#imuline.warn{color:var(--warn)}
#tres{font-size:12.5px;margin-top:6px}
#tres div{margin-top:2px;color:var(--dim)}
#tres div.ok{color:var(--ok)} #tres div.bad{color:var(--bad)} #tres div.warn{color:var(--warn)}
#tphase{font-size:13px;color:var(--warn);font-variant-numeric:tabular-nums;min-height:17px;margin-top:8px}

details{background:var(--panel2);border-radius:11px;padding:0}
details summary{padding:12px var(--pad);font-size:13px;font-weight:600;color:var(--dim);
  cursor:pointer;list-style:none}
details summary::-webkit-details-marker{display:none}
details summary:before{content:"\25B8  "}
details[open] summary:before{content:"\25BE  "}
details .inner{padding:0 var(--pad) 6px}

.hide{display:none!important}
.note{font-size:11.5px;color:var(--dim);margin:2px 0 0}
</style>
</head>
<body>
<div class="wrap">

  <header>
    <div id="dot"></div>
    <h1 id="hdr">Mars Rover</h1>
    <button id="bRename" title="Roboter umbenennen" aria-label="Roboter umbenennen">&#9998;</button>
    <div id="conn">verbinde&hellip;</div>
  </header>

  <!-- Freigabe und Nothalt in einer Zeile ganz oben. Der Nothalt stand
       vorher am Seitenende -- genau dort, wo man ihn nicht findet,
       wenn es eilt. -->
  <div class="toprow">
    <!-- Meldung ueber beiden Knoepfen, volle Breite. Sie sitzt IN der
         klebenden Leiste, damit sie beim Scrollen oben bleibt und
         messeTopH() ihre Hoehe mitzaehlt. -->
    <div id="hoch">Roboter wurde hochgehoben</div>
    <button id="arm" class="big">Freigeben</button>
    <button class="big" id="bStop">NOTHALT</button>
  </div>

  <div class="card">
    <h2>Was soll er machen?</h2>
    <div class="modes">
      <button id="mT"><i>&#9881;</i>Funktions-<br>test</button>
      <button id="m1"><i>&#9473;</i>Linien-<br>folger</button>
      <button id="m0" class="sel"><i>&#9679;</i>Selbst<br>fahren</button>
      <button id="m2"><i>&#9654;</i>Pro-<br>gramm</button>
    </div>
  </div>

  <!-- ============ Selbst fahren ============ -->
  <div class="card" id="panManual">
    <div id="pad"><div id="cross"></div><div id="knob"></div>
      <div id="padhint">hoch = schneller &middot; seitlich = lenken</div>
    </div>
    <p class="note">R&uuml;ckw&auml;rts gibt es bauartbedingt nicht: ein Vibrationsmotor
       treibt den Roboter nur in Borstenrichtung. Joystick nach unten = Halt.</p>
  </div>

  <!-- ============ Linie folgen ============ -->
  <div class="card hide" id="panAuto">
    <label>Grundgeschwindigkeit <b id="vBase">55</b> %</label>
    <input type="range" id="sBase" min="0" max="100" value="55">
    <button class="btn" id="bCal" style="width:100%">Linie kalibrieren</button>
    <p class="note">Antippen und den Roboter 5 Sekunden langsam quer &uuml;ber die
       Linie hin und her schwenken, so dass beide Sensoren einmal die Linie und
       einmal den hellen Untergrund sehen.</p>
  </div>

  <!-- ============ Fahrprogramm ============ -->
  <div class="card hide" id="panProg">
    <!-- Startleiste: bleibt beim Scrollen oben stehen. Ein laufendes
         Programm muss sich jederzeit anhalten lassen, ohne erst ans
         Ende einer langen Schrittliste scrollen zu muessen. -->
    <div id="runbar">
      <button class="big" id="bRun">&#9654;&ensp;Programm starten</button>
      <div id="prun"></div>
    </div>

    <div class="sec s1">
      <h2>Speicherplatz</h2>
      <p class="sub">Vier Pl&auml;tze im Flash. Hier aussuchen, welchen du
         bearbeitest, und ihm einen Namen geben.</p>
      <div class="slots" id="slots"></div>

      <label>Name</label>
      <input type="text" id="pname" maxlength="20" placeholder="z.B. Achter fahren">
    </div>

    <div class="sec s2">
      <h2>Ablauf</h2>
      <p class="sub">Die Befehle in der Reihenfolge, in der er sie abarbeitet.
         Der Farbstreifen links zeigt die Art des Befehls.</p>
      <ol id="steps"></ol>
      <div id="empty">Noch leer &mdash; unten einen Fahrbefehl hinzuf&uuml;gen.</div>

      <div class="gauge">
        <div class="t"><span>Schritte</span>
          <span><b id="gUsed">0</b> von <b id="gMax">48</b> belegt &middot; <b id="gFree">48</b> frei</span></div>
        <div class="g"><i id="gBar"></i></div>
      </div>
    </div>

    <div class="sec s3">
      <h2>Fahrbefehl hinzuf&uuml;gen</h2>
      <p class="sub">Auf einen Befehl tippen &mdash; die Einstellungen und
         das Einf&uuml;gen kommen dann im Fenster.</p>
      <select id="aOp">
        <optgroup label="Fahren">
          <option value="ge">geradeaus fahren</option>
          <option value="li">Kurve nach links</option>
          <option value="re">Kurve nach rechts</option>
          <option value="dl">drehen nach links um &hellip; Grad</option>
          <option value="dr">drehen nach rechts um &hellip; Grad</option>
          <option value="fh">fahren bis Hindernis</option>
          <option value="tl">drehen nach links, bis frei</option>
          <option value="tr">drehen nach rechts, bis frei</option>
          <option value="wf">warten, bis der Weg frei ist</option>
          <option value="st">anhalten</option>
        </optgroup>
        <optgroup label="Zeit">
          <option value="wa">warten</option>
        </optgroup>
        <optgroup label="Licht">
          <option value="ld">LED schalten</option>
          <option value="bf">Blinkfrequenz einstellen</option>
        </optgroup>
        <optgroup label="Ablauf">
          <option value="lo">von vorn wiederholen</option>
        </optgroup>
      </select>
      <div id="opList"></div>

    </div>

    <div class="row">
      <button class="btn pri" id="bSave" style="flex:1">Speichern</button>
      <button class="btn" id="bReload">Verwerfen</button>
      <button class="btn" id="bClear">Leeren</button>
    </div>
    <div id="toast"></div>

    <p class="note">Der Roboter hat keine Wegmessung. Ein Programm l&auml;uft rein
       nach der Zeit &ndash; dieselben 2 Sekunden sind je nach Akkustand und
       Untergrund eine unterschiedliche Strecke.</p>
  </div>

  <!-- ============ Messwerte ============ -->
  <div class="card">
    <h2>Messwerte</h2>
    <div class="bars">
      <span>Sensor L</span><div class="bar"><i id="bL"></i></div>
      <span>Sensor R</span><div class="bar"><i id="bR"></i></div>
      <span>Ablage</span><div class="bar err"><i id="bE"></i></div>
      <span>Motor L</span><div class="bar"><i id="bML" style="background:var(--ok)"></i></div>
      <span>Motor R</span><div class="bar"><i id="bMR" style="background:var(--ok)"></i></div>
    </div>
    <div id="imuline"></div>
    <div id="status" style="margin-top:10px">&mdash;</div>
  </div>

  <!-- ============ Funktionstest ============ -->
  <div class="card hide" id="panTest">
    <h2>Funktionstest</h2>
    <button class="big" id="bTest" style="background:var(--warn)">Funktionstest starten</button>
    <div id="tphase"></div>

    <!-- Kompassrose: 0 Grad oben, im Uhrzeigersinn. Eine Gradzahl allein
         sagt beim Drehtest wenig -- man sieht nicht, ob sich der Rover in
         die richtige Richtung dreht und wie weit er schon ist. -->
    <div id="rose">
      <svg viewBox="-60 -60 120 120" aria-label="Kompassrose">
        <circle class="rg" cx="0" cy="0" r="52"></circle>
        <circle class="rg" cx="0" cy="0" r="26"></circle>
        <g class="rt" id="roseTicks"></g>
        <!-- Die Zahlen sitzen INNEN zwischen den beiden Ringen. Aussen
             lagen sie auf den Teilstrichen und waren durchgestrichen. -->
        <text class="rl" x="0"   y="-30" text-anchor="middle">0&#176;</text>
        <text class="rl" x="34"  y="4"   text-anchor="middle">90</text>
        <text class="rl" x="0"   y="38"  text-anchor="middle">180</text>
        <text class="rl" x="-34" y="4"   text-anchor="middle">270</text>
        <g id="roseNeedle">
          <polygon class="rn" points="0,-50 7,0 0,9 -7,0"></polygon>
          <polygon class="rs" points="0,50 7,0 0,-9 -7,0"></polygon>
        </g>
        <circle class="rc" cx="0" cy="0" r="4.5"></circle>
      </svg>
      <div id="roseTxt">&mdash;</div>
      <div id="lage">&mdash;</div>
    </div>

    <div id="tres"></div>
    <p class="note">Pr&uuml;ft alles der Reihe nach: die vier LEDs einzeln, dann alle
       gemeinsam blinkend, dann Motor links von langsam auf schnell, dann Motor
       rechts. Beim Motortest leuchtet die LED der getesteten Seite &ndash; so f&auml;llt
       auf, wenn Motor und Seite vertauscht verdrahtet sind. Zum Schluss dreht er
       sich einmal nach rechts und einmal nach links und pr&uuml;ft dabei den
       Lagesensor &ndash; auch auf die Drehrichtung &ndash; und zeigt den Messwert des
       Abstandssensors. L&auml;uft in Schleife, bis du ihn stoppst. Braucht die
       Freigabe, weil Motoren anlaufen.</p>
  </div>

  <!-- ============ Experten ============ -->
  <details>
    <summary>Experten &ndash; Feinabstimmung</summary>
    <div class="inner">
      <label>Anlaufschwelle Motoren <b id="vMin">35</b> %</label>
      <input type="range" id="sMin" min="0" max="90" value="35">
      <label>Kp &ndash; Lenkst&auml;rke <b id="vKp">0.55</b></label>
      <input type="range" id="sKp" min="0" max="200" value="55">
      <label>Kd &ndash; D&auml;mpfung <b id="vKd">0.08</b></label>
      <input type="range" id="sKd" min="0" max="100" value="8">
      <label style="display:flex;align-items:center;gap:9px;margin-bottom:10px">
        <input type="checkbox" id="cGuard" checked style="width:20px;height:20px;accent-color:var(--accent)">
        <span style="color:var(--fg)">Hindernis-Stopp aktiv</span>
      </label>
      <label>anhalten unter <b id="vGuard">90</b> mm Abstand</label>
      <input type="range" id="sGuard" min="40" max="600" step="10" value="90">
      <label>WLAN dieses Rovers <b id="vSsid">&mdash;</b></label>
      <button class="btn sm" id="bRename2" style="width:100%;margin-bottom:9px">Roboter umbenennen</button>
      <button class="btn sm" id="bGyro" style="width:100%;margin-bottom:9px">Lagesensor nullen</button>
      <button class="btn sm" id="bCalReset" style="width:100%">Linien-Kalibrierung l&ouml;schen</button>
      <p class="note">Anlaufschwelle so weit hochdrehen, bis beide Motoren gerade
         sicher anlaufen. Kp und Kd nur im Modus &bdquo;Linie folgen&ldquo; wirksam.</p>
    </div>
  </details>

</div>

<!-- ============ Namensdialog ============
     Einer fuer beides: die Abfrage beim ersten Start und das spaetere
     Umbenennen. Unterschiedlich sind nur Ueberschrift, Einleitung und die
     Beschriftung des Abbruchknopfes.                                    -->
<!-- ============ Befehlsdialog ============
     Einer fuer beides: einen neuen Befehl einfuegen und einen schon
     vorhandenen Schritt aendern. Unterschiedlich sind nur Ueberschrift
     und die Beschriftung des rechten Knopfes.                        -->
<div class="ov" id="opOv" hidden>
  <div class="dlg">
    <h3 id="opTitle">Befehl</h3>
    <p class="sub" id="opHint" style="margin-top:0"></p>
    <div id="pRad" class="hide">
      <label>Kurvenradius Stufe <b id="vRad">3</b> &ndash; <span id="tRad">eng</span></label>
      <input type="range" id="aRad" min="1" max="10" value="3">
    </div>
    <div id="pDeg" class="hide">
      <label>Drehwinkel <b id="vDeg">90</b>&deg;</label>
      <input type="range" id="aDeg" min="5" max="360" step="5" value="90">
    </div>
    <div id="pObs" class="hide">
      <label>anhalten bei <b id="vObs">150</b> mm Abstand</label>
      <input type="range" id="aObs" min="40" max="1200" step="10" value="150">
    </div>
    <div id="pSpd" class="hide">
      <label>Geschwindigkeit <b id="vSpd">60</b> %</label>
      <input type="range" id="aSpd" min="1" max="100" value="60">
    </div>
    <div id="pWa" class="hide">
      <label>Wartezeit <b id="vWa">2,0</b> Sekunden</label>
      <input type="range" id="aWa" min="1" max="200" value="20">
    </div>
    <div id="pLd" class="hide">
      <div class="two">
        <select id="aLdT">
          <option value="0">LED vorne links</option>
          <option value="1">LED vorne rechts</option>
          <option value="2">LED hinten links</option>
          <option value="3">LED hinten rechts</option>
          <option value="4">beide vorne</option>
          <option value="5">beide hinten</option>
          <option value="6">alle vier</option>
        </select>
        <select id="aLdS">
          <option value="1">einschalten</option>
          <option value="0">ausschalten</option>
          <option value="2">blinken</option>
        </select>
      </div>
    </div>
    <div id="pBf" class="hide">
      <label>Blinken Stufe <b id="vBf">4</b> &ndash; <span id="tBf">2,0</span> mal pro Sekunde</label>
      <input type="range" id="aBf" min="1" max="10" value="4">
    </div>
    <div id="pLo" class="hide">
      <label>Wiederholungen <b id="vLo">0</b> &ndash; <span id="tLo">endlos</span></label>
      <input type="range" id="aLo" min="0" max="10" value="0">
    </div>
    <div class="dlgrow">
      <button class="btn sm" id="opCancel">Abbrechen</button>
      <button class="big" id="opOk">Einf&uuml;gen</button>
    </div>
  </div>
</div>

<div class="ov" id="nameOv" hidden>
  <div class="dlg">
    <h3 id="nameTitle">Wie soll dein Rover hei&szlig;en?</h3>
    <p class="note" id="nameIntro" style="margin-top:0"></p>
    <input type="text" id="nameIn" maxlength="16" placeholder="z.B. Petra"
           autocomplete="off" autocapitalize="words" spellcheck="false">
    <p class="note" style="margin:0">Er hei&szlig;t dann im WLAN
       <b id="namePrev">&mdash;</b>. Erlaubt sind Buchstaben und Ziffern;
       Leerzeichen und Bindestriche werden zu Unterstrichen, alles
       &Uuml;brige f&auml;llt weg. Leer lassen = automatische Kennung.</p>
    <div class="dlgrow">
      <button class="btn sm" id="nameCancel">Sp&auml;ter</button>
      <button class="big" id="nameOk">Speichern und neu starten</button>
    </div>
  </div>
</div>

<script>
"use strict";
var ws=null, armed=false, mode=0, jx=0, jy=0;
/* view: was die Seite zeigt. 2 = "Selbst fahren", passend zu mode 0. */
var view=2;
var curApName="", nameAsked=false, renameRestart=false;
/* Laeuft gerade ein Fahrprogramm? Kommt aus der Telemetrie (pr). */
var progRunning=false;
var tune={kp:0.55,kd:0.08,base:0.55,min:0.35};
var slots=[], slotSteps=[], activeSlot=0, maxSteps=48;
var prog=[], runPc=-1;
function E(id){ return document.getElementById(id) }

/* =================== Befehlsdefinitionen ===================
   Eine Stelle fuer Klartext, Farbe und Drahtformat.            */
var RADTXT=["","sehr eng","eng","eng","mittel","mittel","mittel","weit","weit","sehr weit","sehr weit"];
var LDT=["LED vorne links","LED vorne rechts","LED hinten links","LED hinten rechts",
         "beide LEDs vorne","beide LEDs hinten","alle vier LEDs"];
var LDS=["ausschalten","einschalten","blinken"];
var OPS={
  ge:{c:"drive",txt:function(s){ return "geradeaus mit "+s.a+" %" }},
  li:{c:"drive",txt:function(s){ return "Kurve links, Stufe "+s.a+" ("+RADTXT[s.a]+"), "+s.b+" %" }},
  re:{c:"drive",txt:function(s){ return "Kurve rechts, Stufe "+s.a+" ("+RADTXT[s.a]+"), "+s.b+" %" }},
  fh:{c:"drive",txt:function(s){ return "fahren bis Hindernis in "+s.c+" mm, "+s.a+" %" }},
  tl:{c:"drive",txt:function(s){ return "drehen nach links, bis "+s.c+" mm frei, "+s.a+" %" }},
  tr:{c:"drive",txt:function(s){ return "drehen nach rechts, bis "+s.c+" mm frei, "+s.a+" %" }},
  wf:{c:"wait", txt:function(s){ return "warten, bis "+s.c+" mm frei sind" }},
  dl:{c:"drive",txt:function(s){ return "drehen nach links um "+s.c+"°, "+s.a+" %" }},
  dr:{c:"drive",txt:function(s){ return "drehen nach rechts um "+s.c+"°, "+s.a+" %" }},
  st:{c:"drive",txt:function( ){ return "anhalten" }},
  wa:{c:"wait", txt:function(s){ return "warte "+(s.c/1000).toFixed(1).replace(".",",")+" Sekunden" }},
  ld:{c:"light",txt:function(s){ return LDT[s.a]+" "+LDS[s.b] }},
  bf:{c:"light",txt:function(s){ return "Blinken "+(s.a*0.5).toFixed(1).replace(".",",")+" mal pro Sekunde" }},
  lo:{c:"loop", txt:function(s){ return s.a===0 ? "von vorn wiederholen, endlos"
                                                : "von vorn wiederholen, "+s.a+" mal" }}
};
/* Klartextname je Befehl -- wird in buildOpList() aus den Eintraegen des
   <select> gefuellt, damit die Namen nur an einer Stelle stehen. */
var OPNAME={};

/* Ein Satz je Befehl fuer den Dialog. Beim Fahrprogramm steht man sonst
   vor einem Schieberegler und weiss nicht, was er bewirkt. */
var OPHINT={
  ge:"Fährt geradeaus, bis der nächste Befehl kommt.",
  li:"Fährt eine Linkskurve. Stufe 1 ist die engste.",
  re:"Fährt eine Rechtskurve. Stufe 1 ist die engste.",
  dl:"Dreht auf der Stelle nach links. Braucht den Lagesensor.",
  dr:"Dreht auf der Stelle nach rechts. Braucht den Lagesensor.",
  fh:"Fährt geradeaus und hält vor dem ersten Hindernis.",
  tl:"Dreht nach links, bis der Weg frei ist.",
  tr:"Dreht nach rechts, bis der Weg frei ist.",
  wf:"Bleibt stehen und wartet, bis der Weg frei wird.",
  st:"Hält beide Motoren an. Keine Einstellung nötig.",
  wa:"Bleibt die eingestellte Zeit stehen.",
  ld:"Schaltet eine oder mehrere LEDs ein, aus oder auf Blinken.",
  bf:"Legt fest, wie schnell blinkende LEDs blinken.",
  lo:"Fängt wieder von vorn an. Steht immer als letzte Zeile."
};

function wire(s){
  switch(s.op){
    case "ge": return "ge,"+s.a;
    case "li":
    case "re": return s.op+","+s.a+","+s.b;
    case "dl":
    case "dr":
    case "fh":
    case "tl":
    case "tr": return s.op+","+s.c+","+s.a;
    case "wf": return "wf,"+s.c;
    case "st": return "st";
    case "wa": return "wa,"+s.c;
    case "ld": return "ld,"+s.a+","+s.b;
    case "bf": return "bf,"+s.a;
    case "lo": return "lo,"+s.a;
  }
  return "";
}
function toWire(){ return prog.map(wire).join(";") }
function fromWire(t){
  var out=[];
  (t||"").split(";").forEach(function(seg){
    seg=seg.trim(); if(!seg) return;
    var p=seg.split(","), op=p[0];
    if(!OPS[op]) return;
    var s={op:op,a:0,b:0,c:0};
    if(op==="wa")                       s.c=parseInt(p[1],10)||0;
    else if(op==="wf")                  s.c=parseInt(p[1],10)||0;
    else if(op==="dl"||op==="dr"||op==="fh"||op==="tl"||op==="tr"){
      s.c=parseInt(p[1],10)||0; s.a=parseInt(p[2],10)||0;
    }
    else if(op==="ld"||op==="li"||op==="re"){
      s.a=parseInt(p[1],10)||0; s.b=parseInt(p[2],10)||0;
    }
    else if(op!=="st")                  s.a=parseInt(p[1],10)||0;
    out.push(s);
  });
  return out;
}

/* =================== Verbindung =================== */
function connect(){
  ws=new WebSocket("ws://"+location.hostname+":81/");
  ws.onopen=function(){ E("dot").classList.add("on"); E("conn").textContent="verbunden" };
  ws.onclose=function(){
    E("dot").classList.remove("on"); E("conn").textContent="getrennt";
    armed=false; paintArm(); setTimeout(connect,1000);
  };
  ws.onerror=function(){ try{ ws.close() }catch(e){} };
  ws.onmessage=function(ev){
    var d; try{ d=JSON.parse(ev.data) }catch(e){ return }
    if(d.t==="cfg")   { applyCfg(d);   return }
    if(d.t==="slots") { applySlots(d); return }
    if(d.t==="prog")  { applyProg(d);  return }
    if(d.t==="err")   { renameRestart=false; toast(d.m,false); return }
    if(d.t==="ok")    {
      toast(d.m,true);
      /* Der Netzname wird erst beim Hochfahren gesetzt -- also sofort
         nach der Quittung neu starten. */
      if(renameRestart){ renameRestart=false; setTimeout(function(){ send("Z") },150) }
      return;
    }
    paint(d);
  };
}
function send(s){ if(ws && ws.readyState===1) ws.send(s) }
function toast(m,good){
  var t=E("toast"); t.textContent=m; t.className=good?"ok":"bad";
  clearTimeout(toast._h); toast._h=setTimeout(function(){ t.textContent="" },4000);
}

/* =================== Telemetrie =================== */
var PHASE=["gesperrt","fährt","sucht Linie","Linie verloren","kalibriert…",
           "Akku leer","wartet auf Befehl","Programm beendet","Funktionstest",
           "umgekippt oder hochgehoben","Hindernis voraus"];
var TPH=["LED vorne links","LED vorne rechts","LED hinten links","LED hinten rechts",
         "alle LEDs blinken","Motor links","Motor rechts","Pause",
         "Lagesensor: Drehung rechts","Lagesensor: Drehung links","Abstandssensor"];
var VERD=["","in Ordnung","keine Reaktion – Sensor oder Antrieb",
          "Drehrichtung vertauscht","Sensor meldet sich nicht",
          "nichts im Messbereich"];
var VCLS=["","ok","bad","bad","bad","warn"];
function paint(d){
  E("bL").style.width=(d.sL*100).toFixed(0)+"%";
  E("bR").style.width=(d.sR*100).toFixed(0)+"%";
  var e=Math.max(-1,Math.min(1,d.e));
  E("bE").style.left=(50+Math.min(0,e)*50)+"%";
  E("bE").style.width=(Math.abs(e)*50)+"%";
  var mx=d.dMax||1;
  E("bML").style.width=(d.dL/mx*100).toFixed(0)+"%";
  E("bMR").style.width=(d.dR/mx*100).toFixed(0)+"%";

  if(d.a!==undefined && d.a!==(armed?1:0)){ armed=!!d.a; paintArm() }
  /* Betriebsart vom Roboter uebernehmen -- aber nicht, solange der Nutzer
     den Funktionstest ansieht, sonst wuerde ihn die naechste
     Telemetriezeile sofort wieder herauswerfen. */
  if(d.m!==undefined && d.m!==mode){
    mode=d.m;
    if(view!==0){
      var w={0:2,1:1,2:3}[mode];
      if(w!==undefined && w!==view){ view=w; paintView() } else paintView();
    }
  }
  /* Laeuft der Test, gehoert der Blick auch dorthin. */
  if(d.ts && view!==0){ view=0; paintView() }
  paintRose(d.hd);
  paintLage(d);
  paintHoch(!!d.hoch);

  /* Programmlauf: aktuellen Schritt hervorheben */
  var nowPc = d.pr ? (d.pc>0 ? d.pc-1 : 0) : -1;
  if(nowPc!==runPc){ runPc=nowPc; markStep() }
  progRunning = !!d.pr;
  E("bRun").textContent = d.pr ? "■ Programm stoppen" : "▶ Programm starten";
  E("bRun").style.background = d.pr ? "var(--bad)" : "var(--ok)";
  E("bRun").style.color      = d.pr ? "#fff" : "#06121f";
  E("prun").textContent = d.pr
    ? ("Schritt "+d.pc+" von "+d.pn+"  ·  Durchlauf "+(d.pass+1))
    : (d.p===7 ? "Programm durchgelaufen." : "");

  /* Funktionstest */
  var tb=E("bTest");
  tb.textContent = d.ts ? "■ Funktionstest stoppen" : "Funktionstest starten";
  tb.style.background = d.ts ? "var(--bad)" : "var(--warn)";
  tb.style.color      = d.ts ? "#fff" : "#06121f";
  var tx = TPH[d.tp]||"";
  if(d.tp===5||d.tp===6)      tx += "  ·  "+d.tv+" %";
  else if(d.tp===8||d.tp===9) tx += "  ·  "+(d.ti>0?"+":"")+d.ti+"°";
  else if(d.tp===10)          tx += "  ·  "+(d.ti>0 ? d.ti+" mm" : "nichts in Sicht");
  E("tphase").textContent = d.ts ? tx : "";

  /* Urteile der letzten Sensorpruefung, bleiben nach dem Test stehen */
  var tr=E("tres");
  if(d.tg||d.td){
    tr.innerHTML="";
    [["Lagesensor",d.tg],["Abstandssensor",d.td]].forEach(function(p){
      if(!p[1]) return;
      var e=document.createElement("div");
      e.className=VCLS[p[1]]||"";
      e.textContent=p[0]+": "+VERD[p[1]];
      tr.appendChild(e);
    });
  }

  /* Lagesensor */
  var il=E("imuline");
  if(d.imu){
    il.textContent = "Kurs "+(d.hd>0?"+":"")+d.hd.toFixed(0)+"°"
                   + (d.ic ? "" : "  ·  Nullpunkt fehlt")
                   + (d.dsp ? ("  ·  Abstand "+(d.ds?d.ds+" mm":"frei")) : "");
    il.className = d.ic ? "" : "warn";
  } else {
    il.textContent = "kein Lagesensor – Drehbefehle laufen zeitgesteuert"
                   + (d.dsp ? ("  ·  Abstand "+(d.ds?d.ds+" mm":"frei")) : "");
    il.className = "warn";
  }
  if(d.og!==undefined && document.activeElement!==E("sGuard")){
    E("cGuard").checked = !!d.og;
    if(+E("sGuard").value!==d.om){ E("sGuard").value=d.om; E("vGuard").textContent=d.om }
  }

  var s=E("status"), txt=PHASE[d.p]||"?";
  if(!d.calOk && d.m===1) txt+=" · nicht kalibriert";
  if(d.vb) txt+=" · "+d.vb.toFixed(2)+" V";
  txt+=" · "+d.hz+" Hz";
  s.textContent=txt;
  s.className = (d.p===3||d.p===5) ? "bad"
              : (d.p===2 || (!d.calOk && d.m===1)) ? "warn"
              : (d.p===1) ? "ok" : "";
}
function applyCfg(d){
  tune={kp:d.kp,kd:d.kd,base:d.base,min:d.min};
  if(d.ssid){
    E("vSsid").textContent=d.ssid;
    E("hdr").textContent=d.ssid;
    document.title=d.ssid;
  }
  curApName = d.apname || "";
  /* Erster Start: der Rover hat noch keinen eigenen Namen. Einmal je
     Sitzung fragen -- nicht bei jedem Verbindungsabbruch wieder. */
  if(!nameAsked && !curApName){ nameAsked=true; openName(true) }
  E("sKp").value=Math.round(d.kp*100);     E("vKp").textContent=d.kp.toFixed(2);
  E("sKd").value=Math.round(d.kd*100);     E("vKd").textContent=d.kd.toFixed(2);
  E("sBase").value=Math.round(d.base*100); E("vBase").textContent=Math.round(d.base*100);
  E("sMin").value=Math.round(d.min*100);   E("vMin").textContent=Math.round(d.min*100);
}

/* =================== Speicherplaetze =================== */
function applySlots(d){
  slots=d.n; slotSteps=d.c; activeSlot=d.a; maxSteps=d.max;
  E("gMax").textContent=maxSteps;
  paintSlots();
  send("L,"+activeSlot);
}
function paintSlots(){
  var h=E("slots"); h.innerHTML="";
  slots.forEach(function(name,i){
    var b=document.createElement("button");
    if(i===activeSlot) b.className="sel";
    var n=slotSteps[i]||0;
    b.innerHTML="<span></span><em></em>";
    b.firstChild.textContent=name;
    b.lastChild.textContent = n===0 ? "leer" : (n+" von "+maxSteps+" Schritten");
    b.onclick=function(){ activeSlot=i; paintSlots(); send("L,"+i) };
    h.appendChild(b);
  });
}
function applyProg(d){
  activeSlot=d.slot;
  E("pname").value=d.name;
  prog=fromWire(d.p);
  slotSteps[d.slot]=prog.length;
  paintSlots(); paintSteps();
}

/* =================== Schrittliste =================== */
function paintSteps(){
  var ol=E("steps"); ol.innerHTML="";
  prog.forEach(function(s,i){
    var li=document.createElement("li");
    li.className=OPS[s.op].c;
    var v=document.createElement("var"); v.textContent=(i+1)+".";
    /* Der Text ist ein Knopf: antippen oeffnet denselben Dialog wie beim
       Einfuegen, nur mit den Werten dieses Schritts. Vorher liessen sich
       Schritte nur loeschen oder verschieben, aber nicht aendern. */
    var p=document.createElement("button"); p.type="button"; p.className="stx";
    p.textContent=OPS[s.op].txt(s);
    p.onclick=(function(k){ return function(){ openOp(prog[k].op,k) } })(i);
    var a=document.createElement("div"); a.className="acts";
    a.appendChild(mk("↑",function(){ swap(i,i-1) }));
    a.appendChild(mk("↓",function(){ swap(i,i+1) }));
    a.appendChild(mk("✕",function(){ prog.splice(i,1); paintSteps() },"del"));
    li.appendChild(v); li.appendChild(p); li.appendChild(a);
    ol.appendChild(li);
  });
  E("empty").classList.toggle("hide",prog.length>0);
  paintGauge(); markStep();
}
function mk(t,fn,cls){
  var b=document.createElement("button");
  b.textContent=t; b.onclick=fn; if(cls) b.className=cls;
  return b;
}
function swap(i,j){
  if(j<0||j>=prog.length) return;
  var t=prog[i]; prog[i]=prog[j]; prog[j]=t;
  paintSteps();
}
function markStep(){
  var ls=E("steps").children;
  for(var i=0;i<ls.length;i++) ls[i].classList.toggle("now",i===runPc);
}
function paintGauge(){
  var u=prog.length, f=maxSteps-u;
  E("gUsed").textContent=u;
  E("gFree").textContent=f;
  E("gFree").className = f===0 ? "full" : "";
  var bar=E("gBar");
  bar.style.width=(u/maxSteps*100)+"%";
  bar.className = f===0 ? "full" : "";
}

/* =================== Befehl hinzufuegen =================== */
var PANELS={ge:["pSpd"],li:["pRad","pSpd"],re:["pRad","pSpd"],st:[],
            dl:["pDeg","pSpd"],dr:["pDeg","pSpd"],fh:["pObs","pSpd"],
            tl:["pObs","pSpd"],tr:["pObs","pSpd"],wf:["pObs"],
            wa:["pWa"],ld:["pLd"],bf:["pBf"],lo:["pLo"]};
function paintAddForm(){
  var want=PANELS[E("aOp").value]||[];
  ["pRad","pDeg","pObs","pSpd","pWa","pLd","pBf","pLo"].forEach(function(id){
    E(id).classList.toggle("hide",want.indexOf(id)<0);
  });
}
E("aOp").onchange=paintAddForm;

/* --- Befehlsliste aus dem <select> aufbauen ---
   Die Befehle stehen weiter nur im Markup des <select>; hier entsteht
   daraus die sichtbare Liste. So kann kein Eintrag an einer Stelle
   vergessen werden, und die uebrige Logik liest unveraendert
   E("aOp").value. */
function buildOpList(){
  var sel=E("aOp"), box=E("opList"), gr=sel.getElementsByTagName("optgroup");
  box.innerHTML="";
  for(var i=0;i<gr.length;i++){
    /* Gruppenkopf ist ein Knopf: die Gruppen lassen sich zuklappen, sonst
       waere die Liste aus 14 Befehlen ueber 700 px lang. "Fahren" steht
       offen, das sind die Befehle, die man fast immer braucht. */
    var h=document.createElement("button");
    h.type="button"; h.className="opg";
    h.setAttribute("data-grp",String(i));
    h.innerHTML='<span class="arr">▾</span>'+gr[i].label;
    h.onclick=function(){ toggleGrp(this.getAttribute("data-grp")) };
    box.appendChild(h);

    var wrap=document.createElement("div");
    wrap.className="opgrp"; wrap.setAttribute("data-grp",String(i));
    if(i>0) wrap.classList.add("zu");
    var op=gr[i].getElementsByTagName("option");
    for(var j=0;j<op.length;j++){
      OPNAME[op[j].value]=op[j].textContent;
      var b=document.createElement("button");
      b.type="button"; b.className="opb";
      b.textContent=op[j].textContent;
      b.setAttribute("data-op",op[j].value);
      b.onclick=function(){ openOp(this.getAttribute("data-op"),-1) };
      wrap.appendChild(b);
    }
    box.appendChild(wrap);
    paintGrp(String(i));
  }
}
function toggleGrp(n){
  var w=E("opList").querySelector('.opgrp[data-grp="'+n+'"]');
  w.classList.toggle("zu"); paintGrp(n);
}
function paintGrp(n){
  var w=E("opList").querySelector('.opgrp[data-grp="'+n+'"]');
  var h=E("opList").querySelector('.opg[data-grp="'+n+'"] .arr');
  h.textContent = w.classList.contains("zu") ? "▸" : "▾";
}
function paintOpList(){
  var v=E("aOp").value, b=E("opList").getElementsByClassName("opb");
  for(var i=0;i<b.length;i++)
    b[i].className = (b[i].getAttribute("data-op")===v) ? "opb sel" : "opb";
}
function live(id,out,fn){ E(id).addEventListener("input",function(){ fn(this.value,E(out)) }) }
live("aSpd","vSpd",function(v,o){ o.textContent=v });
live("aDeg","vDeg",function(v,o){ o.textContent=v });
live("aObs","vObs",function(v,o){ o.textContent=v });
live("aRad","vRad",function(v,o){ o.textContent=v; E("tRad").textContent=RADTXT[v|0] });
live("aWa","vWa", function(v,o){ o.textContent=(v/10).toFixed(1).replace(".",",") });
live("aBf","vBf", function(v,o){ o.textContent=v; E("tBf").textContent=(v*0.5).toFixed(1).replace(".",",") });
live("aLo","vLo", function(v,o){ o.textContent=v; E("tLo").textContent = v==="0" ? "endlos" : v+" mal" });

/* --- Formular lesen und schreiben ---
   Beides an einer Stelle, weil der Dialog in zwei Richtungen arbeitet:
   beim Einfuegen liest er die Felder, beim Bearbeiten fuellt er sie
   zuerst aus dem vorhandenen Schritt. */
function readForm(op){
  var s={op:op,a:0,b:0,c:0};
  if(op==="ge") s.a=+E("aSpd").value;
  if(op==="li"||op==="re"){ s.a=+E("aRad").value; s.b=+E("aSpd").value }
  if(op==="dl"||op==="dr"){ s.c=+E("aDeg").value; s.a=+E("aSpd").value }
  if(op==="fh"||op==="tl"||op==="tr"){ s.c=+E("aObs").value; s.a=+E("aSpd").value }
  if(op==="wf") s.c=+E("aObs").value;
  if(op==="wa") s.c=Math.round(E("aWa").value*100);
  if(op==="ld"){ s.a=+E("aLdT").value; s.b=+E("aLdS").value }
  if(op==="bf") s.a=+E("aBf").value;
  if(op==="lo") s.a=+E("aLo").value;
  return s;
}
/* Setzt ein Feld und laesst die Beschriftung darueber nachziehen --
   die haengt an "input", und ein Zuweisen allein loest das nicht aus. */
function setF(id,v){ var e=E(id); e.value=v; e.dispatchEvent(new Event("input")) }
function fillForm(s){
  var op=s.op;
  if(op==="ge") setF("aSpd",s.a);
  if(op==="li"||op==="re"){ setF("aRad",s.a); setF("aSpd",s.b) }
  if(op==="dl"||op==="dr"){ setF("aDeg",s.c); setF("aSpd",s.a) }
  if(op==="fh"||op==="tl"||op==="tr"){ setF("aObs",s.c); setF("aSpd",s.a) }
  if(op==="wf") setF("aObs",s.c);
  if(op==="wa") setF("aWa",Math.round(s.c/100));
  if(op==="ld"){ setF("aLdT",s.a); setF("aLdS",s.b) }
  if(op==="bf") setF("aBf",s.a);
  if(op==="lo") setF("aLo",s.a);
}

/* --- Der Befehlsdialog ---
   opIndex < 0 heisst "neuer Befehl", sonst die Nummer des Schritts, der
   gerade bearbeitet wird. */
var opIndex=-1;
function openOp(op,index){
  opIndex=index;
  E("aOp").value=op; paintOpList(); paintAddForm();
  E("opTitle").textContent=OPNAME[op]||"Befehl";
  E("opHint").textContent=OPHINT[op]||"";
  if(index>=0) fillForm(prog[index]);
  E("opOk").textContent = index<0 ? "Einfügen" : "Änderung speichern";
  E("opOv").hidden=false;
}
function closeOp(){ E("opOv").hidden=true; opIndex=-1 }
E("opCancel").onclick=closeOp;
E("opOk").onclick=function(){
  var op=E("aOp").value, s=readForm(op);
  if(opIndex>=0){                      /* vorhandenen Schritt aendern */
    prog[opIndex]=s; closeOp(); paintSteps(); return;
  }
  if(prog.length>=maxSteps){
    toast("Kein Platz mehr: "+maxSteps+" Schritte sind das Maximum.",false);
    closeOp(); return;
  }
  if(op==="lo"){
    /* "wiederhole" gibt es nur einmal und immer als letzte Zeile */
    prog=prog.filter(function(x){ return x.op!=="lo" });
    prog.push(s);
  } else {
    /* alles andere vor ein vorhandenes "wiederhole" einsortieren */
    var at=prog.findIndex(function(x){ return x.op==="lo" });
    if(at<0) prog.push(s); else prog.splice(at,0,s);
  }
  closeOp(); paintSteps();
};

E("bSave").onclick=function(){
  if(!prog.length){ toast("Das Programm ist leer.",false); return }
  var nm=E("pname").value.trim() || ("Programm "+(activeSlot+1));
  send("W,"+activeSlot+"|"+nm+"|"+toWire());
};
E("bReload").onclick=function(){ send("L,"+activeSlot) };
E("bClear").onclick =function(){ prog=[]; paintSteps() };
E("bRun").onclick   =function(){
  /* Ein Knopf fuer beides. Der Zustand kommt aus der Telemetrie
     und nicht aus der eigenen Beschriftung -- sonst schickt der
     Knopf den falschen Befehl, sobald jemand den Text aendert. */
  send("B,"+(progRunning?0:1));
};

/* =================== Freigabe / Betriebsart =================== */
function paintArm(){
  var b=E("arm");
  b.textContent = armed ? "Motoren sperren" : "Freigeben";
  b.classList.toggle("armed",armed);
}

/* Hoehe der oberen Leiste messen und als --topH hinterlegen. Die
   Startleiste des Fahrprogramms klebt daran statt am Fensterrand, sonst
   schoebe sie sich darunter und der Startknopf waere verdeckt. Fest
   eintragen laesst sich der Wert nicht: er haengt an Schriftgroesse und
   Geraet. */
function messeTopH(){
  var h=document.querySelector(".toprow").getBoundingClientRect().height;
  document.documentElement.style.setProperty("--topH", Math.round(h)+"px");
}
window.addEventListener("resize",messeTopH);
window.addEventListener("orientationchange",messeTopH);
/* --- Betriebsart und Ansicht ---
   Der Funktionstest ist in der Firmware keine Betriebsart, sondern laeuft
   quer dazu ("Diagnose geht vor Betriebsart" in der Hauptschleife). In der
   Bedienung ist er trotzdem eine Flaeche wie die anderen drei, weil man
   ihn dort sucht. Deshalb zwei Begriffe:
     view  0=Funktionstest  1=Linienfolger  2=Selbst fahren  3=Programm
     mode  das, was der Roboter wirklich faehrt (0=manuell,1=Linie,2=Prog)
   Beim Wechsel auf den Funktionstest bleibt die Betriebsart, wie sie war. */
var VIEW2MODE={1:1, 2:0, 3:2};
function paintView(){
  ["mT","m1","m0","m2"].forEach(function(id,i){
    E(id).classList.toggle("sel", view===i);
  });
  E("panTest").classList.toggle("hide",  view!==0);
  E("panAuto").classList.toggle("hide",  view!==1);
  E("panManual").classList.toggle("hide",view!==2);
  E("panProg").classList.toggle("hide",  view!==3);
}
function setView(v){
  view=v; paintView();
  if(VIEW2MODE[v]!==undefined){ mode=VIEW2MODE[v]; send("M,"+mode) }
}
E("arm").onclick =function(){ armed=!armed; paintArm(); send("A,"+(armed?1:0)) };
E("mT").onclick  =function(){ setView(0) };
E("m1").onclick  =function(){ setView(1) };
E("m0").onclick  =function(){ setView(2) };
E("m2").onclick  =function(){ setView(3) };

/* --- Kompassrose ---
   0 Grad oben, im Uhrzeigersinn -- wie bei einem Kompass und wie der
   Drehwinkel in den Fahrbefehlen gezaehlt wird. */
function buildRose(){
  var g=E("roseTicks"), s="";
  for(var a=0;a<360;a+=15){
    var r=(a%45===0)?44:48, b=a*Math.PI/180;
    s+='<line class="'+(a%45===0?"maj":"")+'" '
      +'x1="'+(Math.sin(b)*r).toFixed(1)+'" y1="'+(-Math.cos(b)*r).toFixed(1)+'" '
      +'x2="'+(Math.sin(b)*52).toFixed(1)+'" y2="'+(-Math.cos(b)*52).toFixed(1)+'"/>';
  }
  g.innerHTML=s;
}
var hochWar=false;
function paintHoch(an){
  var e=E("hoch"); if(!e) return;
  if(an===hochWar) return;              // nur bei Wechsel anfassen
  hochWar=an;
  e.classList.toggle("an",an);
  messeTopH();                          // die Leiste ist jetzt hoeher oder flacher
}
function paintLage(d){
  var e=E("lage"); if(!e) return;
  if(d.az===undefined||!d.imu){ e.textContent="kein Lagesensor"; e.className=""; return }
  var raus = (d.az<0.45) || (d.mg<0.55) || (d.mg>1.45) || (d.gcl>0.05);
  var kreisel = "";
  if(d.gpk!==undefined){
    kreisel = " · Kreisel Spitze "+d.gpk.toFixed(0)+" °/s"
            + (d.gcl>0.05 ? " · ANSCHLAG "+d.gcl.toFixed(1)+" %" : "");
  }
  e.innerHTML = "az "+d.az.toFixed(2)+" g · |a| "+d.mg.toFixed(2)+" g"
              + "<span class=\"sp\"> · "+(d.hoch?"außerhalb":"im Fenster")+kreisel+"</span>";
  e.className = raus ? "raus" : "";
}
function paintRose(hd){
  if(hd===undefined||hd===null){ E("roseTxt").textContent="—"; return }
  var a=((hd%360)+360)%360;                 /* auf 0..360 bringen */
  E("roseNeedle").setAttribute("transform","rotate("+a.toFixed(1)+")");
  E("roseTxt").textContent=a.toFixed(0)+"°";
}
E("bStop").onclick=function(){ armed=false; jx=0; jy=0; knob(0,0); paintArm(); send("X") };
E("bCal").onclick =function(){ send("C") };
E("bTest").onclick=function(){
  send("S,"+(E("bTest").textContent.indexOf("stoppen")>0?0:1));
};
E("bCalReset").onclick=function(){ send("R") };

/* =================== Name und Umbenennen ===================
   Der Rover hat keine Anzeige, also ist diese Seite die einzige Stelle,
   an der er einen Namen bekommen kann. Der Name wandert in den
   WLAN-Namen -- und den vergibt der ESP32 beim Hochfahren. Deshalb muss
   nach dem Speichern neu gestartet werden, sonst heisst das Netz bis zum
   naechsten Aus- und Einschalten noch wie vorher.                        */
function nameClean(v){
  /* Dieselbe Regel wie setApName() in RemoteControl.cpp, damit der
     Nutzer vorher sieht, was wirklich gespeichert wird. Umlaute zuerst,
     sonst wuerde aus "Juergen" ein anderer Name als aus "Jürgen". */
  return v.replace(/ä/g,"ae").replace(/Ä/g,"Ae")
          .replace(/ö/g,"oe").replace(/Ö/g,"Oe")
          .replace(/ü/g,"ue").replace(/Ü/g,"Ue")
          .replace(/ß/g,"ss")
          .replace(/[^A-Za-z0-9 _-]/g,"").replace(/[ \-_]/g,"_").slice(0,16);
}
function namePreview(){
  var c=nameClean(E("nameIn").value);
  E("namePrev").textContent = c ? ("MarsRover_"+c) : "MarsRover_<Kennung>";
}
function openName(first){
  E("nameTitle").textContent = first ? "Wie soll dein Rover heißen?"
                                     : "Roboter umbenennen";
  E("nameIntro").textContent = first
    ? "Er fährt schon, hat aber noch keinen Namen. Gib ihm einen – "
      + "so erkennst du ihn später im WLAN wieder, auch wenn mehrere "
      + "nebeneinander stehen."
    : "Der Name steht im WLAN-Namen. Nach dem Speichern startet der Rover "
      + "neu, damit das Netz sofort richtig heißt.";
  E("nameCancel").textContent = first ? "Später" : "Abbrechen";
  E("nameIn").value = curApName;
  namePreview();
  E("nameOv").hidden = false;
  setTimeout(function(){ try{ E("nameIn").focus() }catch(e){} },50);
}
function closeName(){ E("nameOv").hidden = true }
E("nameIn").addEventListener("input",namePreview);
E("bRename").onclick  = function(){ openName(false) };
E("bRename2").onclick = function(){ openName(false) };
E("nameCancel").onclick = closeName;
E("nameOk").onclick = function(){
  renameRestart = true;
  send("N|"+nameClean(E("nameIn").value));
  closeName();
  toast("Gespeichert – der Rover startet neu. Danach ins neue WLAN wechseln.",true);
  /* Falls die Quittung ausbleibt, trotzdem neu starten. */
  clearTimeout(openName._h);
  openName._h = setTimeout(function(){
    if(renameRestart){ renameRestart=false; send("Z") }
  },1500);
};
E("bGyro").onclick    =function(){ send("G"); toast("Nullpunkt wird aufgenommen – Roboter ruhig halten.",true) };
function sendGuard(){ send("O,"+(E("cGuard").checked?1:0)+","+E("sGuard").value) }
E("cGuard").onchange=sendGuard;
E("sGuard").addEventListener("input",function(){ E("vGuard").textContent=this.value; sendGuard() });

/* =================== Feinabstimmung =================== */
function sendTune(){
  send("T,"+tune.kp.toFixed(3)+","+tune.kd.toFixed(3)+","+
       tune.base.toFixed(3)+","+tune.min.toFixed(3));
}
function slider(id,out,key,fmt){
  E(id).addEventListener("input",function(){
    var v=this.value/100; tune[key]=v;
    E(out).textContent=fmt(v);
    sendTune();
  });
}
slider("sKp","vKp","kp",function(v){ return v.toFixed(2) });
slider("sKd","vKd","kd",function(v){ return v.toFixed(2) });
slider("sBase","vBase","base",function(v){ return Math.round(v*100) });
slider("sMin","vMin","min",function(v){ return Math.round(v*100) });

/* =================== Joystick ===================
   Der Knopf ist 30 % des Feldes breit, sein Radius also 15 %. Eine
   Verschiebung in Prozent bezieht sich in CSS auf die EIGENE Breite --
   bei 50 % kam der Knopf deshalb nur 15 % des Feldes vom Mittelpunkt weg,
   waehrend der Finger bis zum Rand (50 %) ging. Damit der Knopf dem Finger
   folgt und innen bleibt, darf sein Mittelpunkt bis 50 % - 15 % = 35 % des
   Feldes wandern; auf die Knopfbreite gerechnet sind das 35/30 = 116 %.   */
var KNOB_TRAVEL = 116;
var pad=E("pad"), active=false;
function knob(x,y){
  E("knob").style.transform =
    "translate("+(x*KNOB_TRAVEL)+"%,"+(-y*KNOB_TRAVEL)+"%)";
}
function fromEvent(ev){
  var r=pad.getBoundingClientRect();
  var x=(ev.clientX-r.left)/r.width*2-1;
  var y=1-(ev.clientY-r.top)/r.height*2;
  var m=Math.sqrt(x*x+y*y);
  if(m>1){ x/=m; y/=m }            /* auf den Einheitskreis begrenzen */
  jx=x; jy=y; knob(x,y);
}
pad.addEventListener("pointerdown",function(ev){
  active=true;
  try{ pad.setPointerCapture(ev.pointerId) }catch(e){}
  fromEvent(ev); ev.preventDefault();
});
pad.addEventListener("pointermove",function(ev){
  if(active){ fromEvent(ev); ev.preventDefault() }
});
function release(ev){
  active=false; jx=0; jy=0; knob(0,0);
  if(ev && ev.preventDefault) ev.preventDefault();
}
pad.addEventListener("pointerup",release);
pad.addEventListener("pointercancel",release);
window.addEventListener("blur",function(){ release(null) });

/* Zoom-Gesten von Safari unterdruecken */
document.addEventListener("gesturestart",function(e){ e.preventDefault() });
document.addEventListener("dblclick",function(e){ e.preventDefault() });

/* =================== Sendeschleife: 10 Hz =================== */
setInterval(function(){
  if(!ws || ws.readyState!==1) return;
  if(mode===0) send("J,"+jx.toFixed(3)+","+jy.toFixed(3));
  else         send("P");
},100);

buildOpList(); paintOpList(); buildRose(); paintRose(undefined); messeTopH();
paintArm(); paintView(); paintAddForm(); paintSteps(); connect();
</script>
</body>
</html>
)BBUI";
