Darklirah/One-of-a-Kind-Mars-Rover/(commit log)

2026-10-11 Befehlsdialog: einfuegen und vorhandene Schritte aendern (0.3.0)
    Die Luecke: ein gespeichertes Programm war nur zum Teil bearbeitbar.
    Schritte liessen sich verschieben und loeschen, aber ihre Werte nicht
    aendern -- aus "geradeaus mit 60 %" wurden 25 % nur ueber Loeschen und
    neu Einfuegen.
    Jetzt ein Fenster fuer beides. Antippen eines Befehls in der Liste oeffnet
    es mit "Einfuegen", Antippen des Texts eines Schritts im Ablauf mit
    dessen Werten und "Aenderung speichern". Dazu je ein Satz, was der
    Befehl tut.
    Warum ein Fenster und kein Scrollbereich mit festem Einfuegeknopf:
    - 13 der 14 Befehle brauchen eine Einstellung, nur "anhalten" nicht --
    es gibt also nie "antippen und fertig"
    - im Sc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
2026-10-11 Installer und Doku: BOOT-Taste halten, bis das Flashen beginnt
    Auf der Installerseite als eigene Schritte 4 bis 6 und als rot
    abgesetzter Kasten: die Taste muss gedrueckt bleiben, bis der
    Fortschrittsbalken laeuft. Zu frueh losgelassen bricht es mit
    "Failed to connect to ESP32" ab -- das ist die haeufigste Ursache und
    sah bisher nach einem Defekt aus.
    Dazu der Griff fuer Boards, bei denen BOOT allein nicht reicht: BOOT
    halten, EN kurz druecken, BOOT weiter halten. Boards mit automatischer
    Umschaltung brauchen nichts davon.
    Derselbe Hinweis in Doku/07 bei Schritt 3, damit Installerseite und
    Inbetriebnahme dasselbe sagen.
2026-10-11 Log: stehender Abschnitt fuer die offenen Punkte zum Projektabschluss
    Bisher lagen die vertagten Aufgaben verstreut in Tagebucheintraegen und
    waren damit praktisch nicht wiederzufinden. Jetzt ein stehendes
    Verzeichnis ganz oben im Log, getrennt von der Chronologie.
    Neu darin die beiden Punkte vom Flasher, ausdruecklich vertagt:
    - Dialog eindeutschen. ESP Web Tools hat kein i18n -- im Bundle gibt es
    keine Sprachumschaltung, die einzige durchgereichte Anpassung ist
    overrides.checkSameFirmware. Machbar ueber eine Uebersetzungsschicht
    zur Laufzeit, der Shadow-Root des Dialogs ist mode:"open".
    - esp-web-tools@10 auf eine feste Version nageln. @10 heisst "neueste
    10.x", der Flasher kann s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
2026-10-11 mDNS und eine Weiche im Anmeldefenster (0.4.0)
    Die Frage war, ob die Bedienseite beim Oeffnen des Browsers von selbst
    laedt. Teilweise ging das schon -- der DNS zeigt jeden Namen auf den
    Roboter, also landet jede http://-Adresse bei ihm. Zwei Dinge standen im
    Weg:
    - Startseiten sind heute https://. Dafuer braeuchte der Roboter ein
    gueltiges Zertifikat fuer eine fremde Domain; das waere ein Angriff und
    der Browser wuerde es zu Recht melden. Nicht loesbar.
    - Das Anmeldefenster ist nicht der richtige Browser. iOS oeffnet dafuer
    eine eingeschraenkte WebView, in der WebSockets oft nicht laufen. Der
    Roboter lieferte dort bisher die volle Oberflaeche aus -- sie erschien,
    der Joystick tat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
2026-10-11 Gehaeuse und Fahrwerk: CAD-Entwurf V2, Doku/11, Bauanleitung
    Neuer Ordner Gehaeuse_CAD mit parametrischen FreeCAD-Skripten, den
    Druckteilen als STL/STEP, einfachen Modellen der Zukaufteile und einer
    Liste mit Drucklage und Gewicht. Der fruehere Stand mit Akku unter der
    Platine liegt als V1 daneben.
    Doku/11 zeigt das Gehaeuse in fuenf Ansichten aus dem Modell. "Ich baue
    meinen Marsrover" ist die Bauanleitung in 17 Schritten mit Bildern:
    THT-Bestueckung, Zusammenbau, Einbau der Platine, Verkabelung des
    VL53L0X im Mast.
    Nichts davon ist gedruckt oder gebaut; geprueft ist nur am Modell. Die
    FreeCAD-Arbeitsdateien mit bestueckter Platine bleiben lokal, weil sie
    Fremdmodelle enthalten.
    Co-Autho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
    [Bodenschale.step, Bodenschale.stl, Buerstentraeger_L.step, Buerstentraeger_L.stl, Buerstentraeger_R.step, Buerstentraeger_R.stl, CFK_Stab_3x70.step, LiPo_503035.step]
2026-10-11 Gekaufte Teile nachgetragen, Modulbelegung, Druckeinstellungen
    Stueckliste: Zylindermotor 12 x 22,5 mm statt Muenzmotor, TP4056 mit
    Mini-USB ohne Schutzschaltung, MT3608 36 x 17 mm, VL53L0X-Modul,
    Buerstenkopf 50 x 15 x 18 mm, Platinenmass 70 x 52 mm berichtigt.
    Pinbelegung: neuer Abschnitt mit der Belegung von U2, U5, U6, U7, M1/M2
    und J2, ausgelesen aus der Platinendatei. Mit dem gekauften TP4056
    (vier Pads) muessen an U2 Pin 3 und Pin 5 gebrueckt werden, sonst
    bleibt der Rover stromlos. Titel auf DevKitC V4 38-Pin berichtigt.
    Gehaeuse_CAD: Drucktabelle um Schichthoehe, Wandlinien und Infill
    ergaenzt, dazu Startwerte fuer PETG und TPU. Bauanleitung nennt jetzt
    die Pinfolge an U7 und die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
2026-10-11 Log: offene Fragen zum Gehaeuse fuer die naechste Sitzung
    Stehendes Verzeichnis: was am echten Teil nachzusehen oder zu messen
    ist (Schutzplatine am Akku, Loetaugen des MT3608, Einbaulage der
    Module, Stiftueberstand, Motorgewicht und -strom, Buerstenkopf) und
    was zu entscheiden ist (Gewicht, Akkuverriegelung, Optik, Probedruck).
2026-10-11 Bauanleitung: Akku zuerst in die Tasche, dann anstecken, dann Platine einrasten
    Schritt 16 und 17 zusammengelegt und die Reihenfolge klargestellt: der
    Akkustecker sitzt unter der Platine und ist nach dem Einrasten nicht
    mehr erreichbar.
2026-10-11 Log: Idee anderes Rechenboard mit Akkuladung (LOLIN32, XIAO ESP32-C3)
2026-10-11 Log: weitere Boardvorschlaege mit Vor- und Nachteilen (C3 SuperMini, D1 Mini, C6)
2026-10-11 Log: Waveshare ESP32-C3-Zero als Kandidat, Probe-Build bestanden
2026-10-11 Log: ESP32-S3-Zero und Vormerkung fuer Version 2
2026-10-11 Log: Platzierung des Funkmoduls und Idee externe Antenne
2026-10-11 Log: Antennenbauformen und Empfehlung zur externen Antenne
2026-10-16 Update README with PCB error warning and project support
    Added a warning about errors in the first PCB and a note about project support.
2026-10-16 Revise error notice for first circuit board
    Updated warning message about the first circuit board errors.
2026-10-21 Vier Betriebsarten, Kompassrose, Startleiste oben (0.5.0)
    Funktionstest ist jetzt eine Betriebsart. Er steckte als Karte weit unten
    in der Seite, wo ihn niemand sucht. Die Wahl hat jetzt vier Flaechen in
    der Reihenfolge, in der man die Dinge tut: Funktionstest, Linienfolger,
    Selbst fahren, Programm.
    Technisch ist er weiterhin keine Betriebsart -- in der Hauptschleife gilt
    "Diagnose geht vor Betriebsart". Deshalb trennt die Bedienung jetzt view
    (was die Seite zeigt) von mode (was der Roboter faehrt). Beim Umschalten
    auf den Funktionstest bleibt die Betriebsart, wie sie war, und es geht
    kein M,... hinaus. Laeuft der Test, springt die Ansicht von selbst
    dorthin, und die Telemetrie wirft einen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
2026-10-21 README: Warnhinweis als Warnkasten, mit Verweis auf die Befundliste
    Wortlaut unveraendert, nur die Form: mit fuehrendem Leerzeichen wurde
    daraus eine zweite H1 neben dem Projekttitel. Jetzt ein GitHub-Warnkasten,
    dazu der Verweis auf die Befundliste im Projekt-Log und der Hinweis, dass
    die Firmware davon nicht betroffen ist -- die laeuft auf einem nackten
    DevKit.
2026-10-21 Nothalt nach oben neben die Freigabe, Programmknopf entkoppelt (0.5.1)
    Der Nothalt sass am Seitenende -- genau dort, wo man ihn nicht findet,
    wenn es eilt. Jetzt oben in einer Zeile mit der Freigabe, Aufteilung
    1,35 zu 1.
    Dabei ein Darstellungsproblem geloest, das sonst entstanden waere: bei
    freigegebenen Motoren heisst der linke Knopf "Motoren sperren" und ist
    gefuellt rot. Zwei gleich aussehende rote Flaechen nebeneinander waeren
    im Ernstfall die falsche Wahlhilfe. Der Nothalt ist deshalb nur umrandet
    und fuellt sich erst beim Druecken.
    Der Programmknopf war bereits einer: bRun schaltet seit jeher
    Beschriftung, Farbe und Funktion um. Eine Schwachstelle steckte aber
    darin -- er las seinen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
2026-10-21 Beide Leisten kleben jetzt (0.5.2)
    Der Nothalt scrollte noch mit weg. Jetzt klebt die obere Zeile
    (Freigeben, NOTHALT) am Fensterrand, und die Startleiste des
    Fahrprogramms klebt an deren Unterkante statt am Fensterrand -- sonst
    schoebe sie sich darunter und der Startknopf waere verdeckt. Genau das
    war gemeint mit "der Programmstartknopf fehlt noch in der Ansicht".
    Die Hoehe der oberen Leiste laesst sich nicht fest eintragen, sie haengt
    an Schriftgroesse und Geraet. Sie wird beim Start gemessen und als --topH
    hinterlegt, bei Groessen- und Lagewechsel neu.
    Nachgemessen bei 1200 px Scrollweg: obere Leiste 0 bis 78 px, Startleiste
    klebt bei 78 px, Ueberlappung 0 px, beide vollstaendig im Bild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
2026-10-21 Bilder und Beschreibung auf den Stand 0.5.2, Arbeitsstaende aufgenommen
    Am Quelltext hat sich seit 0.5.2 nichts geaendert. Ein Neubau ergab ein
    bitgleiches Abbild (SHA-256 e09462c2..., 1.037.216 Byte) -- statt eine
    Version hochzuzaehlen, hinter der nichts steckt, ist das nachgeprueft und
    so geblieben.
    Die Bilder in der Doku zeigten noch den alten Aufbau: drei Betriebsarten,
    Nothalt am Seitenende, Programmeditor ohne Startleiste. Alle sechs neu
    aufgenommen, dazu app_test.jpg als siebtes -- der Funktionstest mit der
    Kompassrose, den es als Ansicht vorher nicht gab. app_befehle.jpg zeigt
    jetzt zugleich den Scrollzustand mit beiden klebenden Leisten.
    Doku/06 bekommt einen eigenen Abschnitt "Fu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
    [MarsRover.csv, Platte1_PETG.3mf, Platte1_TPU.3mf]
2026-10-21 Leiterplattendaten als nicht voll funktionsfaehig gekennzeichnet
    Die Befundliste zur Revision 1 stand bisher nur im Projekt-Log. Wer direkt
    in Fertigung/ einsteigt, findet dort saubere Gerber und ein DRC mit 0
    Fehlern -- und bestellt. Die Fehler stecken nicht im Layout, sondern in der
    Zuordnung zu den echten Modulen; in den Daten sieht man davon nichts.
    Warnung an jeder Einstiegsstelle:
    * Fertigung/README.md -- CAUTION-Block oben, Stand auf "in Bearbeitung"
    * pcb/README.md -- neu; Befundtabelle, Dateiuebersicht, Sperrdatei-Regel
    * Fertigung/WARNUNG-NICHT-BESTELLEN.txt -- neu, reiner Text
    * Doku/03, Doku/04, Bauanleitung -- derselbe Block
    erzeuge_fertigungsdaten.sh legt die Textwarnung jet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
    [MarsRover-platine.step]
2026-10-25 Gehaeuse V2: Platinenhalter 1,6+0,3, breite Motorschelle, Kabelbinder-Oese, Mast-Pegs
    Platinenhalter auf die echte Platine: BT ist jetzt die reale Dicke 1,6 mm,
    SPIEL_B = 0.3 das Spiel, KL = 1.9 der Klemmspalt. Noetig, weil das Skript von
    sich aus noch 0,1 mm aufschlug -- ein erster Anlauf mit BT = 1.9 ergab 2,03
    statt 1,9. Dabei fiel eine fest eingetragene 1.1 im Innenausschnitt auf, die
    zufaellig BT + 0.1 war und beim Dickenwechsel zurueckgeblieben waere.
    Motormount: eine 10 mm breite Schelle statt zweier 4-mm-Schellen, Bohrung von
    D12,2 auf D11,90 (Klemmsitz bei D12,0 Motor). Maul unveraendert bei 8,4 -- die
    Schelle ist jetzt zweieinhalbmal so steif, enger haette das Einclipsen
    erschwert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
    [Bodenschale.step, Bodenschale.stl, Buerstentraeger_L.step, Buerstentraeger_L.stl, Buerstentraeger_R.step, Buerstentraeger_R.stl, Holzspiess_3x70.step, LiPo_503035.step]
2026-10-25 Mast ist jetzt ueberall ein Holz-Schaschlikspiess, neues Bild von vorn links
    Alle sechs Doku-Stellen nachgezogen: Doku/03 (Stueckliste und Massebilanz),
    Doku/04, Bauanleitung, Gehaeuse_CAD/README, Hardware/Netzliste und die
    Antennen-Notizen im Projekt-Log.
    Mitgerechnet statt nur umbenannt: Masse 0,6 -> 0,3 g, Preis 0,80 -> 0,05 EUR,
    Mast-Zubehoer 7,10 -> 6,35 EUR, Materialpreis 33,60 -> 32,85 EUR, Gesamtmasse
    ~45 -> ~44 g, davon oben auf dem Mast 2 -> gut 1,5 g.
    Zwei inhaltliche Folgen, nicht nur Wortlaut:
    * Holz ist weicher als Kohlefaser, der Mast peitscht staerker. Fuer eine
    Laufzeitmessung, die ueber 33 ms mittelt, unkritisch -- die Begruendung
    stand in Doku/04 schon direkt unter d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
2026-10-25 Titelbild: Rover in eine echte Marslandschaft gesetzt, Quelle im Bild
    Der Rover ist aus FreeCAD mit transparentem Hintergrund freigestellt
    (965483 durchsichtige zu 204517 deckenden Pixeln, keine weichen Kanten) und
    sitzt jetzt in einem Ausschnitt von NASA/JPL-Caltech/MSSS, PIA20840 --
    Murray Buttes im Gale-Krater, aufgenommen von Curiosity. Die Quelle steht
    im Bild selbst und in beiden Bildunterschriften.
    Der Ausschnitt ist gesucht, nicht geraten: ein Suchlauf ueber das 10000 x
    2848 grosse Original bewertet Fenster im Verhaeltnis 1300:900 danach,
    wieviel schwarzer Stitching-Rand und wieviel graue Technik darin liegt.
    Curiosity fotografiert sich auf solchen Panoramen selbst mit, und das
    frem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
2026-10-25 Titelbild natuerlicher: Licht angeglichen, Kanten weich, Staubwolke davor
    Der erste Wurf sah nach aufgeklebt aus. Gegenmittel, alle als Stellschrauben
    in Gehaeuse_CAD/montage_marslandschaft.py:
    * kleiner und hoeher gesetzt (44 % Bildbreite, Aufstandslinie bei 80 %)
    * Alphakante 1,6 px weichgezeichnet und nachgezogen, damit sie nicht
    aufquillt; Farbkanal um 0,7 px entschaerft
    * Beleuchtung: FreeCAD leuchtet aus der Kamera, gleichmaessig. Im
    Hintergrund steht die Sonne oben links -- an den Steinen abgelesen, helle
    Flanke links, Schatten nach rechts unten. Also gerichteter Verlauf
    +-24 %, dazu 10 % dunkler, waermerer Grundton, 20 % weniger Farbigkeit
    * weicher Wurfschatten nach rechts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
2026-10-25 Schlagschatten deutlicher: multiplizierend statt aufgelegt, gestreckt und geschert
    Der Schatten legte bisher eine dunkle Farbe auf. Unter dem Rover liegt im
    Originalfoto aber schon dunkler Boden -- dort geht ein aufgelegter Fleck
    schlicht unter. Jetzt multipliziert er: der Kern geht auf 30 % der
    vorhandenen Helligkeit, was auf hellem wie auf dunklem Untergrund wirkt.
    Dazu ein leichter rotbrauner Stich, weil ein Marsschatten nicht neutral ist.
    Form statt Fleck: auf 34 % der Rover-Hoehe verlaengert, um 55 % der Breite in
    Sonnenrichtung geschert und etwas verbreitert, Weichzeichnung von 11 auf 9 px
    zurueck. Der Kontaktschatten unter dem Fahrwerk bleibt scharf.
    Die hinterste Staubschwade lag g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
2026-10-25 Titelbild: Rover eingesenkt, weiter hinten, Gebrauchsspuren, Staubfahne
    Er schwebte, weil er genau auf der Aufstandslinie endete. Echte Fahrzeuge
    verschwinden mit den Aufstandspunkten im Sand -- jetzt sitzt er 10,5 % seiner
    Hoehe tiefer, der Staub am Fuss deckt den Uebergang. Dazu weiter nach hinten:
    37 statt 44 % der Bildbreite, Aufstandslinie von 80 auf 73 % hoch.
    Gebrauchsspuren in vier Lagen: Staubfilm (unten dicker, Staub wird von unten
    hochgeworfen), in Y gezogene Schlieren, feines Korn, Schmutz in den Fugen.
    Die Fugen findet die Differenz zum weichgezeichneten Bild -- wo es dunkler
    ist als seine Unschaerfe, sitzt eine Kante. Erster Versuch war zu stark:
    jede CAD-Kante bekam einen sch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
2026-10-25 Rover steckt jetzt im Boden statt davorzukleben, neuer Freisteller ohne Knotenpunkte
    Tiefer setzen half nicht, der Grund war grundsaetzlicher: ein eingesetztes
    Bild liegt VOLLSTAENDIG oben auf, es gibt keinen Boden vor ihm. Jetzt wird
    die Silhouette unterhalb der Auflagelinie ausgeblendet -- erst dadurch
    steckt er drin.
    Die Linie darf nicht waagerecht sein, in der Isometrie ist die Standebene
    schraeg. Das Skript sucht sie aus den beiden Auflagepunkten: dem tiefsten
    Punkt der linken und dem der rechten Silhouettenhaelfte, hier (155, 270) und
    (306, 354), Neigung 0,56. Zwei Irrwege davor sind im Log vermerkt -- eine
    waagerechte Linie schnitt die hintere Seite falsch ab, und die untere
    konvexe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
2026-10-25 Zweite Fassung des Titelbilds mit weicherer Beleuchtung in die Beschreibung
    Doku/11 zeigt jetzt beide Fassungen untereinander: gehaeuse_vorn.jpg mit dem
    kontrastreicheren Modell, darunter gehaeuse_vorn_weich.jpg mit der weicheren
    Beleuchtung aus FreeCAD. Alle Montage-Werte sind identisch -- Auflagepunkte,
    Schatten, Staubfahne und Staubwolke sind nachgerechnet gleich, nur der
    Freisteller ist ein anderer. Moeglich, weil das Skript Quelle und Ziel als
    Argumente nimmt.
    Die Bildunterschrift benennt den Unterschied: der Rover geht in der weichen
    Fassung staerker in der Landschaft auf, dafuer treten Mast und Platine
    weniger hervor.
2026-10-27 Kippschutz nimmt waehrend der Fahrt nicht mehr die Freigabe weg (0.5.3)
    Befund: beim Programmstart wie bei Handfahrt laufen die Motoren kurz, dann
    ist die Freigabe zurueckgesetzt.
    Drei Stellen koennen die Freigabe von sich aus wegnehmen, zwei liessen sich
    am Quelltext ausschliessen: der Akkuwaechter ist mit
    FEATURE_BATTERY_MONITOR=0 gar nicht einkompiliert, und die App sendet beim
    Verbinden kein A,0 -- sie uebernimmt den Zustand aus der Telemetrie. Bleibt
    imu.tipped() || imu.lifted(), und der MPU-6050 ist angeschlossen.
    Der Hochhebe-Erkenner schlaegt an, wenn der gefilterte Betrag der
    Beschleunigung laenger als 500 ms ausserhalb von 0,55..1,45 g liegt. Der
    Tiefpass hat 0,25 s Zeitkonstante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
2026-10-27 Kippschutz ganz raus, blinkendes Feld statt Abschaltung, Lenkung trennt die Seiten (0.5.4)
    Rueckmeldung zu 0.5.3: Ruecksetzer seltener, aber nicht weg. Erklaerbar --
    in 0.5.3 ruhte der Waechter nur, solange die Motoren liefen. _lifted bleibt
    aber gesetzt, bis der gefilterte Betrag ins Fenster zurueckkehrt, und der
    Tiefpass braucht dafuer 0,25 s. Jede kurze Pause zwischen zwei
    Programmschritten oder beim Loslassen des Joysticks reichte: 400 ms nach dem
    Anhalten war der Waechter wieder scharf, das Kennzeichen noch gesetzt.
    Jetzt greift der Kippschutz gar nicht mehr in die Steuerung ein. Erkannt und
    gemeldet wird weiter: ganz oben in der klebenden Kopfleiste, ueber Freigabe
    und Nothalt, blinkt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
2026-10-27 Kreisel schlug an: Messbereich auf +-2000 deg/s, Kurs nullt sich selbst (0.5.5)
    Befund: eine echte 90-Grad-Drehung wurde als etwa 17 Grad angezeigt, bei
    laufenden Motoren. Der Sensor haengt an Draehten und kann schwingen.
    IMU_GYRO_FS stand auf 1, also +-500 deg/s. Ein Sensor, der an Draehten ueber
    einem Ruettelantrieb haengt, ueberschreitet das muehelos. Ein anschlagender
    Kreisel verliert dabei nicht irgendetwas, sondern genau das Gesuchte: liegt
    die echte Drehung als Gleichanteil unter der Schwingung, wird von der einen
    Seite mehr abgeschnitten als von der anderen, und die Differenz der beiden
    Spitzen ist die Drehung. Das Verhaeltnis 90 zu 17 passt dazu.
    Beim Beschleunigungssensor war der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
2026-10-27 Verbesserungen am Geraet als stehenden Abschnitt aufgenommen
    Zuoberst im Log, vor den uebrigen stehenden Verzeichnissen -- beide Punkte
    machen Messungen und Fahrversuche unzuverlaessig, solange sie offen sind.
    Nachjustieren an der Firmware laeuft bis dahin ins Leere.
    * MPU-6050 MUSS fest montiert werden. Haengt an Draehten und misst so vor
    allem sich selbst; eine echte 90-Grad-Drehung kam als 17 Grad an. Mit dem
    Wie (Schaumstoff-Klebeband, nahe der Drehachse, Stiftleisten abknipsen) und
    der Gegenprobe (Kreisel-Spitze unter der Kompassrose).
    * Biegehilfe fuer die Buerstenborsten drucken. Gerade Borsten geben dem Rover
    keine Vorzugsrichtung, daher die Seitendrift. Mit Verfahren, Zielw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
2026-10-31 Biegelehre fuer die Buerstenborsten entworfen
    Gefordert war: Kopf einschieben, und er wird gehalten, bis er erkaltet ist.
    Daraus wurde ein U-Kanal, der ohne Klemme und ohne Schraube haelt.
    Wie sie haelt: der Schlitz ist genau Borstenlaenge * cos(Winkel) hoch, bei
    25 Grad also 10,88 statt 12 mm, plus 6 mm Kopfplatte -- Boden bis
    Lippenunterseite 16,88 mm. Beim Einschieben druecken die Borsten die Platte
    nach oben gegen die beiden Haltelippen. Die Borsten sind selbst die Feder.
    Wie der Winkel entsteht: die Spitzen schleifen auf der Pressflaeche und
    bleiben gegenueber der Platte zurueck, legen sich also entgegen der
    Schubrichtung um. Drei erhabene Pfeile auf der Seitenwand zeigen die
    SCHUBric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
    [Biegelehre_Borsten.step, Biegelehre_Borsten.stl, MarsRover_Biegelehre.FCStd]
2026-10-31 Vorgehen festgehalten: erst nackter Geradeauslauf, dann Steuerung
    Vom Nutzer festgelegt und als oberster stehender Abschnitt im Log, vor den
    Verbesserungen am Geraet.
    Der Grund steckt in der Fehlersuche der letzten Tage: laeuft das Fahrwerk
    nicht von sich aus geradeaus, regelt man gegen eine Grundstoerung an, und
    jeder Messwert hat zwei moegliche Ursachen. Die Seitendrift kam von geraden
    Borsten, nicht vom Regler; die 17 statt 90 Grad vom anschlagenden Kreisel,
    nicht von der Mechanik.
    Stufe 0 ist definiert: Handbetrieb, Joystick gerade nach vorn, Spur ueber
    mehrere Meter halten. Davor in dieser Reihenfolge Borsten neigen, Motoren
    gegenlaeufig, Symmetrie pruefen.
    Mit vermerkt, weil es sons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
